f-labaj/Equatorial-Mount-MUM/Rendery/main_assembly_no_tele_CUT.png

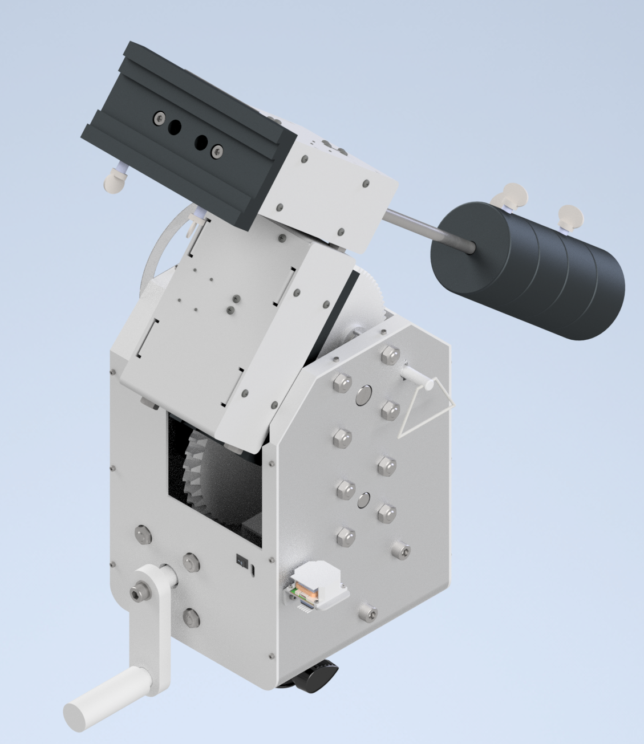
Rendery/main_assembly_no_tele_CUT.png
