f-labaj/Equatorial-Mount-MUM/Rendery/elevation_assembly_blacha_gieta_final.png

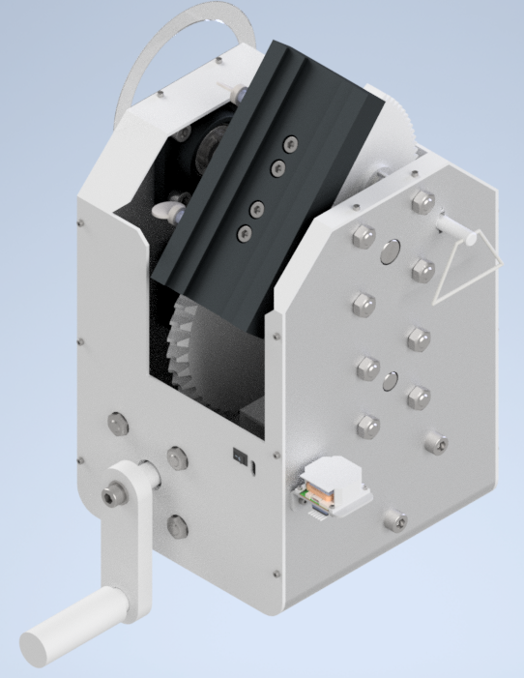
Rendery/elevation_assembly_blacha_gieta_final.png
