f-labaj/Equatorial-Mount-MUM/README.md

# Equatorial-Mount-MUM

Projekt autonomicznego montażu równikowego teleskopu wykonany jako zaliczenie przedmiotu Miniaturyzacja Urządzeń Mechatroniki na Wydziale Mechatroniki Politechniki Warszawskiej.
