f-labaj/Equatorial-Mount-MUM/Mechanika/Mechanizm elewacji i elektronika Filip/Links.txt

http://www.mitcalc.com/doc/gear4/help/en/gear4.htm

http://www.otvinta.com/rack.html

http://www3.telus.net/shebang/worm_gear_calculator.html

https://www.engineersedge.com/gears/worm_gear_formula_table_13534.htm

https://www.engineersedge.com/gears/worm_and_wormgear_design_13813.htm

https://en.wikipedia.org/wiki/Worm_drive - ślimak i zębatka ślimakowa

https://www.youtube.com/watch?v=pTLBtd6kPm8 - projektowanie ślimaka w Inventorze

https://en.wikipedia.org/wiki/Slider-crank_linkage - mechanizm korbowy
