f-labaj/Equatorial-Mount-MUM/Mechanika/Mechanizm elewacji i elektronika Filip/CAD/SKF 16006/Linki.txt

https://www.skf.com/group/products/rolling-bearings/ball-bearings/deep-groove-ball-bearings/productid-16006

https://www.ebmia.pl/lozyska-kulkowe-zwykle/70491-lozysko-kulkowe-zwykle-16006-a-2zfag.html
