f-labaj/Equatorial-Mount-MUM/Dokumentacja/17.05.20.png

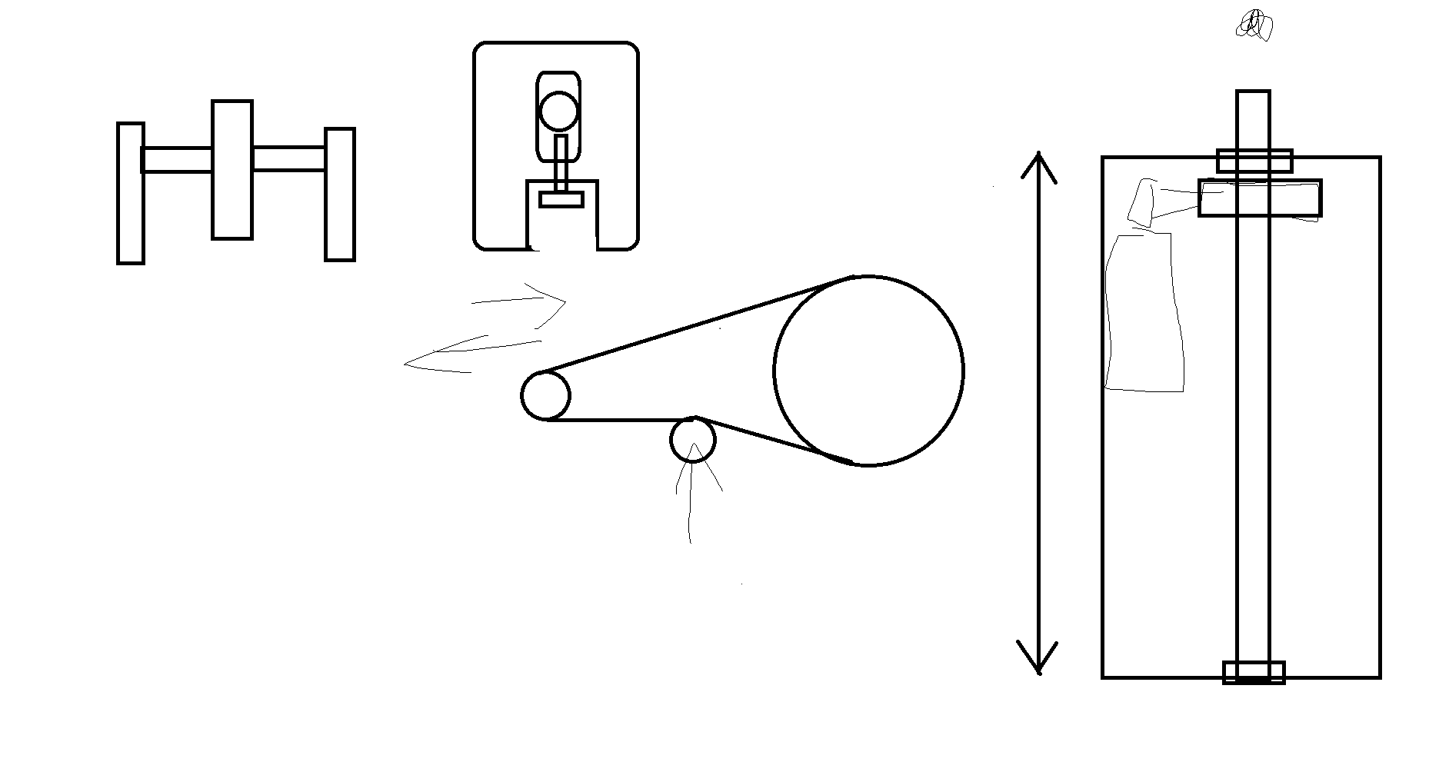
Dokumentacja/17.05.20.png
