f-labaj/Equatorial-Mount-MUM/Dokumentacja/MUM_rysunek_08_05_20.png

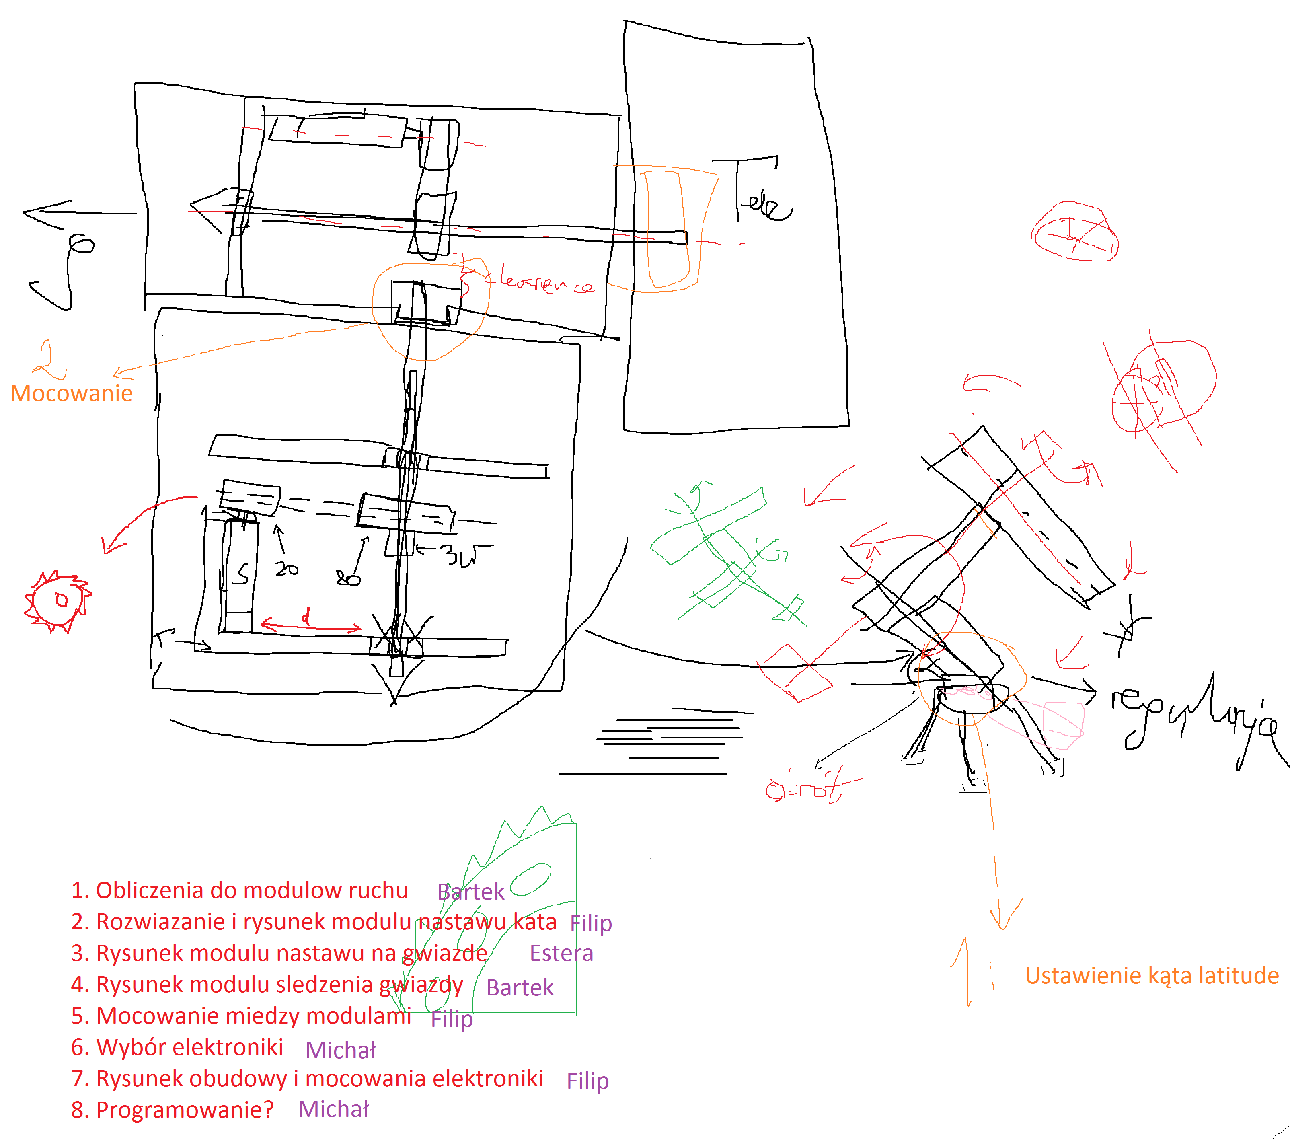
Dokumentacja/MUM_rysunek_08_05_20.png
