f-labaj/Equatorial-Mount-MUM/Mechanika/Mechanizm elewacji i elektronika Filip/CAD/117644510_296772538096710_5714717982539962324_n.png

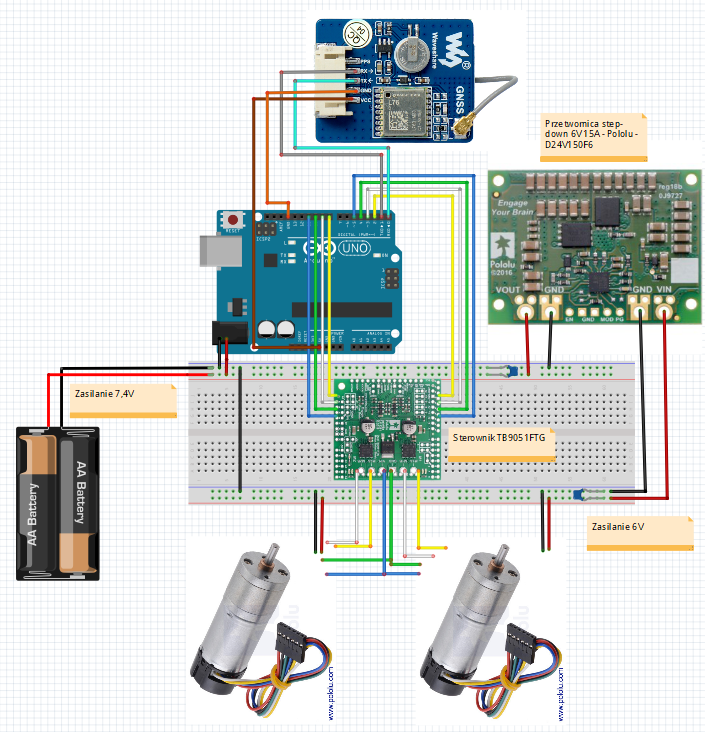
Mechanika/Mechanizm elewacji i elektronika Filip/CAD/117644510_296772538096710_5714717982539962324_n.png
