f-labaj/Equatorial-Mount-MUM/Mechanika/Mechanizm elewacji i elektronika Filip/CAD/CAD/Moduł GPS/L76X-GPS-Module-size.jpg

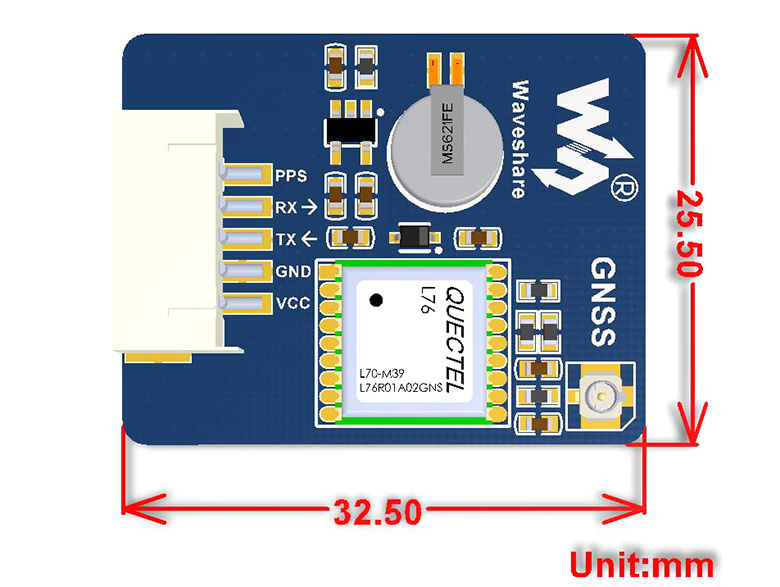
Mechanika/Mechanizm elewacji i elektronika Filip/CAD/CAD/Moduł GPS/L76X-GPS-Module-size.jpg
