f-labaj/Equatorial-Mount-MUM/Mechanika/Mechanizm elewacji i elektronika Filip/CAD/manfrotto-458b-tripod/Renderings/Manfrotto 458B Tripod - 2.jpg

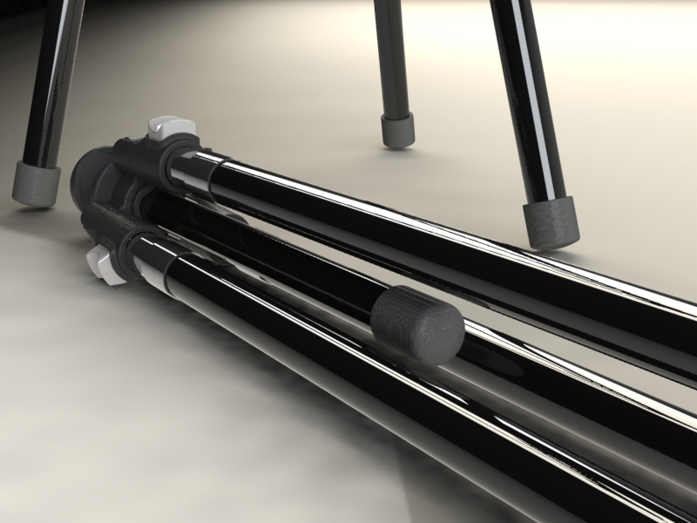
Mechanika/Mechanizm elewacji i elektronika Filip/CAD/manfrotto-458b-tripod/Renderings/Manfrotto 458B Tripod - 2.jpg
