f-labaj/Equatorial-Mount-MUM/Mechanika/Mechanizm elewacji i elektronika Filip/CAD/manfrotto-494rc2-tripod-head.snapshot.1/2012-11-06 Manfrotto Tripod Head.jpg

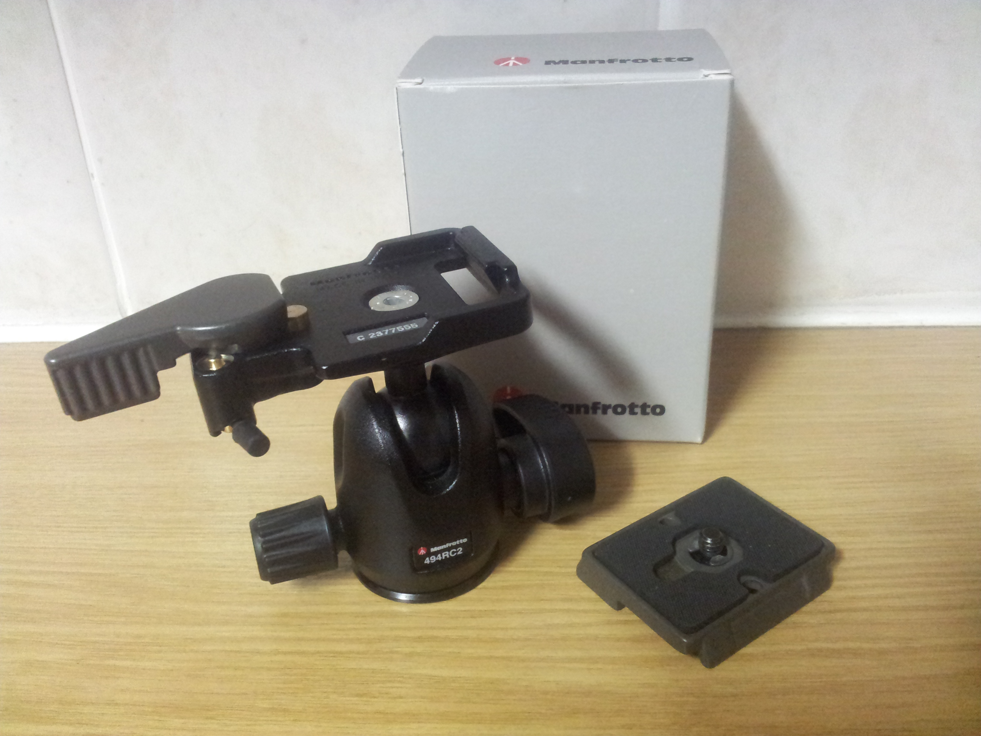
Mechanika/Mechanizm elewacji i elektronika Filip/CAD/manfrotto-494rc2-tripod-head.snapshot.1/2012-11-06 Manfrotto Tripod Head.jpg
