f-labaj/Equatorial-Mount-MUM/Mechanika/Mechanizm elewacji i elektronika Filip/CAD/manfrotto-494rc2-tripod-head.snapshot.1/Manfrotto - 494RC2 Head - Render 01.bmp

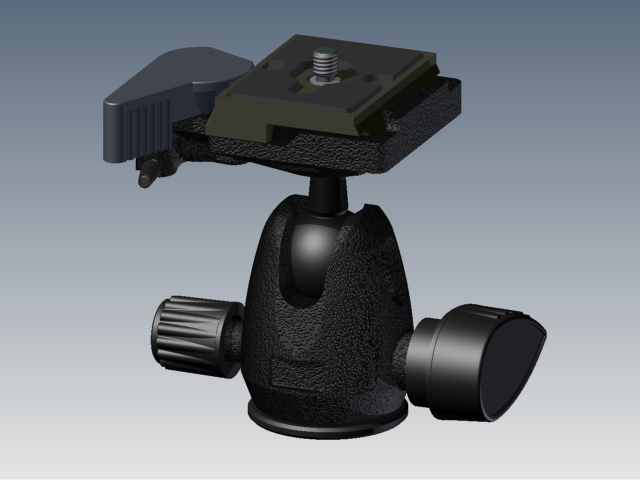
Mechanika/Mechanizm elewacji i elektronika Filip/CAD/manfrotto-494rc2-tripod-head.snapshot.1/Manfrotto - 494RC2 Head - Render 01.bmp
