f-labaj/Equatorial-Mount-MUM/Mechanika/Mechanizm elewacji i elektronika Filip/CAD/manfrotto-quick-release-plate/manfrotto_01.jpg

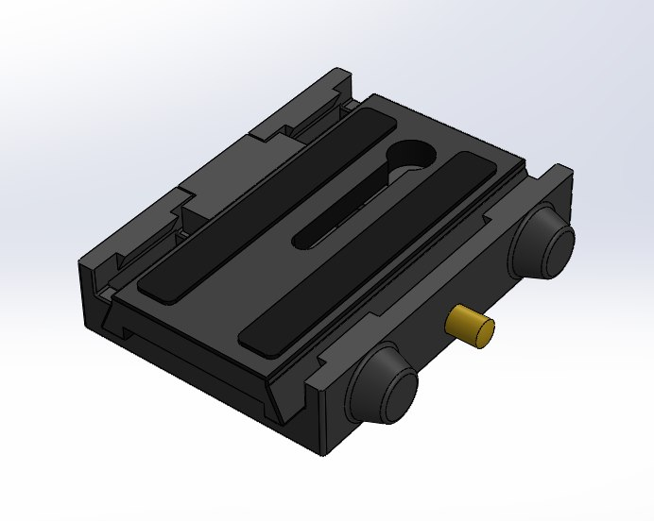
Mechanika/Mechanizm elewacji i elektronika Filip/CAD/manfrotto-quick-release-plate/manfrotto_01.jpg
