f-labaj/Equatorial-Mount-MUM/Mechanika/Mechanizm elewacji i elektronika Filip/CAD/manfrotto-quick-release-plate/manfrotto_03.jpg

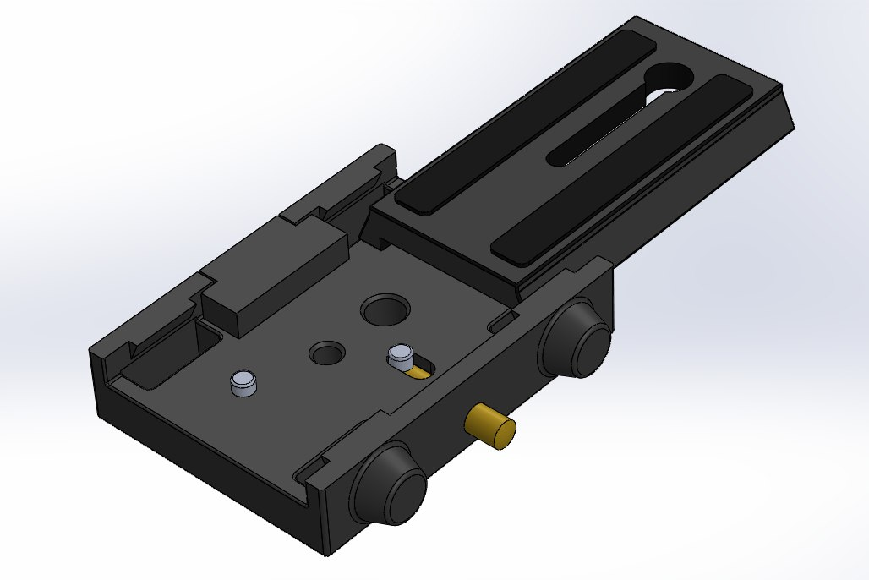
Mechanika/Mechanizm elewacji i elektronika Filip/CAD/manfrotto-quick-release-plate/manfrotto_03.jpg
