f-labaj/Equatorial-Mount-MUM/Mechanika/Mechanizm elewacji i elektronika Filip/CAD/usb_a_mini.jpg

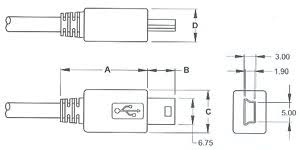
Mechanika/Mechanizm elewacji i elektronika Filip/CAD/usb_a_mini.jpg
