f-labaj/Equatorial-Mount-MUM/Mechanika/Mechanizm elewacji i elektronika Filip/przykład_elewacji_artylerii_z_kompensacją_D30_122mm.png

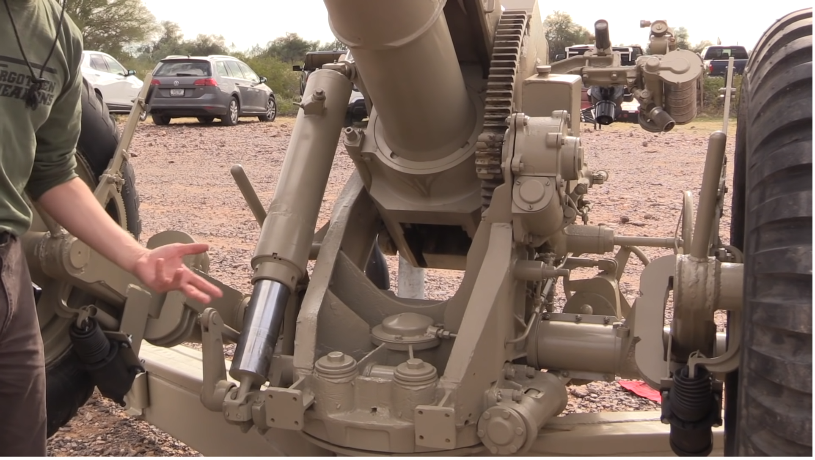
Mechanika/Mechanizm elewacji i elektronika Filip/przykład_elewacji_artylerii_z_kompensacją_D30_122mm.png
