f-labaj/Equatorial-Mount-MUM/Mechanika/Mechanizm elewacji i elektronika Filip/schemat_mechanizmu_elewacji.png

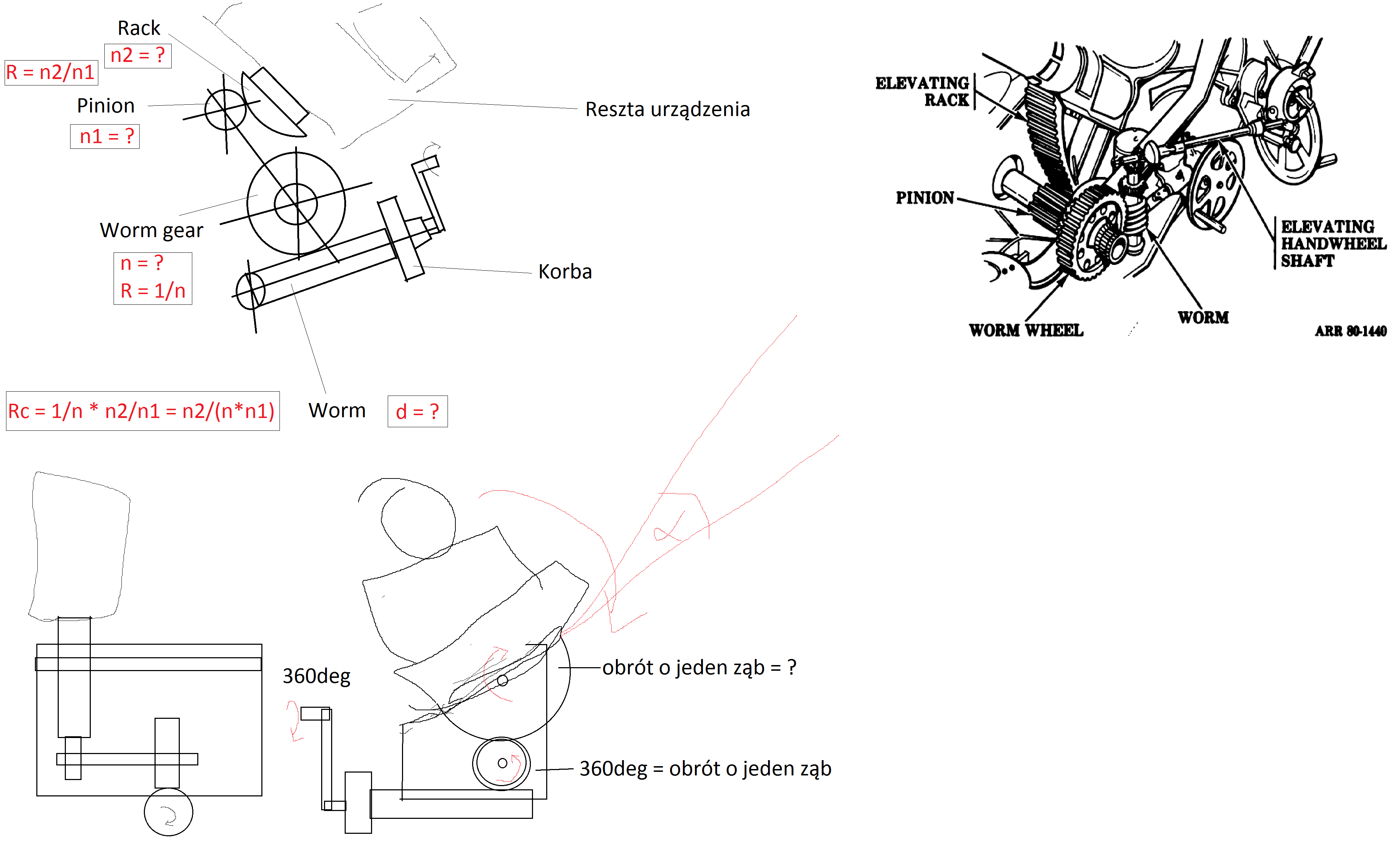
Mechanika/Mechanizm elewacji i elektronika Filip/schemat_mechanizmu_elewacji.png
