f-labaj/Equatorial-Mount-MUM/Mechanika/Moduł obrotu RET Estera/projejt/projejt/kolona50/Renderings/1.JPG

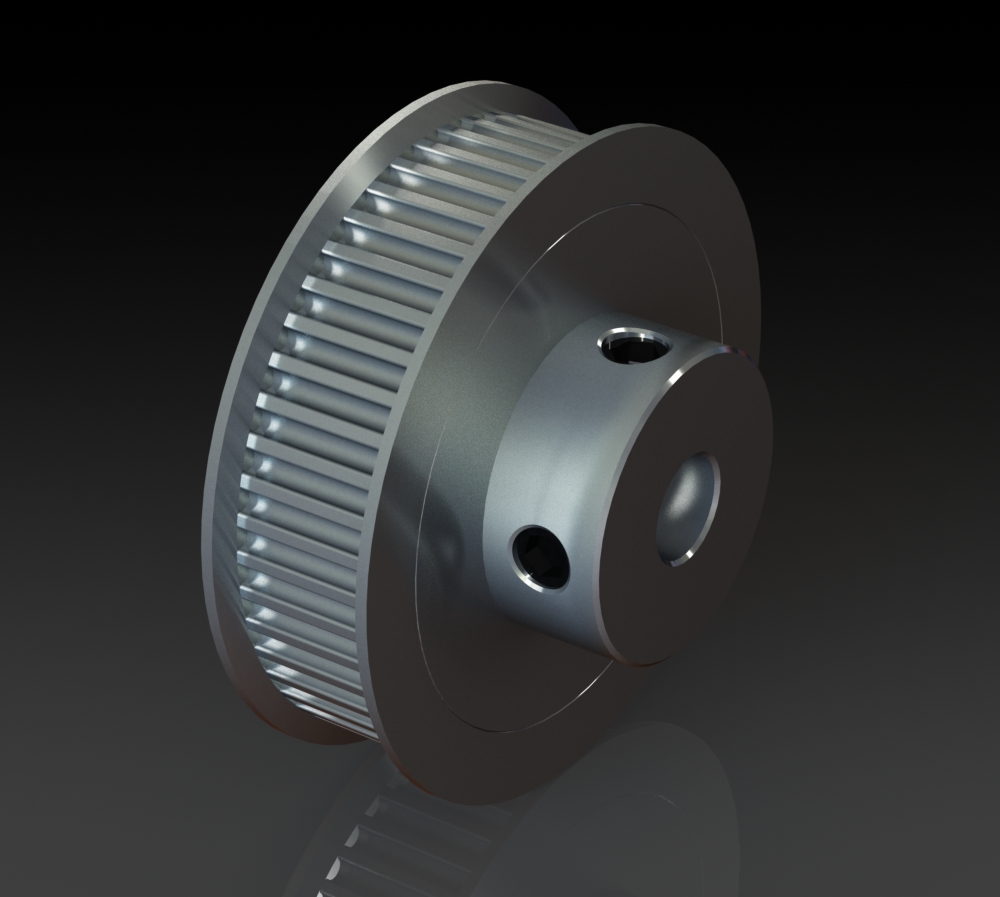
Mechanika/Moduł obrotu RET Estera/projejt/projejt/kolona50/Renderings/1.JPG
