f-labaj/Equatorial-Mount-MUM/Rendery/mechanizm_elewacji.png

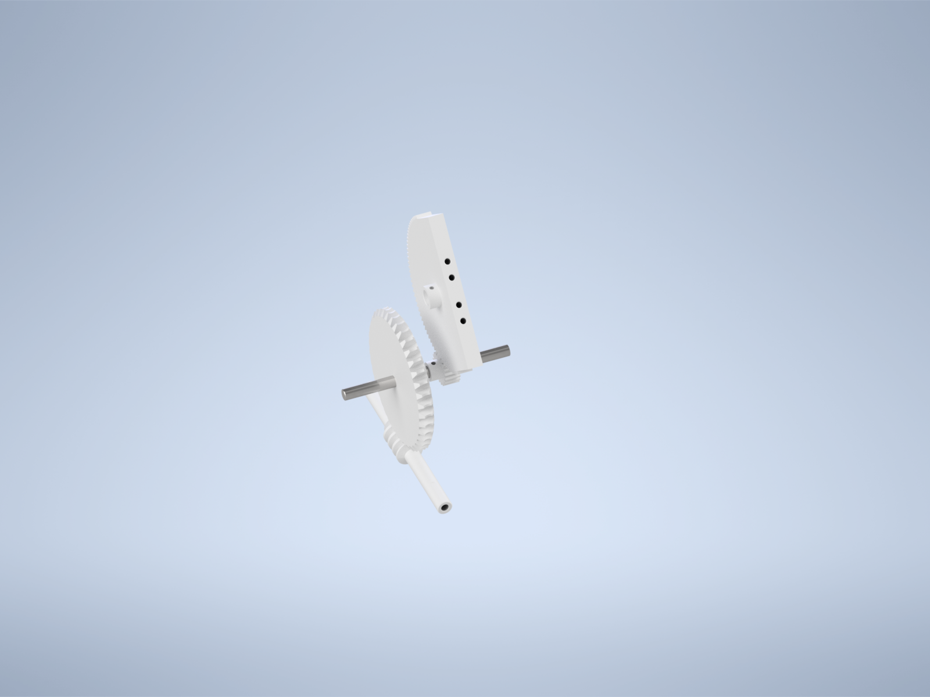
Rendery/mechanizm_elewacji.png
