f-labaj/Equatorial-Mount-MUM/Rendery/sprezyna_1.png

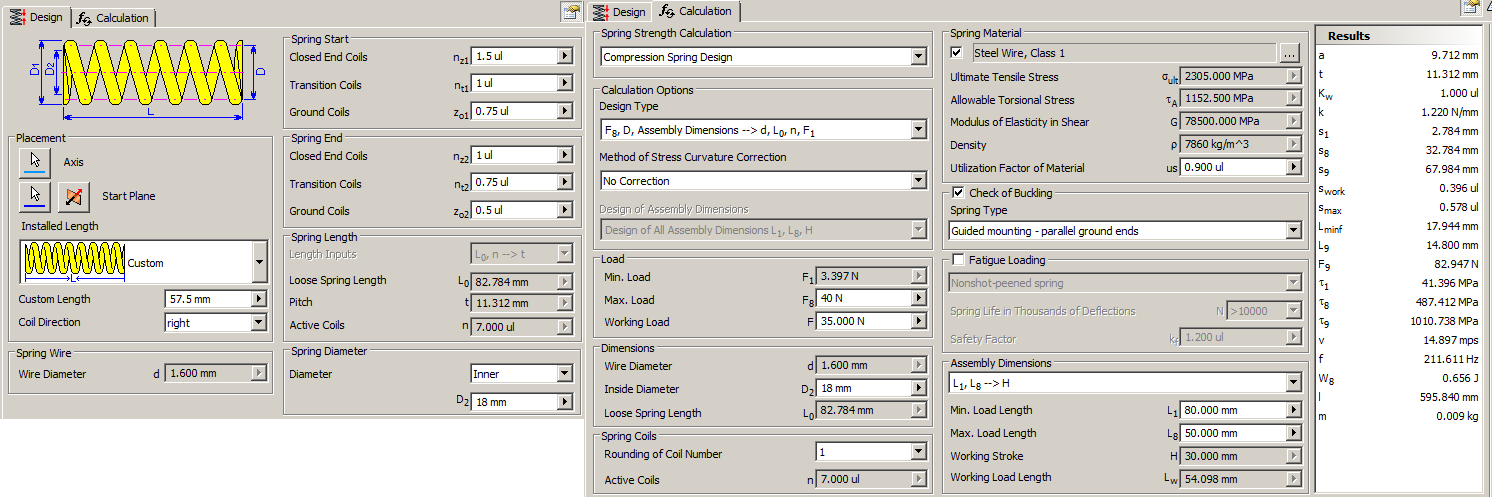
Rendery/sprezyna_1.png
