f-labaj/Equatorial-Mount-MUM/Rendery/sprezyna_2.png

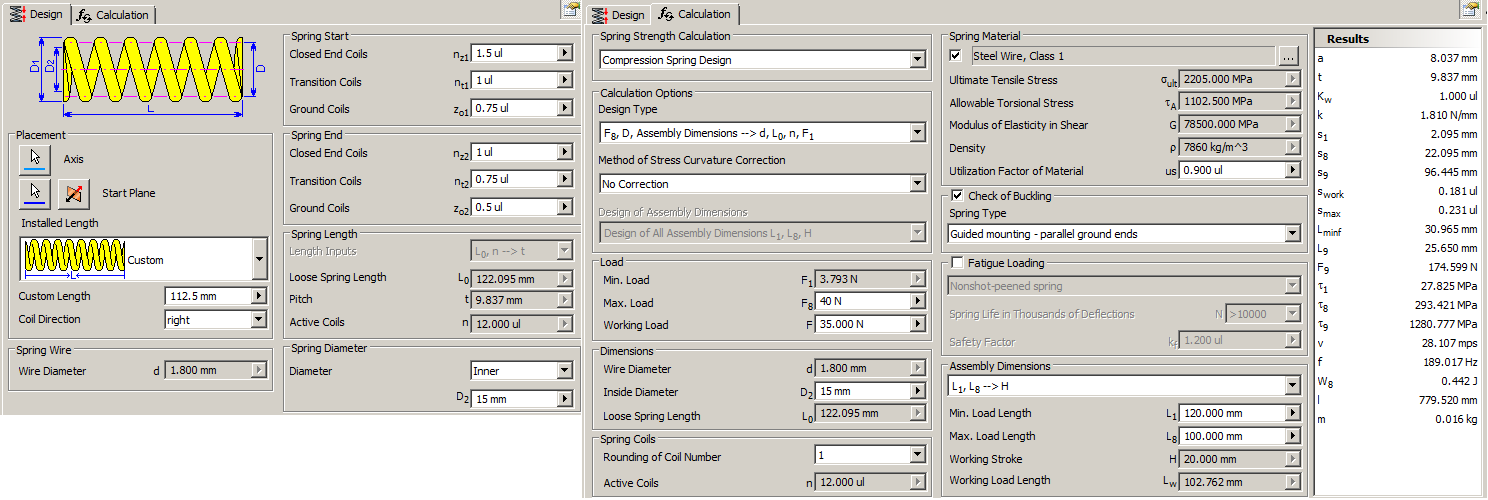
Rendery/sprezyna_2.png
