f-labaj/Equatorial-Mount-MUM/Symulacje/stuff do symulacji/mechanizm_rzut2.png

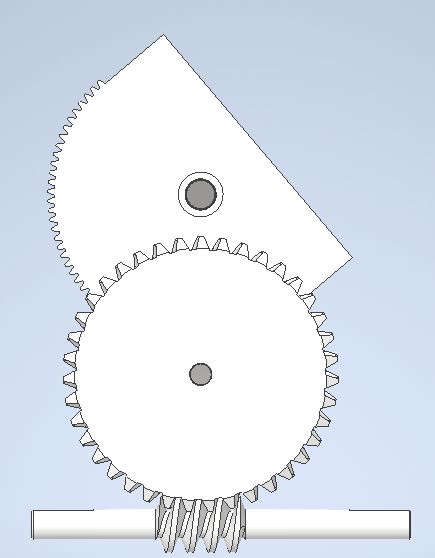
Symulacje/stuff do symulacji/mechanizm_rzut2.png
