f-labaj/Equatorial-Mount-MUM/Symulacje/stuff do symulacji/mechanizm_rzut3.png

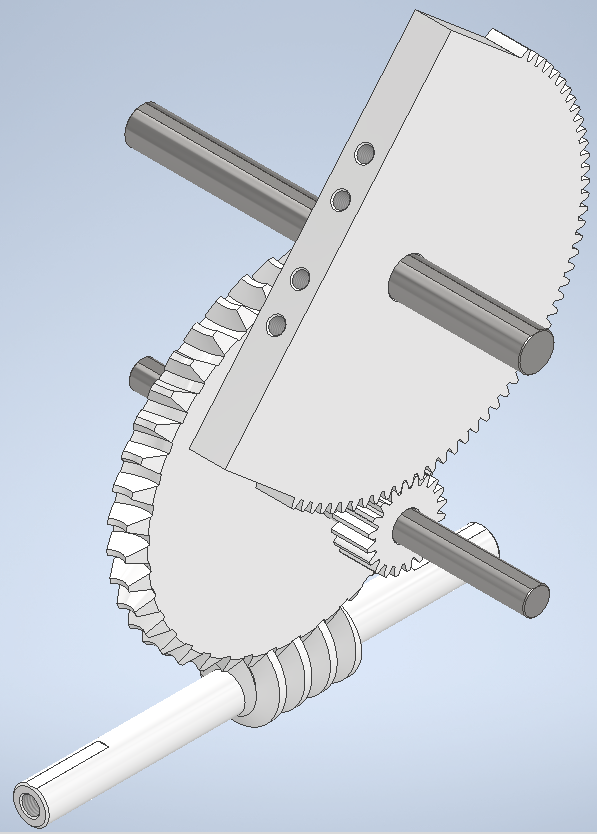
Symulacje/stuff do symulacji/mechanizm_rzut3.png
