f-labaj/Equatorial-Mount-MUM/Symulacje/stuff do symulacji/mechanizm_rzut.png

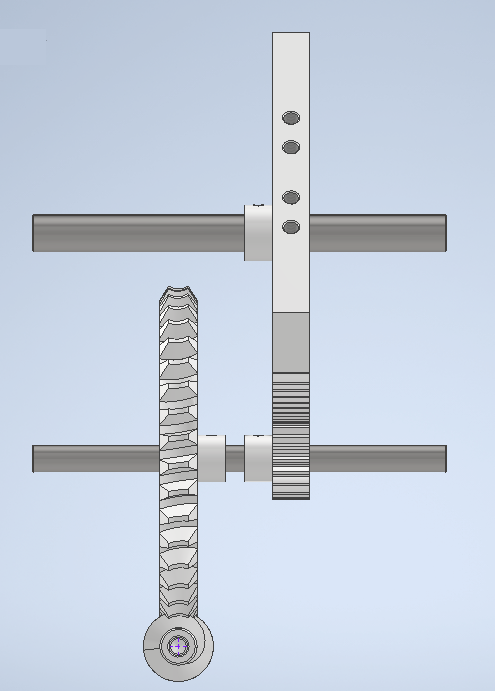
Symulacje/stuff do symulacji/mechanizm_rzut.png
