f-labaj/Equatorial-Mount-MUM/Symulacje/Zrzuty ekranu/jakosc_siatki.png

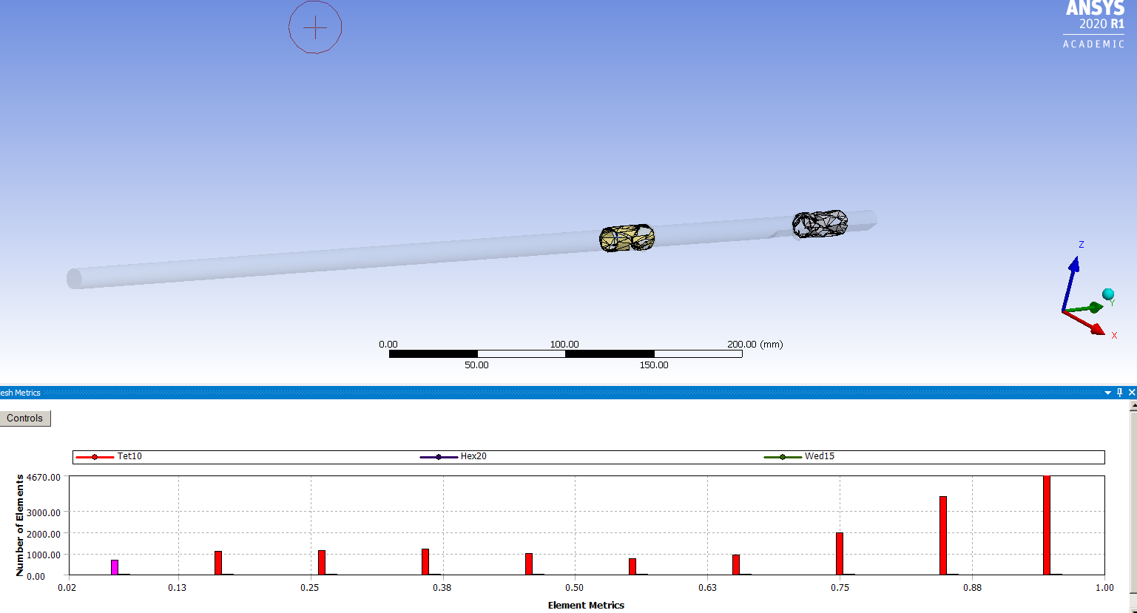
Symulacje/Zrzuty ekranu/jakosc_siatki.png
