f-labaj/Equatorial-Mount-MUM/Symulacje/Zrzuty ekranu/odksztalcenia.png

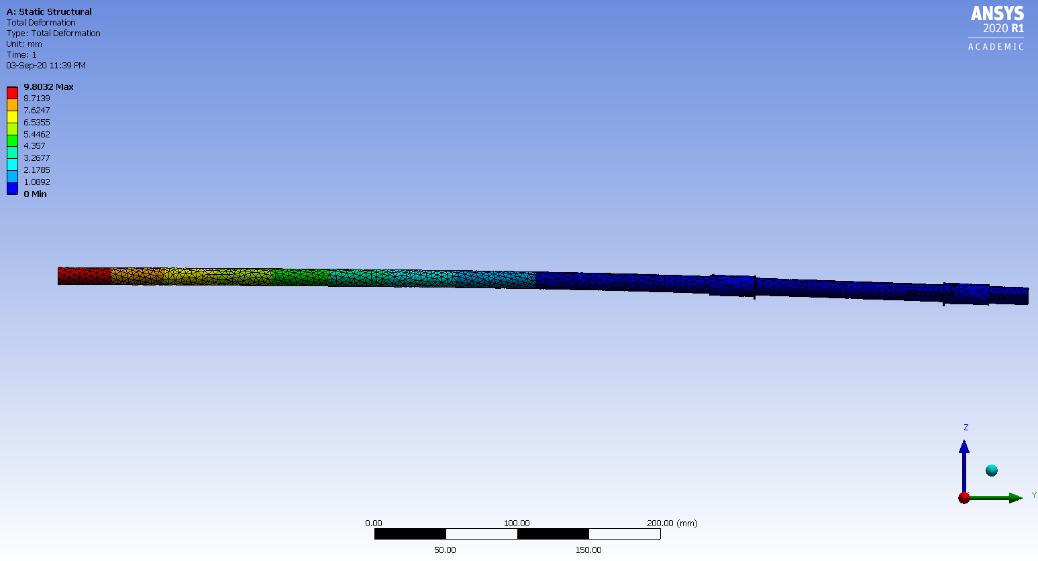
Symulacje/Zrzuty ekranu/odksztalcenia.png
