f-labaj/Equatorial-Mount-MUM/Symulacje/Zrzuty ekranu/statystyka_siatki.png

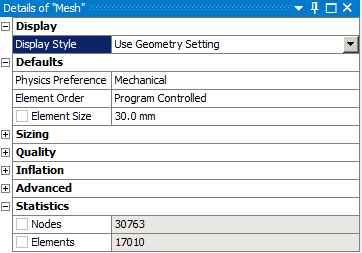
Symulacje/Zrzuty ekranu/statystyka_siatki.png
