f-labaj/Equatorial-Mount-MUM/Mechanika/Mechanizm elewacji i elektronika Filip/CAD/manfrotto-458b-tripod/Manfrotto 458B Tripod Assembly.SLDASM

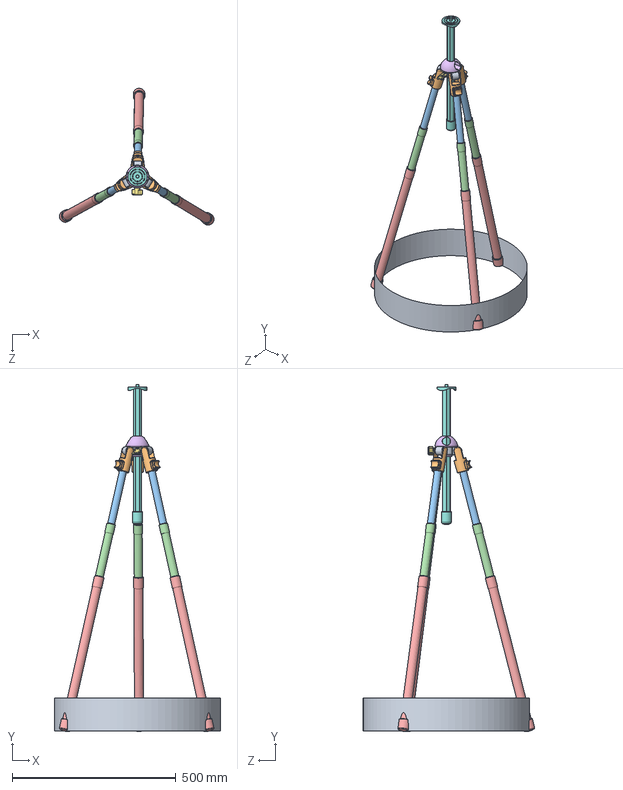
[picture p157: CAD file, 2020-08-21]
Mechanika/Mechanizm elewacji i elektronika Filip/CAD/manfrotto-458b-tripod/Manfrotto 458B Tripod Assembly.SLDASM
507.9 x 1059.5 x 523.8 mm
Manfrotto 458B - Leg Spider
Manfrotto 458B - Leg Knuckle x 3
Manfrotto 458B - Upper Leg x 3
Manfrotto 458B - Middle Leg x 3
Manfrotto 458B - Lower Leg x 3
Manfrotto 458B - Center Post Clamp
x20703-05
Manfrotto 458B - Center Post
