f-labaj/Equatorial-Mount-MUM/Mechanika/Mechanizm elewacji i elektronika Filip/CAD/manfrotto-494rc2-tripod-head.snapshot.1/Manfrotto - 494RC2 Head Assy.stp

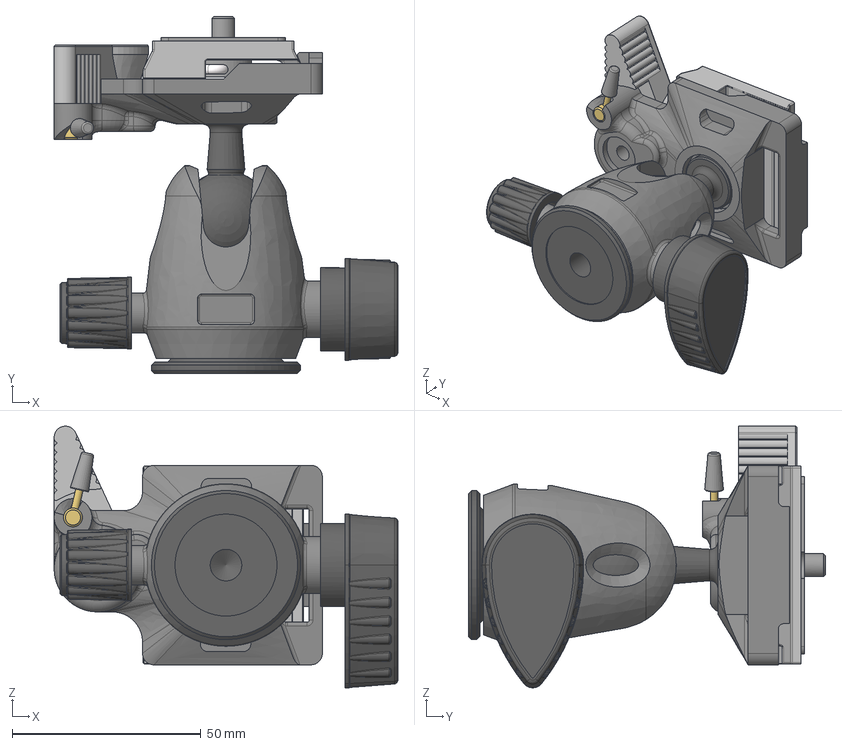
[picture p158: CAD file, 2020-08-21]
Mechanika/Mechanizm elewacji i elektronika Filip/CAD/manfrotto-494rc2-tripod-head.snapshot.1/Manfrotto - 494RC2 Head Assy.stp
91.0 x 94.5 x 69.3 mm
Base Casting
Base Plate
Mount Casting
Ball Joint
ISO 10642 M5 x 16
Quick Release Mounting
Thumb Screw
Thumb Screw Handle
IS 3075-3 3.2
Quick Release Rubber Pad
Quick Release Catch
Friction Knob
Locking Knob
Manfrotto Logo 01 - 1
Manfrotto Logo 01 - 2
Locking Pin
Locking Pin Lever
Locking Pin Lever Rubber
