f-labaj/Equatorial-Mount-MUM/Mechanika/Mechanizm elewacji i elektronika Filip/CAD/manfrotto-quick-release-plate/manfrotto_PL-577_main.SLDPRT

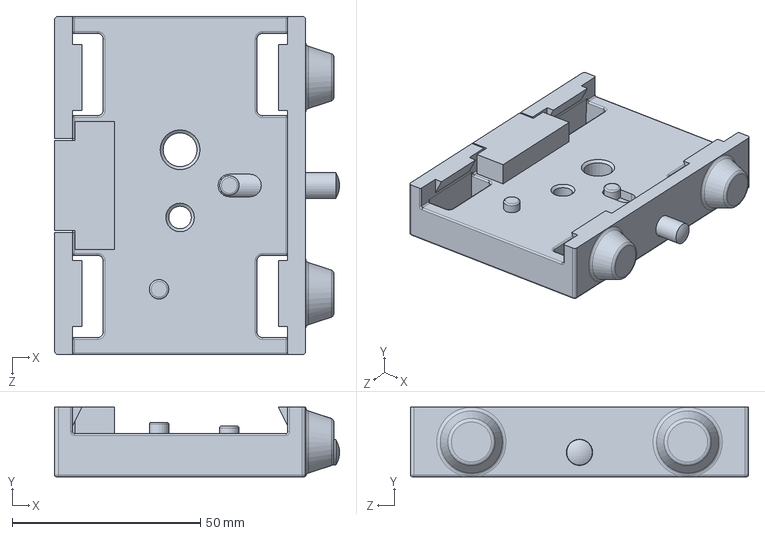
[picture p159: CAD file, 2020-08-21]
Mechanika/Mechanizm elewacji i elektronika Filip/CAD/manfrotto-quick-release-plate/manfrotto_PL-577_main.SLDPRT
75.8 x 18.5 x 90.0 mm
