f-labaj/Equatorial-Mount-MUM/Mechanika/Mechanizm elewacji i elektronika Filip/CAD/manfrotto-458b-tripod/Manfrotto 458B - Leg Assembly.SLDASM

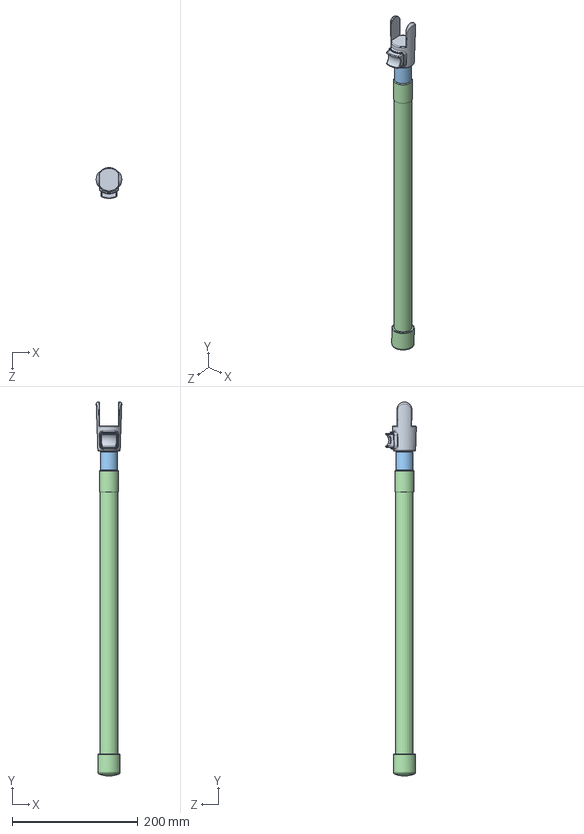
[picture p160: CAD file, 2020-08-21]
Mechanika/Mechanizm elewacji i elektronika Filip/CAD/manfrotto-458b-tripod/Manfrotto 458B - Leg Assembly.SLDASM
40.7 x 595.0 x 49.1 mm
Manfrotto 458B - Leg Knuckle
Manfrotto 458B - Upper Leg
Manfrotto 458B - Middle Leg
Manfrotto 458B - Lower Leg
