f-labaj/Equatorial-Mount-MUM/Mechanika/Mechanizm elewacji i elektronika Filip/CAD/manfrotto-quick-release-plate/Manfrotto_501_PL_assem_01.SLDASM

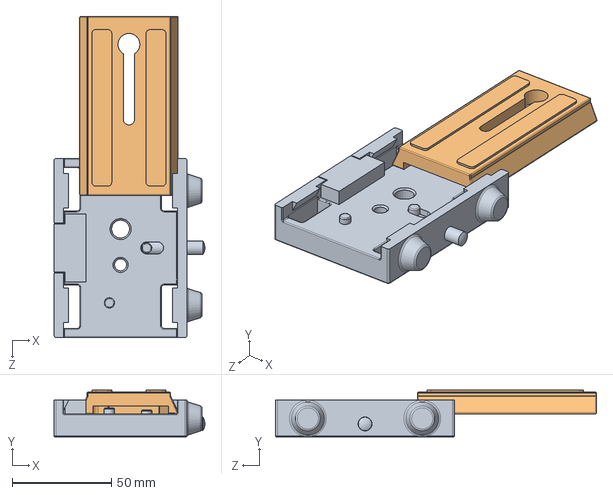
[picture p161: CAD file, 2020-08-21]
Mechanika/Mechanizm elewacji i elektronika Filip/CAD/manfrotto-quick-release-plate/Manfrotto_501_PL_assem_01.SLDASM
75.8 x 23.5 x 161.3 mm
manfrotto_gyorscseretalp_also_577
manfrotto_501_PL
