f-labaj/Equatorial-Mount-MUM/Mechanika/Mechanizm elewacji i elektronika Filip/CAD/CAD/Moduł GPS/EM406 GPS Module.SLDPRT

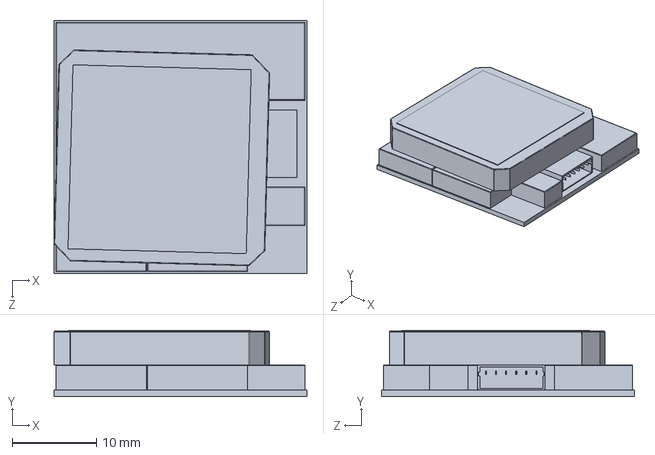
[picture p162: CAD file, 2020-08-17]
Mechanika/Mechanizm elewacji i elektronika Filip/CAD/CAD/Moduł GPS/EM406 GPS Module.SLDPRT
30.1 x 7.90 x 30.1 mm
