f-labaj/Equatorial-Mount-MUM/Mechanika/Mechanizm elewacji i elektronika Filip/CAD/CAD/small-power-switches-rocker-type-10-5x15mm-1.snapshot.4/KCD1-11-3P-Off.step

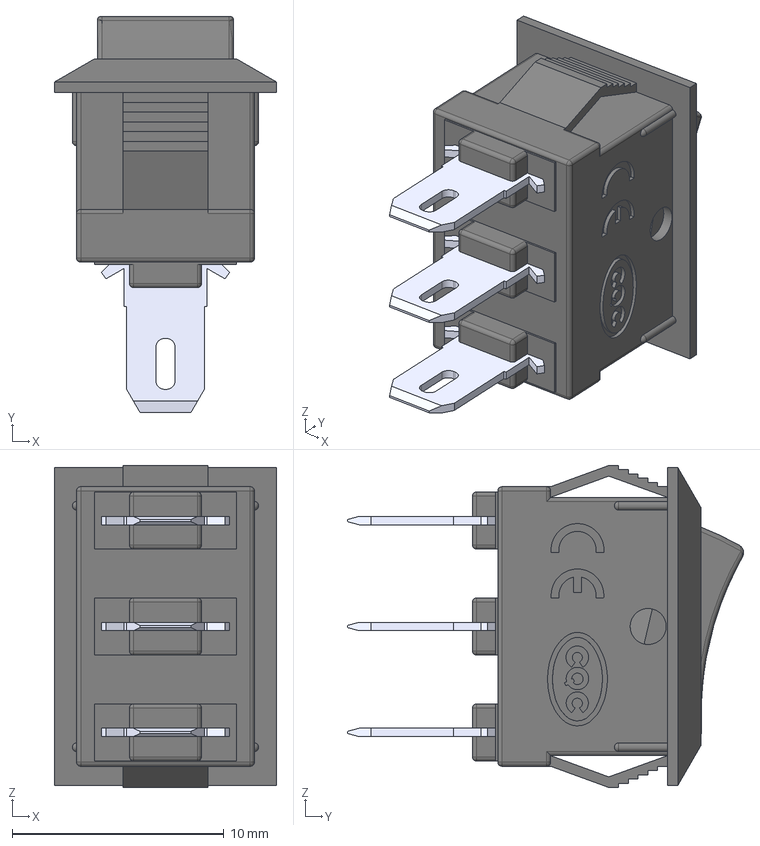
[picture p163: CAD file, 2020-08-29]
Mechanika/Mechanizm elewacji i elektronika Filip/CAD/CAD/small-power-switches-rocker-type-10-5x15mm-1.snapshot.4/KCD1-11-3P-Off.step
10.5 x 18.7 x 15.2 mm
