f-labaj/Equatorial-Mount-MUM/Mechanika/Mechanizm elewacji i elektronika Filip/CAD/CAD/Standoff_M3_14mm.step

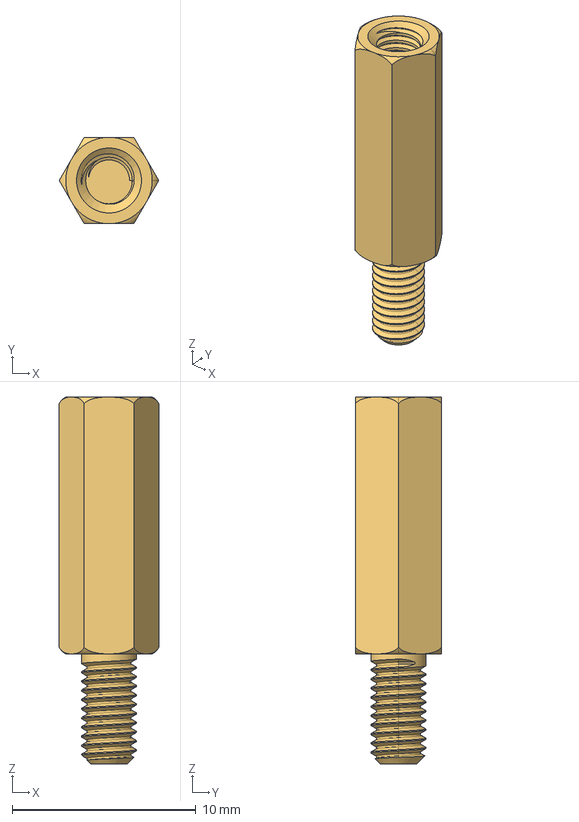
[picture p164: CAD file, 2020-08-29]
Mechanika/Mechanizm elewacji i elektronika Filip/CAD/CAD/Standoff_M3_14mm.step
5.43 x 4.70 x 20.0 mm
