f-labaj/Equatorial-Mount-MUM/Mechanika/Mechanizm elewacji i elektronika Filip/CAD/Protractor Rev 01.SLDPRT

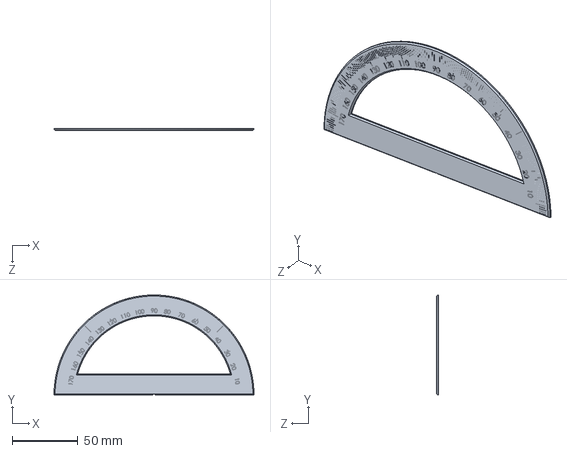
[picture p165: CAD file, 2020-08-30]
Mechanika/Mechanizm elewacji i elektronika Filip/CAD/Protractor Rev 01.SLDPRT
152.4 x 76.2 x 1.71 mm
