f-labaj/Equatorial-Mount-MUM/Mechanika/Moduł obrotu RET Estera/projejt/projejt/kolo2/GT2_20T-sh8.STEP

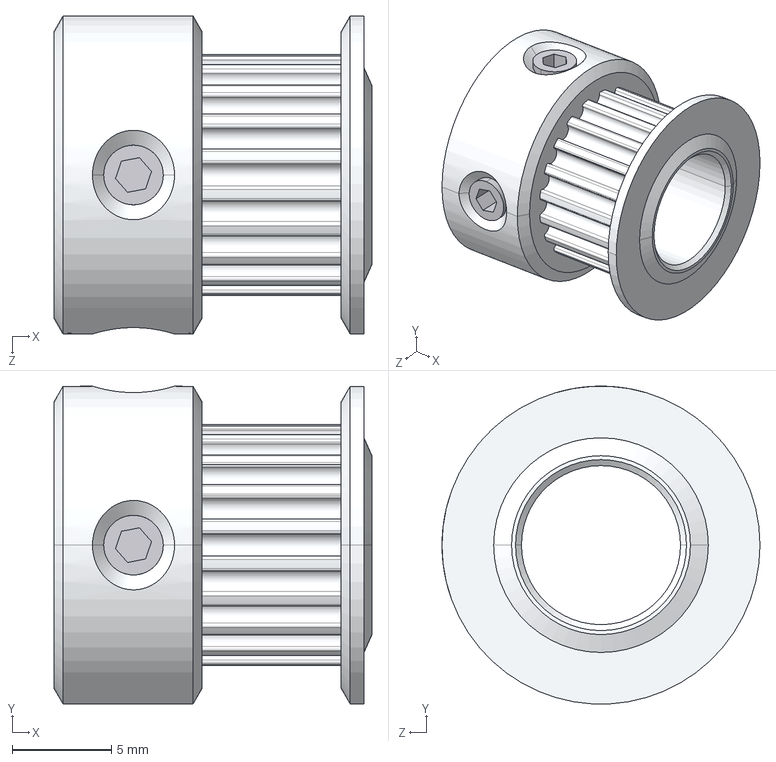
[picture p166: CAD file, 2020-08-21]
Mechanika/Moduł obrotu RET Estera/projejt/projejt/kolo2/GT2_20T-sh8.STEP
16.0 x 16.0 x 16.0 mm
