f-labaj/Equatorial-Mount-MUM/Mechanika/Moduł obrotu RET Estera/projejt/projejt/kololozyskowane/GT2 Timing Idler Pulley, Configurable, 16T W6 B3 With T.STEP

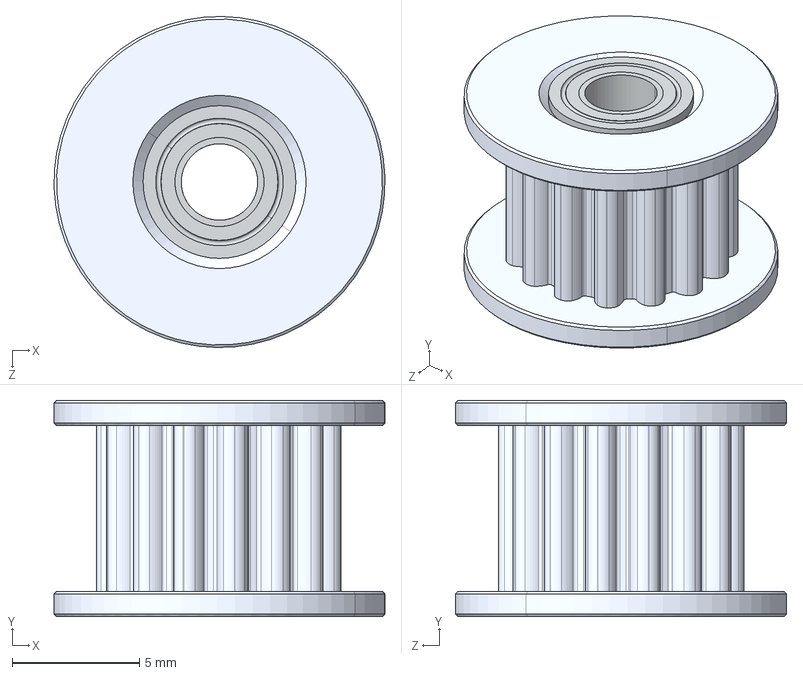
[picture p167: CAD file, 2020-08-21]
Mechanika/Moduł obrotu RET Estera/projejt/projejt/kololozyskowane/GT2 Timing Idler Pulley, Configurable, 16T W6 B3 With T.STEP
13.0 x 8.50 x 13.0 mm
Body, GT2 Timing Idler Pulley, Configurable_16T W6 B3 With T
Bearing Outer Ring, GT2 Timing Idler Pulley, Configurable_3 mm Bore, 6 mm OD x 2
Bearing Inner Ring, GT2 Timing Idler Pulley, Configurable_3 mm Bore, 6 mm OD x 2
Bearing Seal, GT2 Timing Idler Pulley, Configurable_3 mm Bore, 6 mm OD x 4
Bearing Ball, GT2 Timing Idler Pulley, Configurable_1 mm x 16
