f-labaj/Equatorial-Mount-MUM/Mechanika/Moduł obrotu RET Estera/projejt/projejt/kolona50/GT2_50teeth.SLDPRT

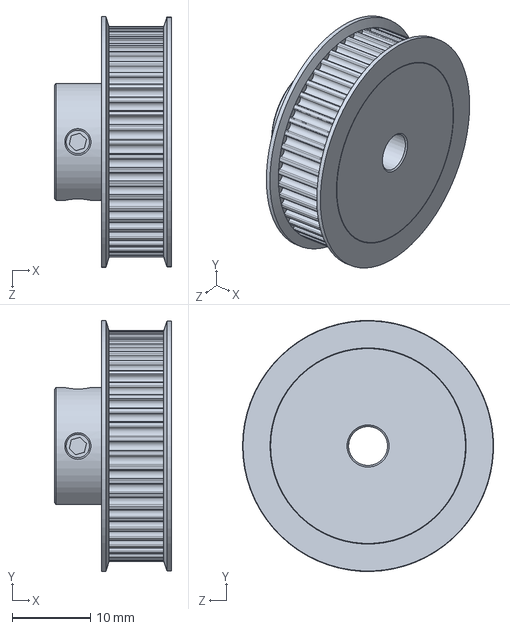
[picture p168: CAD file, 2020-08-21]
Mechanika/Moduł obrotu RET Estera/projejt/projejt/kolona50/GT2_50teeth.SLDPRT
15.0 x 32.2 x 32.1 mm
