f-labaj/Equatorial-Mount-MUM/Mechanika/Moduł obrotu RET Estera/projejt/projejt/Star Knob M6 Male.STEP

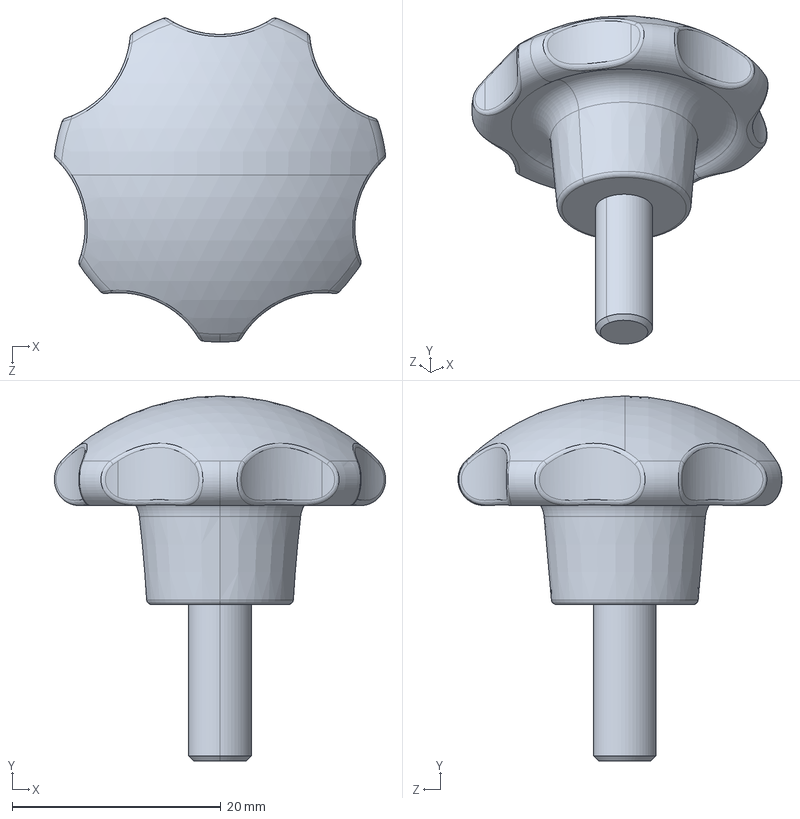
[picture p169: CAD file, 2020-08-26]
Mechanika/Moduł obrotu RET Estera/projejt/projejt/Star Knob M6 Male.STEP
31.8 x 35.0 x 31.1 mm
