f-labaj/Equatorial-Mount-MUM/Mechanika/Teleskop/Teleskop.stp

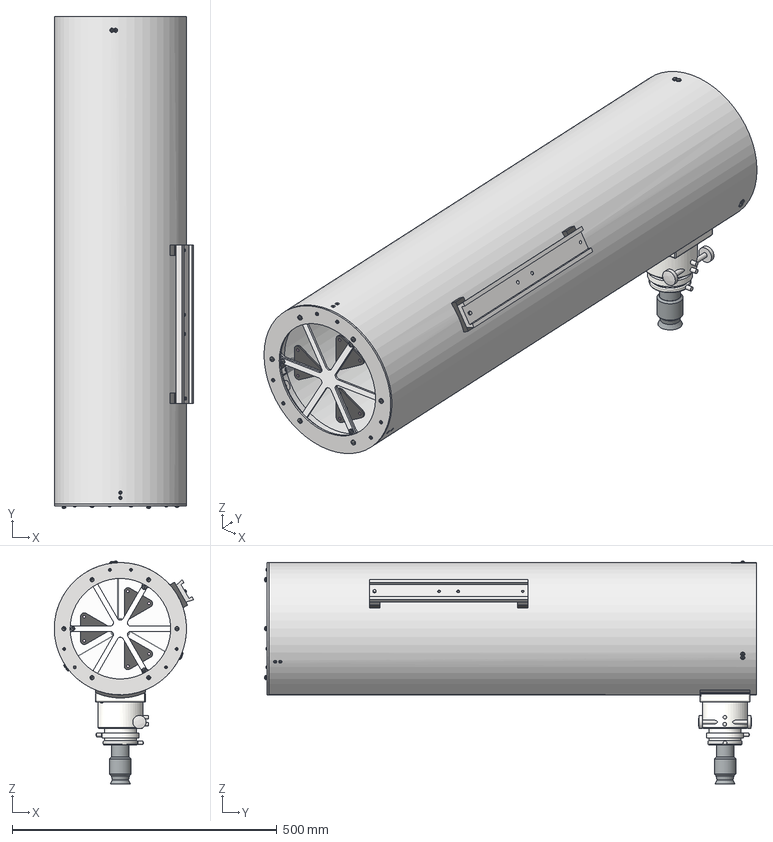
[picture p170: CAD file, 2020-08-17]
Mechanika/Teleskop/Teleskop.stp
263.6 x 930.0 x 421.4 mm
RingPrimaryMirror
NowyKatownik x 3
ISO 7045 - M3 x 5 - 4.8 - H x 12
SpiderPrimaryMirror
ISO 7045 - M4 x 6 - 4.8 - Z x 10
ISO 7045 - M4 x 5 - 4.8 - Z x 6
PrimaryMirror
BearingBall x 3
HandlePrimaryMirror x 3
GumoweTrzymadlo x 9
Mirror
Część4 x 3
S-M3-0 ZI x 6
Trzymacz x 3
ISO 7045 - M2,5 x 5 - 4.8 - Z x 7
ISO 4762 - M3 x 6 x 6
tuba2
Część1
podporka_pajaka
trzymadlo
srodek_pajaka
wkret_z_kulka
ramie_pajaka x 3
ISO 2009 - M3 x 12 x 3
ISO 1207 - M3 x 6 x 3
ISO 4035 - M3 x 6
szyna
podkladka x 2
ANSI B18.6.2 - 1/4-20 UNC - 1
wyciag_1
Screw GB 836 M4 x 12 x 5
Screw GB 840 A M8 x 30 x 2
okular
dopasowywacz
podkladka2 x 2
ISO 4035 - M4 x 4
ISO 2009 - M4 x 35 x 3
