f-labaj/Equatorial-Mount-MUM/Mechanika/Uchwyty, elementy i inne/microswitch-ss-3gl13sl-1.snapshot.2/limit-switch-bottomcase.SLDPRT

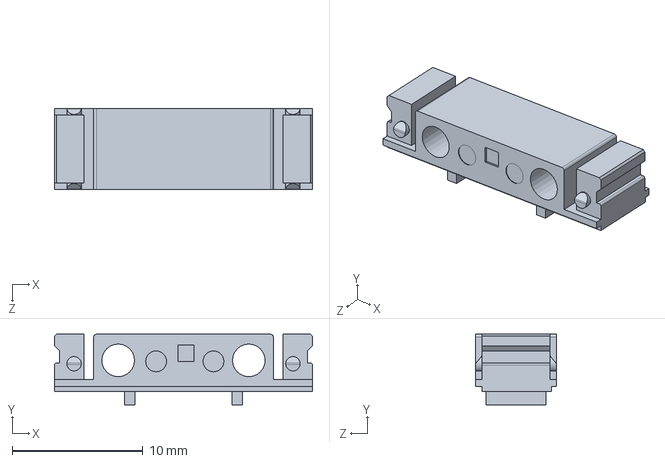
[picture p171: CAD file, 2020-08-29]
Mechanika/Uchwyty, elementy i inne/microswitch-ss-3gl13sl-1.snapshot.2/limit-switch-bottomcase.SLDPRT
19.8 x 5.40 x 6.20 mm
