f-labaj/Equatorial-Mount-MUM/Symulacje/Analiza naprężeń.stp

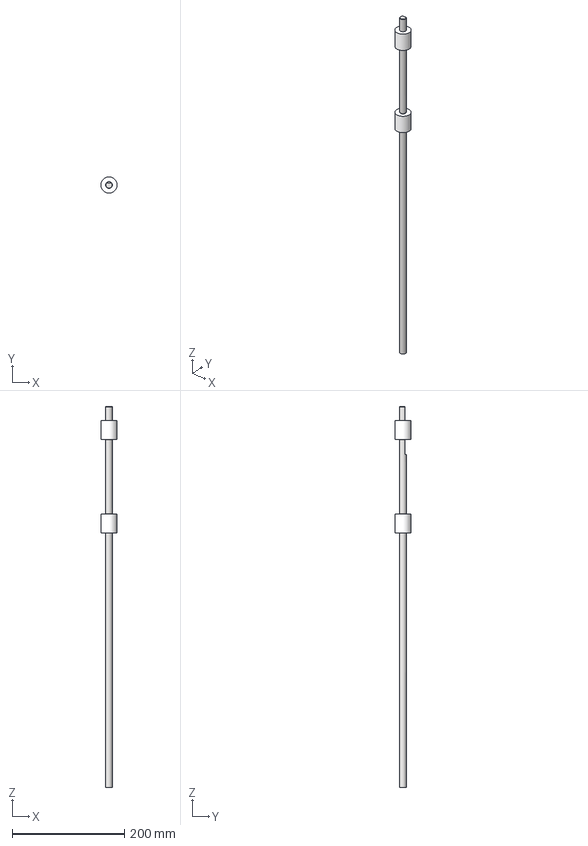
[picture p172: CAD file, 2020-09-01]
Symulacje/Analiza naprężeń.stp
28.9 x 28.9 x 678.0 mm
walek2
Część2 x 2
