f-labaj/Equatorial-Mount-MUM/Symulacje/stuff do symulacji/izolacja_pelny.igs

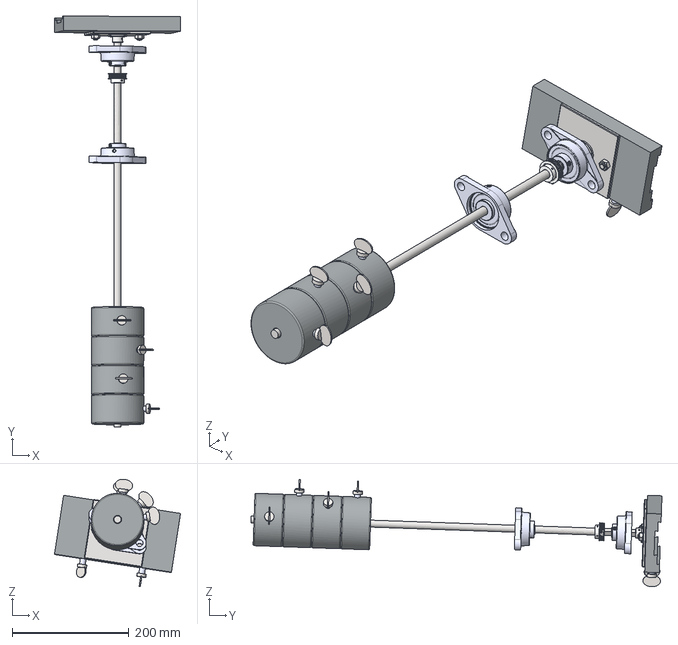
[picture p173: CAD file, 2020-09-04]
Symulacje/stuff do symulacji/izolacja_pelny.igs
216.2 x 705.1 x 184.4 mm
