f-labaj/Equatorial-Mount-MUM/Mechanika/Mechanizm elewacji i elektronika Filip/CAD/Battery 18650.SLDPRT

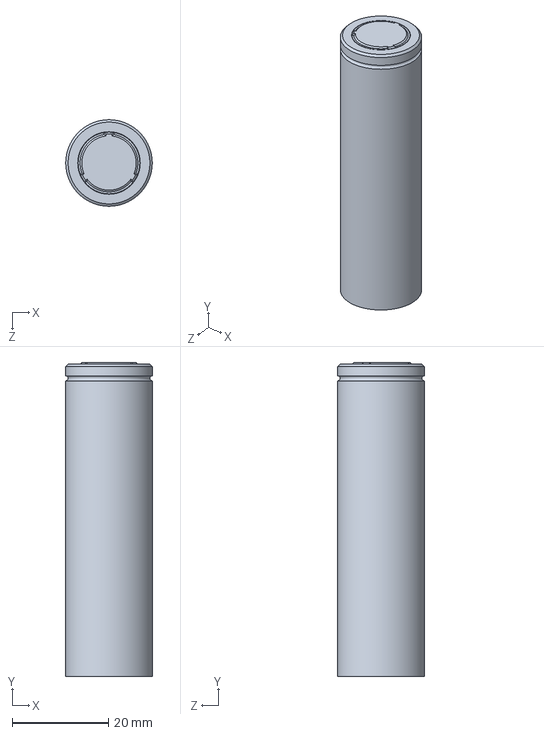
[picture p174: CAD file, 2020-08-29]
Mechanika/Mechanizm elewacji i elektronika Filip/CAD/Battery 18650.SLDPRT
18.0 x 65.3 x 18.0 mm
