f-labaj/Equatorial-Mount-MUM/Mechanika/Mechanizm elewacji i elektronika Filip/CAD/CAD/HC_05 Blue Tooth Module.stp

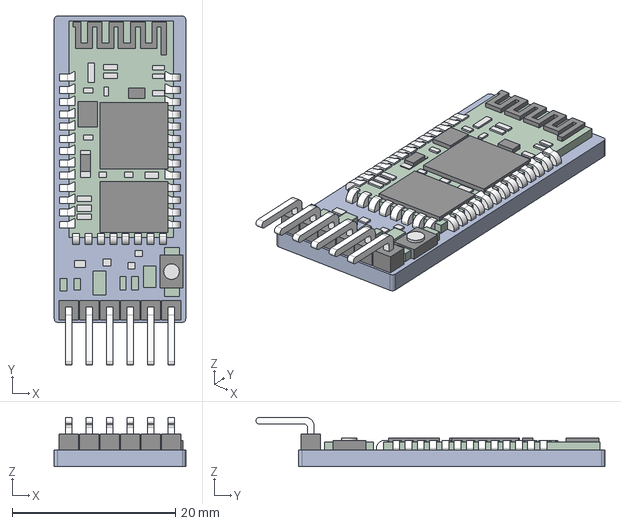
[picture p175: CAD file, 2020-08-29]
Mechanika/Mechanizm elewacji i elektronika Filip/CAD/CAD/HC_05 Blue Tooth Module.stp
16.1 x 42.7 x 6.00 mm
