f-labaj/Equatorial-Mount-MUM/Mechanika/Mechanizm elewacji i elektronika Filip/CAD/manfrotto-458b-tripod/Manfrotto 458B - Center Post Clamp.SLDPRT

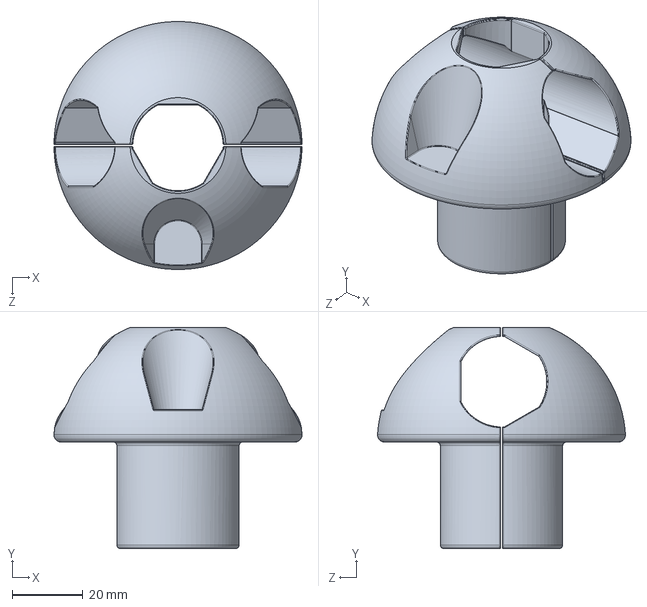
[picture p177: CAD file, 2020-08-21]
Mechanika/Mechanizm elewacji i elektronika Filip/CAD/manfrotto-458b-tripod/Manfrotto 458B - Center Post Clamp.SLDPRT
69.9 x 62.3 x 69.8 mm
