f-labaj/Equatorial-Mount-MUM/Mechanika/Moduł obrotu RET Estera/projejt/projejt/kololozyskowane/Gates_2GT_20T_Toothed.STEP

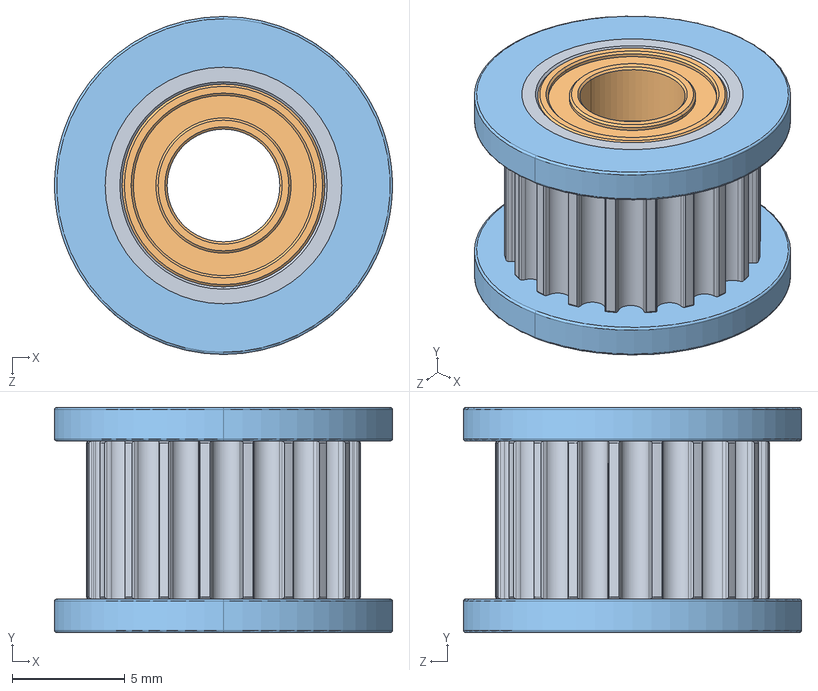
[picture p179: CAD file, 2020-08-21]
Mechanika/Moduł obrotu RET Estera/projejt/projejt/kololozyskowane/Gates_2GT_20T_Toothed.STEP
15.0 x 10.0 x 15.0 mm
Gates_2GT_20T_Toothed_01
MR95ZZ_Predeterminado x 2
Gates_2GT_20T_Toothed_02 x 2
