f-labaj/Equatorial-Mount-MUM/Mechanika/Moduł obrotu RET Estera/projejt/projejt/pololu-25d-mm-metal-gearmotor-bracket.step

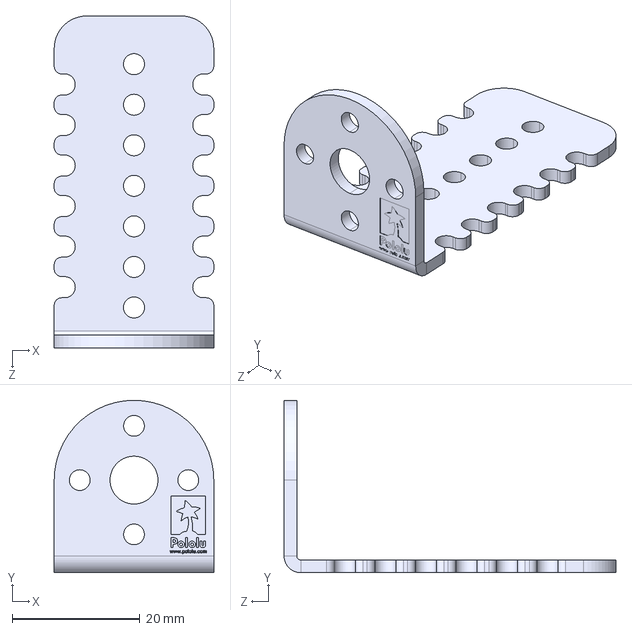
[picture p180: CAD file, 2020-08-21]
Mechanika/Moduł obrotu RET Estera/projejt/projejt/pololu-25d-mm-metal-gearmotor-bracket.step
25.0 x 27.0 x 52.0 mm
