f-labaj/Equatorial-Mount-MUM/Mechanika/Uchwyty, elementy i inne/microswitch-ss-3gl13sl-1.snapshot.2/Microswitch-SS-3GL13SL.STEP

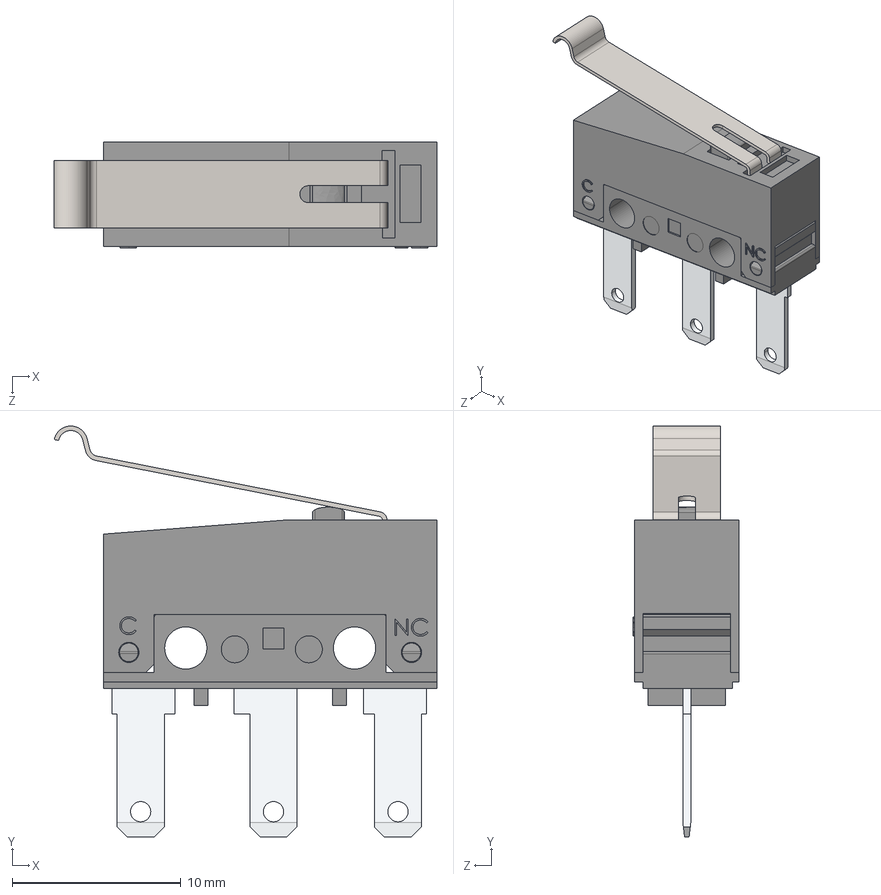
[picture p181: CAD file, 2020-08-29]
Mechanika/Uchwyty, elementy i inne/microswitch-ss-3gl13sl-1.snapshot.2/Microswitch-SS-3GL13SL.STEP
22.7 x 24.4 x 6.30 mm
limit-switch-bottomcase
limit-switch-top-case
pins
switch_lever
