f-labaj/Equatorial-Mount-MUM/Symulacje/stuff do symulacji/izolowany_wal.igs

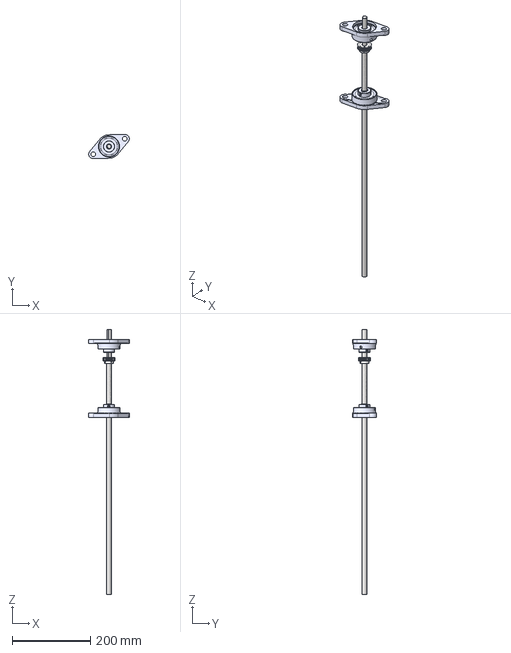
[picture p182: CAD file, 2020-09-04]
Symulacje/stuff do symulacji/izolowany_wal.igs
104.0 x 62.3 x 678.0 mm
