f-labaj/Equatorial-Mount-MUM/Mechanika/Mechanizm elewacji i elektronika Filip/CAD/manfrotto-458b-tripod/Manfrotto 458B - Leg Knuckle.SLDPRT

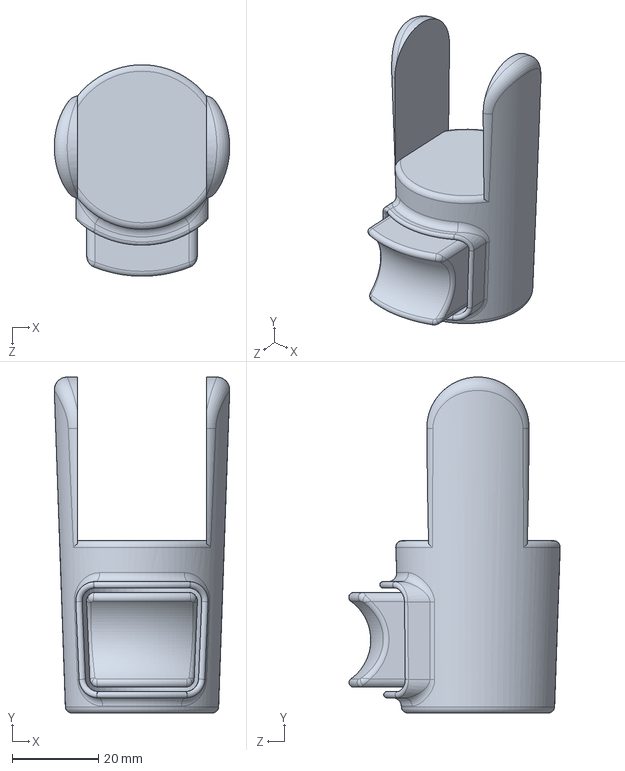
[picture p183: CAD file, 2020-08-21]
Mechanika/Mechanizm elewacji i elektronika Filip/CAD/manfrotto-458b-tripod/Manfrotto 458B - Leg Knuckle.SLDPRT
40.7 x 78.0 x 49.1 mm
