f-labaj/Equatorial-Mount-MUM/Mechanika/Moduł obrotu RET Estera/projejt/projejt/25d-metal-gearmotor-378-499-encoder.step

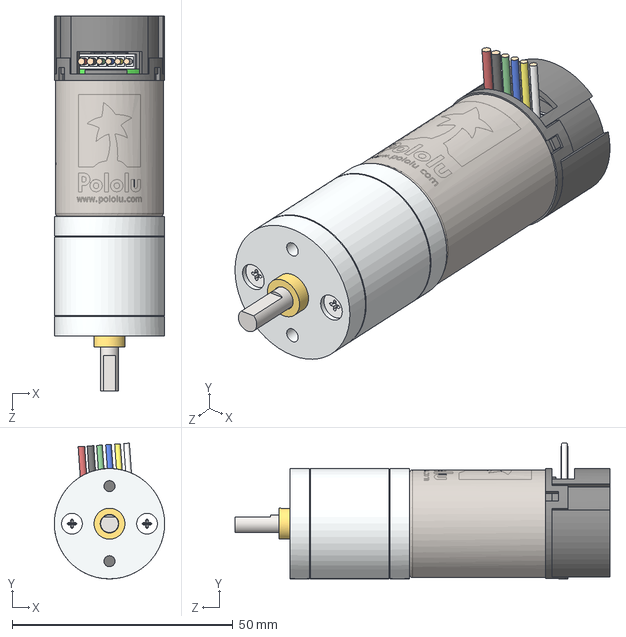
[picture p184: CAD file, 2020-08-21]
Mechanika/Moduł obrotu RET Estera/projejt/projejt/25d-metal-gearmotor-378-499-encoder.step
25.0 x 30.8 x 85.0 mm
