f-labaj/Equatorial-Mount-MUM/Mechanika/Moduł obrotu RET Estera/projejt/projejt/kololozyskowane/GT2 20T Pulley 5mm bore v3.step

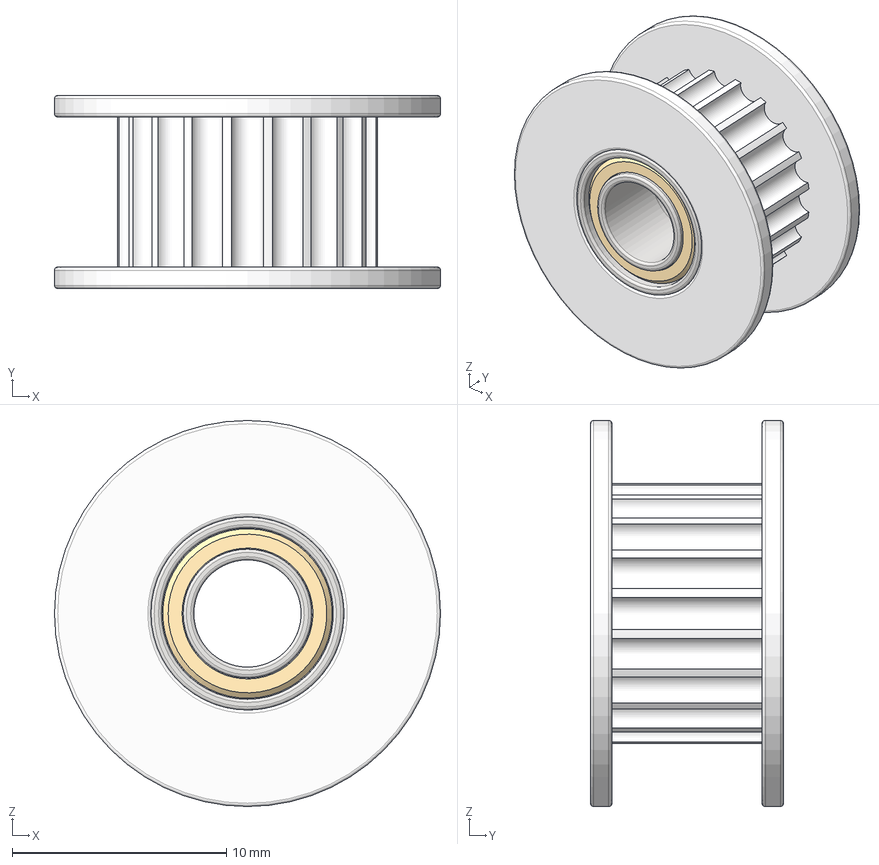
[picture p185: CAD file, 2020-08-21]
Mechanika/Moduł obrotu RET Estera/projejt/projejt/kololozyskowane/GT2 20T Pulley 5mm bore v3.step
18.0 x 9.00 x 18.0 mm
bearing
outer_plate
