f-labaj/Equatorial-Mount-MUM/Mechanika/Uchwyty, elementy i inne/microswitch-ss-3gl13sl-1.snapshot.2/limit-switch-top-case.SLDPRT

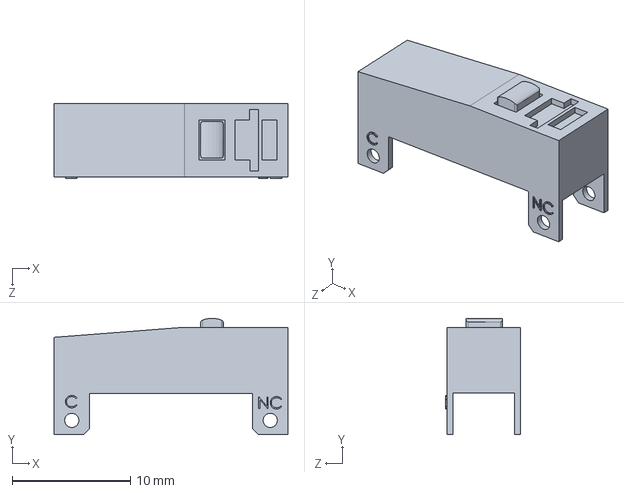
[picture p186: CAD file, 2020-08-29]
Mechanika/Uchwyty, elementy i inne/microswitch-ss-3gl13sl-1.snapshot.2/limit-switch-top-case.SLDPRT
19.8 x 9.81 x 6.30 mm
