f-labaj/Equatorial-Mount-MUM/Mechanika/Uchwyty, elementy i inne/microswitch-ss-3gl13sl-1.snapshot.2/switch_lever.SLDPRT

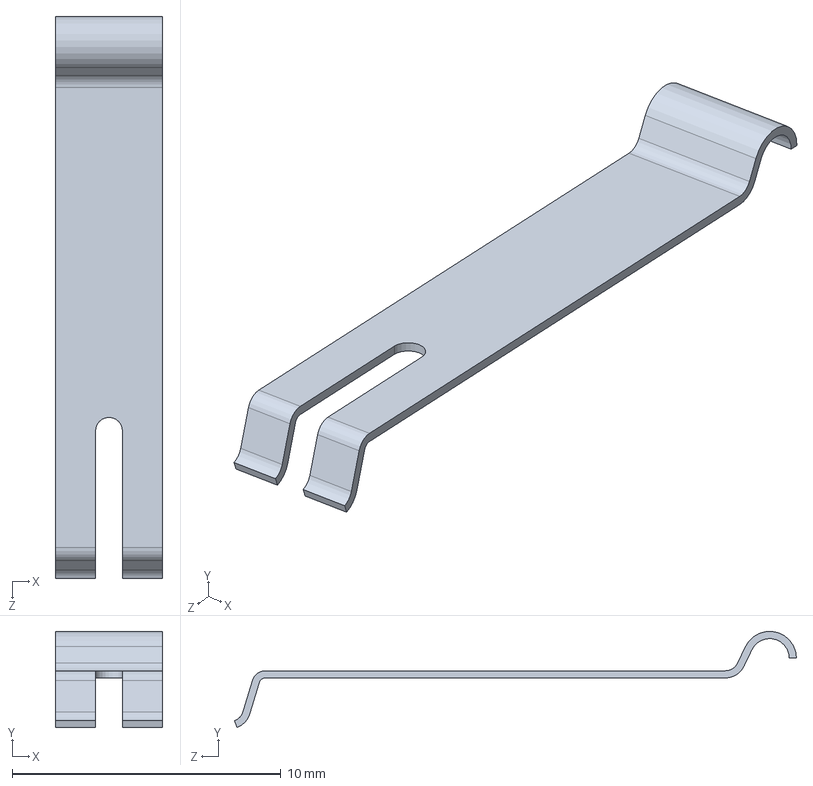
[picture p187: CAD file, 2020-08-29]
Mechanika/Uchwyty, elementy i inne/microswitch-ss-3gl13sl-1.snapshot.2/switch_lever.SLDPRT
4.00 x 3.58 x 20.9 mm
