f-labaj/Equatorial-Mount-MUM/Mechanika/Mechanizm elewacji i elektronika Filip/CAD/manfrotto-458b-tripod/Manfrotto 458B - Leg Spider.SLDPRT

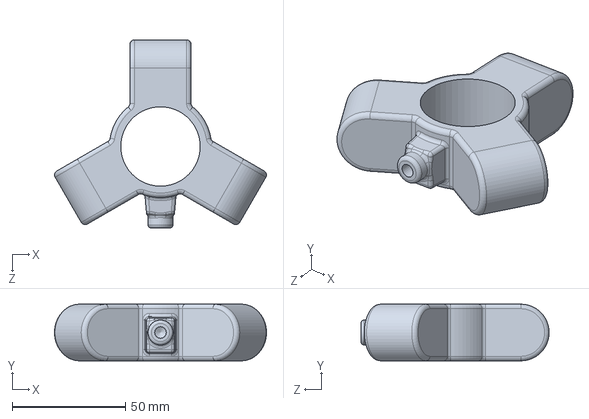
[picture p188: CAD file, 2020-08-21]
Mechanika/Mechanizm elewacji i elektronika Filip/CAD/manfrotto-458b-tripod/Manfrotto 458B - Leg Spider.SLDPRT
93.4 x 25.0 x 83.0 mm
