f-labaj/Equatorial-Mount-MUM/Mechanika/Moduł obrotu RET Estera/projejt/projejt/UCFL-201.STEP

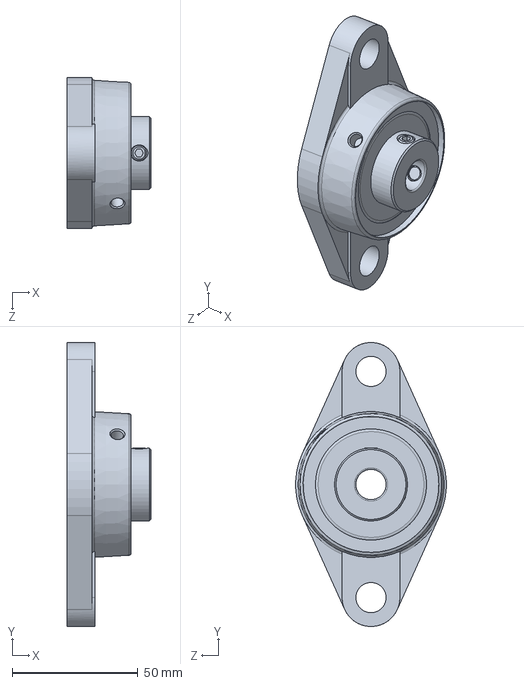
[picture p189: CAD file, 2020-08-21]
Mechanika/Moduł obrotu RET Estera/projejt/projejt/UCFL-201.STEP
33.3 x 113.0 x 59.9 mm
