f-labaj/Equatorial-Mount-MUM/Mechanika/Uchwyty, elementy i inne/microswitch-ss-3gl13sl-1.snapshot.2/pins.SLDPRT

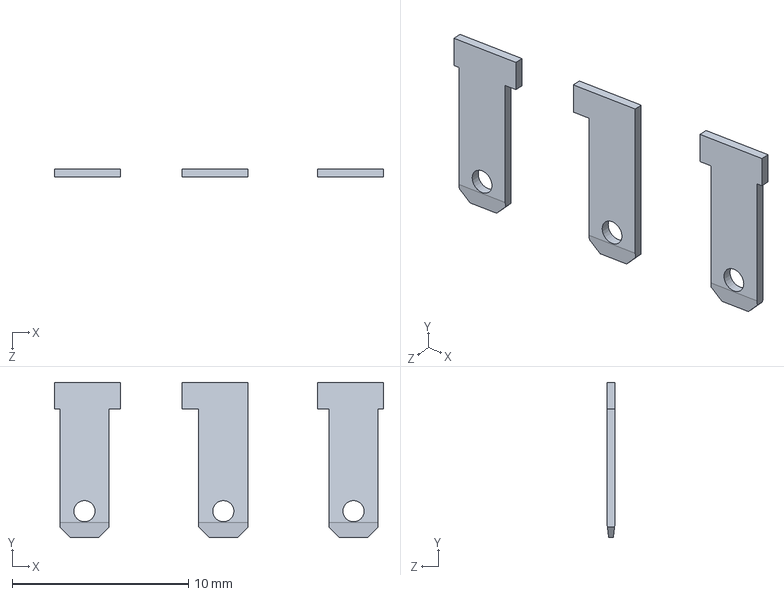
[picture p190: CAD file, 2020-08-29]
Mechanika/Uchwyty, elementy i inne/microswitch-ss-3gl13sl-1.snapshot.2/pins.SLDPRT
18.6 x 8.80 x 0.47 mm
