f-labaj/Equatorial-Mount-MUM/Mechanika/Moduł obrotu RET Estera/projejt/projejt/Gates_2GT_20T_Smooth_Idler.STEP

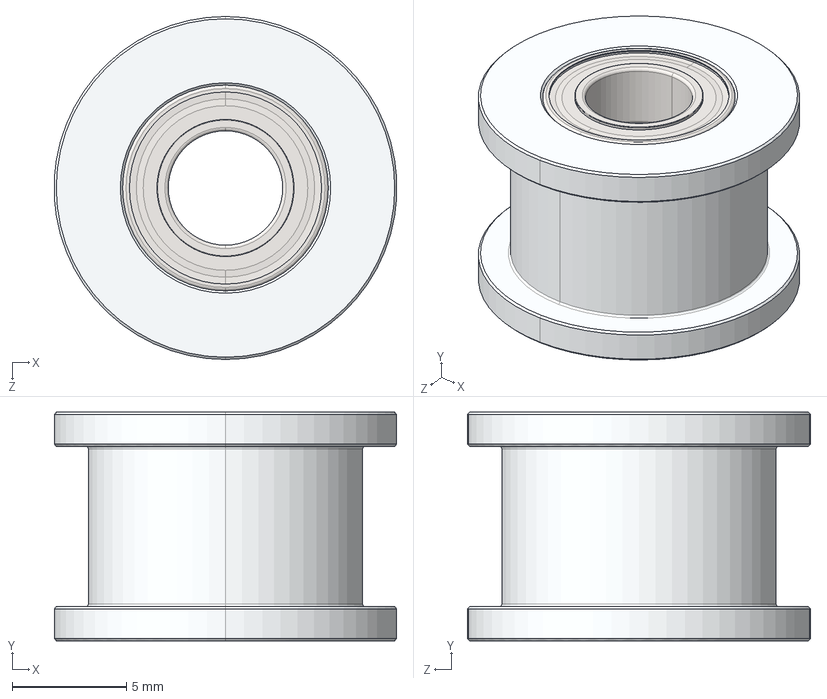
[picture p191: CAD file, 2020-08-21]
Mechanika/Moduł obrotu RET Estera/projejt/projejt/Gates_2GT_20T_Smooth_Idler.STEP
15.0 x 10.0 x 15.0 mm
