f-labaj/Equatorial-Mount-MUM/(list of files, cad)

Other CAD files:
Mechanika/Mechanizm elewacji i elektronika Filip/Rysunki/MPT_main_assembly.dwg
Mechanika/Moduł obrotu RET Estera/prawieKoncowka/Moduł deklinacji.dwg
Mechanika/Moduł obrotu RET Estera/prawieKoncowka/Templates/en-US/English/ANSI (in).dwg
Mechanika/Moduł obrotu RET Estera/prawieKoncowka/Templates/English/ANSI (in).dwg
Stare pliki itd/Zapasowe rysunki/Teleskop.dwg
Symulacje/Templates/Angielskie/am_ansi.dwg
Symulacje/Templates/Metryczne/am_jis.dwg
Symulacje/Templates/pl-PL/Angielskie/ANSI (cal).dwg
Symulacje/Templates/pl-PL/Metryczne/am_din.dwg
Symulacje/Templates/pl-PL/Standard.dwg
Symulacje/Templates/Standard.dwg
Mechanika/Mechanizm elewacji i elektronika Filip/Rysunki/MPT-03-11-01_blaszka_mocujaca.dwg
Mechanika/Moduł obrotu RET Estera/prawieKoncowka/Moduł rektascencji.dwg
Stare pliki itd/Zapasowe rysunki/tuba2.dwg
Symulacje/Templates/Angielskie/ANSI (cal).dwg
Symulacje/Templates/Metryczne/am_gb.dwg
Symulacje/Templates/pl-PL/Angielskie/am_ansi.dwg
Symulacje/Templates/pl-PL/Metryczne/am_iso.dwg
Mechanika/Mechanizm elewacji i elektronika Filip/CAD/CAD/small-power-switches-rocker-type-10-5x15mm-1.snapshot.4/KCD1-11-3P-On.step
Mechanika/Mechanizm elewacji i elektronika Filip/Rysunki/MPT-03-01_obudowa_modulu_elewacji.dwg
Mechanika/Moduł obrotu RET Estera/prawieKoncowka/GlownaObudowa2.dwg
Symulacje/Templates/Metryczne/BSI.dwg
Symulacje/Templates/pl-PL/Metryczne/ISO.dwg
Mechanika/Mechanizm elewacji i elektronika Filip/CAD/CAD/small-power-switches-rocker-type-10-5x15mm-1.snapshot.4/KCD1-11-2P-Off.step
Mechanika/Mechanizm elewacji i elektronika Filip/Rysunki/MPT-03-02_ślimak.dwg
Mechanika/Moduł obrotu RET Estera/prawieKoncowka/uchwytDoNapinacza.dwg
Mechanika/Moduł obrotu RET Estera/projejt/projejt/GT2_20T.STEP
Symulacje/Templates/Metryczne/am_din.dwg
Symulacje/Templates/pl-PL/Metryczne/am_bsi.dwg
Mechanika/Mechanizm elewacji i elektronika Filip/Rysunki/MPT-03-24_pokrywa_przednia.dwg
Mechanika/Moduł obrotu RET Estera/prawieKoncowka/GlownaObudowa.dwg
Symulacje/Templates/Metryczne/DIN.dwg
Symulacje/Templates/pl-PL/Metryczne/am_gb.dwg
Mechanika/Mechanizm elewacji i elektronika Filip/Rysunki/MPT-03-10-01_obudowa_elektroniki.dwg
Mechanika/Moduł obrotu RET Estera/prawieKoncowka/ZaslepkaObudowa.dwg
Symulacje/Templates/Metryczne/am_iso.dwg
Symulacje/Templates/pl-PL/Metryczne/GB.dwg
Mechanika/Mechanizm elewacji i elektronika Filip/Rysunki/MPT-03-14_pokrywa_górna_krótka.dwg
Symulacje/Templates/Metryczne/am_bsi.dwg
Symulacje/Templates/pl-PL/Metryczne/GOST.dwg
Mechanika/Mechanizm elewacji i elektronika Filip/Rysunki/MPT-03-03_ślimacznica.dwg
Symulacje/Templates/Metryczne/JIS.dwg
Symulacje/Templates/pl-PL/Metryczne/DIN.dwg
Mechanika/Mechanizm elewacji i elektronika Filip/Rysunki/MPT-03-08_rączka_korby.dwg
Symulacje/Templates/Metryczne/GOST.dwg
Symulacje/Templates/pl-PL/Metryczne/am_jis.dwg
Mechanika/Mechanizm elewacji i elektronika Filip/Rysunki/MPT-03_moduł_elewacji.dwg
Symulacje/Templates/Metryczne/ISO.dwg
Symulacje/Templates/pl-PL/Metryczne/JIS.dwg
Mechanika/Mechanizm elewacji i elektronika Filip/Rysunki/MPT-03-12_szczęka_hamulca_krótka.dwg
Symulacje/Templates/Metryczne/GB.dwg
Symulacje/Templates/pl-PL/Metryczne/BSI.dwg
Mechanika/Mechanizm elewacji i elektronika Filip/Rysunki/MPT-03-07_wał_półkola.dwg
Symulacje/Templates/Metryczne/ANSI (mm).dwg
Symulacje/Templates/pl-PL/Metryczne/ANSI (mm).dwg
Mechanika/Mechanizm elewacji i elektronika Filip/Rysunki/MPT-03-23_pokrywa_tylna.dwg
Mechanika/Mechanizm elewacji i elektronika Filip/Rysunki/MPT-03-06_koło_zębate.dwg
Mechanika/Mechanizm elewacji i elektronika Filip/Rysunki/MPT-03-15_pokrywa_górna_długa.dwg
Mechanika/Mechanizm elewacji i elektronika Filip/Rysunki/MPT-03-17_pokrywa_elektroniki.dwg
Mechanika/Mechanizm elewacji i elektronika Filip/Rysunki/MPT-03-10_moduł_elektroniki.dwg
Mechanika/Mechanizm elewacji i elektronika Filip/Rysunki/MPT-03-11-02_obudowa_elektroniki_zewnętrznej.dwg
Mechanika/Mechanizm elewacji i elektronika Filip/Rysunki/MPT-03-11_elektronika_zewnetrzna_zlozenie.dwg
Mechanika/Mechanizm elewacji i elektronika Filip/Rysunki/MPT-03-04_walek_posredni.dwg
Mechanika/Mechanizm elewacji i elektronika Filip/Rysunki/MPT-03-19_wał_prowadzący_dlugi_hamulca.dwg
Mechanika/Mechanizm elewacji i elektronika Filip/Rysunki/MPT-03-20_wał_prowadzący_krótki_hamulca.dwg
Mechanika/Mechanizm elewacji i elektronika Filip/Rysunki/MPT-03-09_ramię_korby.dwg
Mechanika/Mechanizm elewacji i elektronika Filip/Rysunki/MPT-03-05_zębnik.dwg
Mechanika/Mechanizm elewacji i elektronika Filip/Rysunki/MPT-03-13_szczęka_hamulca_długa.dwg
Mechanika/Mechanizm elewacji i elektronika Filip/Rysunki/obudowa_elektroniki_zewnętrznej.dwg
Mechanika/Mechanizm elewacji i elektronika Filip/Rysunki/elektronika_zewnetrzna_zlozenie.dwg
Mechanika/Mechanizm elewacji i elektronika Filip/Rysunki/blaszka_mocujaca.dwg
Mechanika/Mechanizm elewacji i elektronika Filip/Rysunki/1.dwg
Mechanika/Mechanizm elewacji i elektronika Filip/Rysunki/pokrywa_przednia.dwg
Mechanika/Mechanizm elewacji i elektronika Filip/Rysunki/2.dwg
Mechanika/Main_Assembly/OldVersions/zlozenieTymRazemOdwrotniezUchwytem.0006.iam
Mechanika/Main_Assembly/main_assembly.iam
Mechanika/Main_Assembly/zlozenieTymRazemOdwrotniezUchwytem.iam
Mechanika/Mechanizm elewacji i elektronika Filip/CAD/Arduino Leonardo.ipt
Mechanika/Mechanizm elewacji i elektronika Filip/CAD/Battery 18650.ipt
Mechanika/Mechanizm elewacji i elektronika Filip/CAD/CAD/Arduino Leonardo.ipt
Mechanika/Mechanizm elewacji i elektronika Filip/CAD/CAD/Battery 18650.ipt
Mechanika/Mechanizm elewacji i elektronika Filip/CAD/CAD/DIN 912 - M3 x 0.5 x 10 x 8.75.ipt
Mechanika/Mechanizm elewacji i elektronika Filip/CAD/CAD/DIN 912 - M3 x 0.5 x 6 x 4.75.ipt
Mechanika/Mechanizm elewacji i elektronika Filip/CAD/CAD/DIN 934 - M3 x 0.5.ipt
Mechanika/Mechanizm elewacji i elektronika Filip/CAD/CAD/HC_05 Blue Tooth Module.ipt
Mechanika/Mechanizm elewacji i elektronika Filip/CAD/CAD/Konwerter step-down - D24V150FX.ipt
Mechanika/Mechanizm elewacji i elektronika Filip/CAD/CAD/Moduł GPS/EM406 GPS Module.IGS
Mechanika/Mechanizm elewacji i elektronika Filip/CAD/CAD/Moduł GPS/EM406 GPS Module.ipt
Mechanika/Mechanizm elewacji i elektronika Filip/CAD/CAD/OldVersions/obudowa.0033.ipt
Mechanika/Mechanizm elewacji i elektronika Filip/CAD/CAD/OldVersions/obudowa_elektroniki.0018.iam
Mechanika/Mechanizm elewacji i elektronika Filip/CAD/CAD/OldVersions/obudowa_elektroniki_proper.0023.iam
Mechanika/Mechanizm elewacji i elektronika Filip/CAD/CAD/Standoff_M3_14mm.ipt
Mechanika/Mechanizm elewacji i elektronika Filip/CAD/CAD/Sterownik silnika - Dual TB9051FTG.ipt
Mechanika/Mechanizm elewacji i elektronika Filip/CAD/CAD/Sterownik silnika/dual-tb9051ftg-motor-driver-shield.ipt
Mechanika/Mechanizm elewacji i elektronika Filip/CAD/CAD/arduino-uno-r3-1.snapshot.3/10 PORT HEADER.ipt
Mechanika/Mechanizm elewacji i elektronika Filip/CAD/CAD/arduino-uno-r3-1.snapshot.3/102 RESISTOR PACK.ipt
Mechanika/Mechanizm elewacji i elektronika Filip/CAD/CAD/arduino-uno-r3-1.snapshot.3/103 RESISTOR PACK.ipt
Mechanika/Mechanizm elewacji i elektronika Filip/CAD/CAD/arduino-uno-r3-1.snapshot.3/16mhz crystal - measured.ipt
Mechanika/Mechanizm elewacji i elektronika Filip/CAD/CAD/arduino-uno-r3-1.snapshot.3/220 RESISTOR PACK.ipt
Mechanika/Mechanizm elewacji i elektronika Filip/CAD/CAD/arduino-uno-r3-1.snapshot.3/2pin_header__02.ipt
Mechanika/Mechanizm elewacji i elektronika Filip/CAD/CAD/arduino-uno-r3-1.snapshot.3/47uf CAP Dcase.ipt
Mechanika/Mechanizm elewacji i elektronika Filip/CAD/CAD/arduino-uno-r3-1.snapshot.3/6 PORT HEADER.ipt
Mechanika/Mechanizm elewacji i elektronika Filip/CAD/CAD/arduino-uno-r3-1.snapshot.3/603 cap on pad.ipt
Mechanika/Mechanizm elewacji i elektronika Filip/CAD/CAD/arduino-uno-r3-1.snapshot.3/603 resistor.ipt
Mechanika/Mechanizm elewacji i elektronika Filip/CAD/CAD/arduino-uno-r3-1.snapshot.3/8 PORT HEADER.ipt
Mechanika/Mechanizm elewacji i elektronika Filip/CAD/CAD/arduino-uno-r3-1.snapshot.3/ATMEL328P.ipt
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
