f-labaj/Equatorial-Mount-MUM/Rendery/main_assembly_1.png

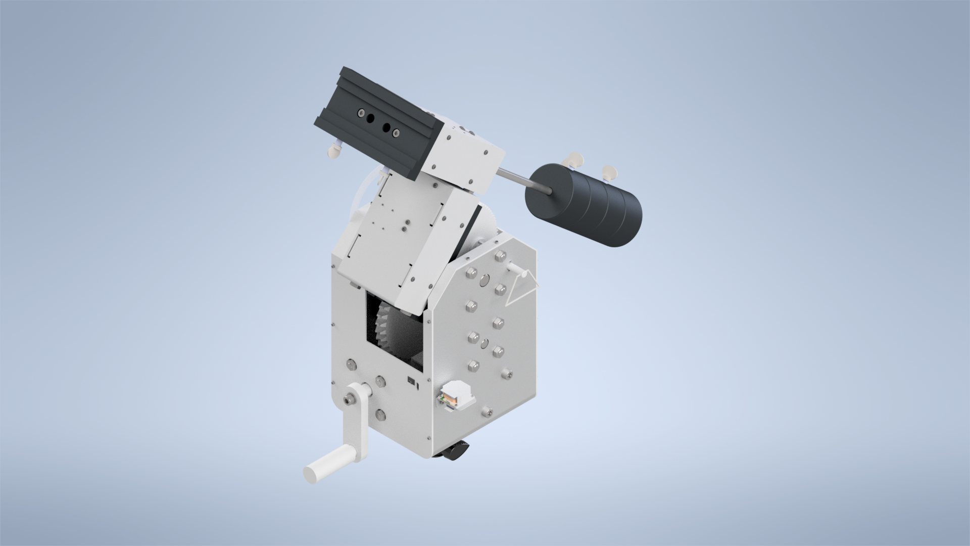
Rendery/main_assembly_1.png
