f-labaj/Equatorial-Mount-MUM/Rendery/main_assembly_2_final.png

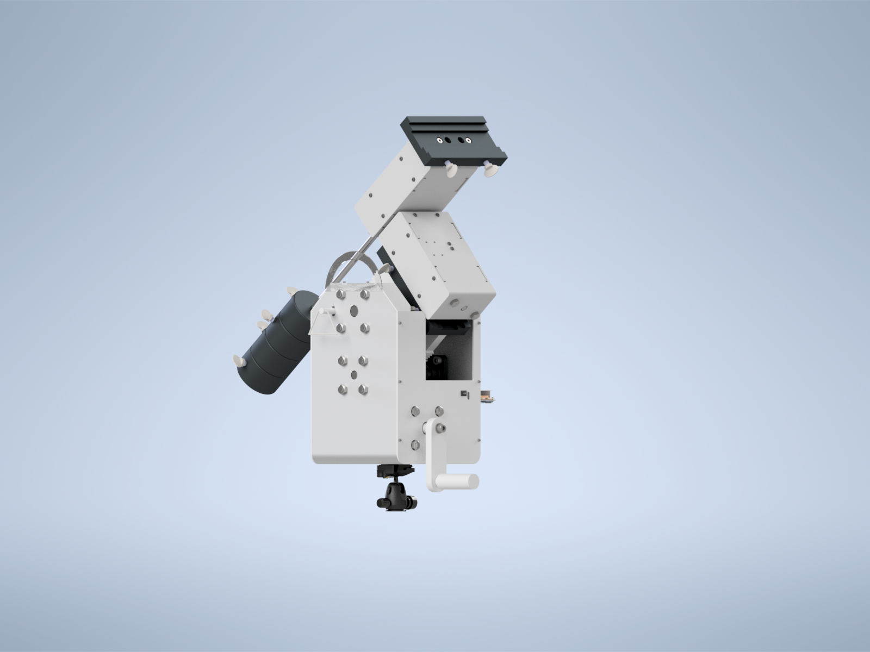
Rendery/main_assembly_2_final.png
