f-labaj/Equatorial-Mount-MUM/Rendery/main_assembly_final_2.png

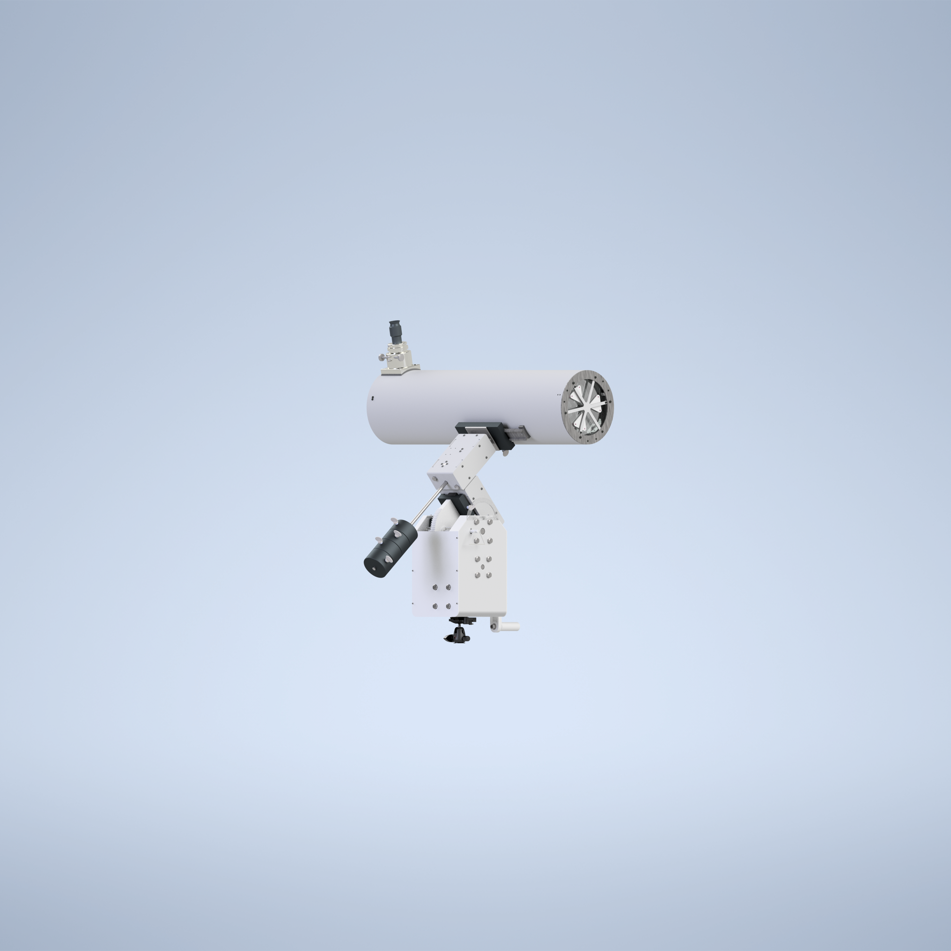
Rendery/main_assembly_final_2.png
