f-labaj/Equatorial-Mount-MUM/Rendery/main_assembly_final_render.png

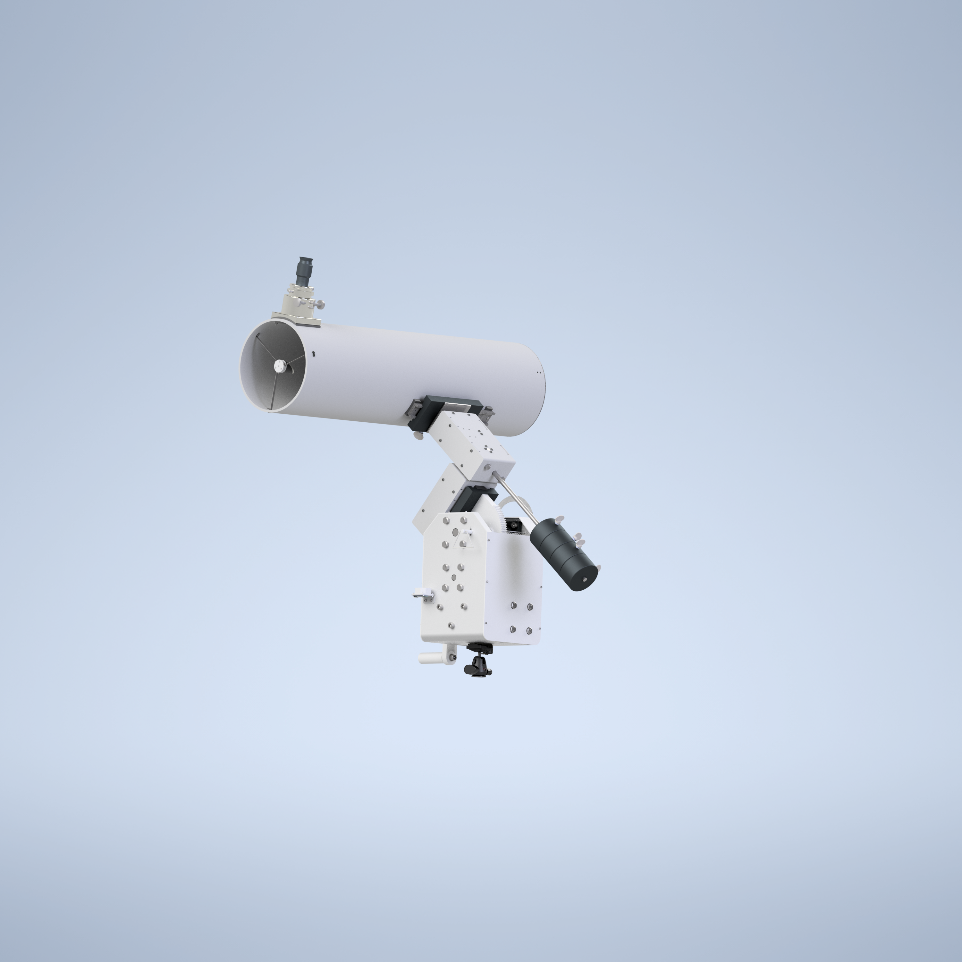
Rendery/main_assembly_final_render.png
