f-labaj/Equatorial-Mount-MUM/Rendery/main_assembly_no_tele.png

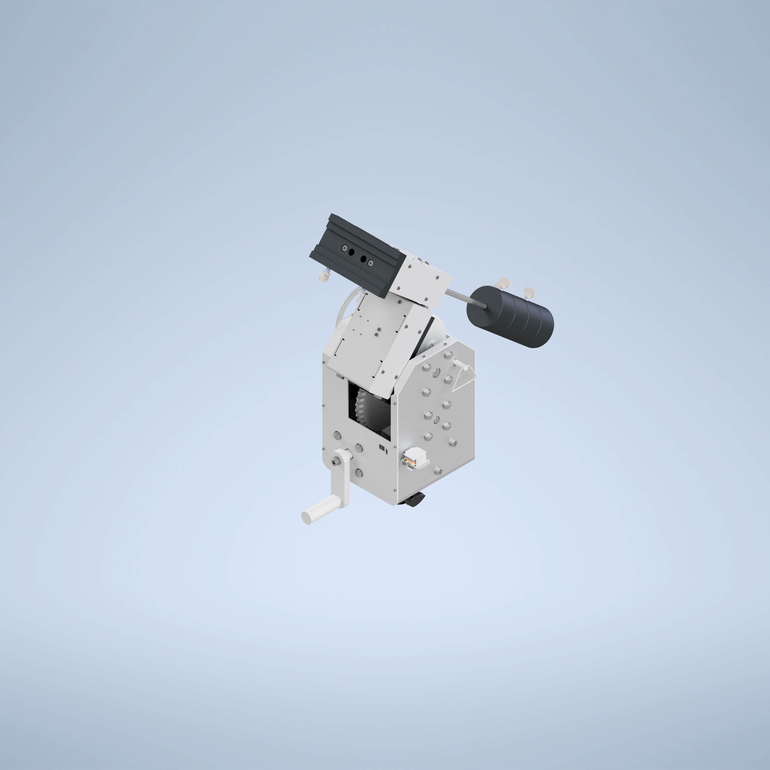
Rendery/main_assembly_no_tele.png
