f-labaj/Equatorial-Mount-MUM/Mechanika/Mechanizm elewacji i elektronika Filip/Rysunki/PDF/MPT-03-01_obudowa_modulu_elewacji.pdf

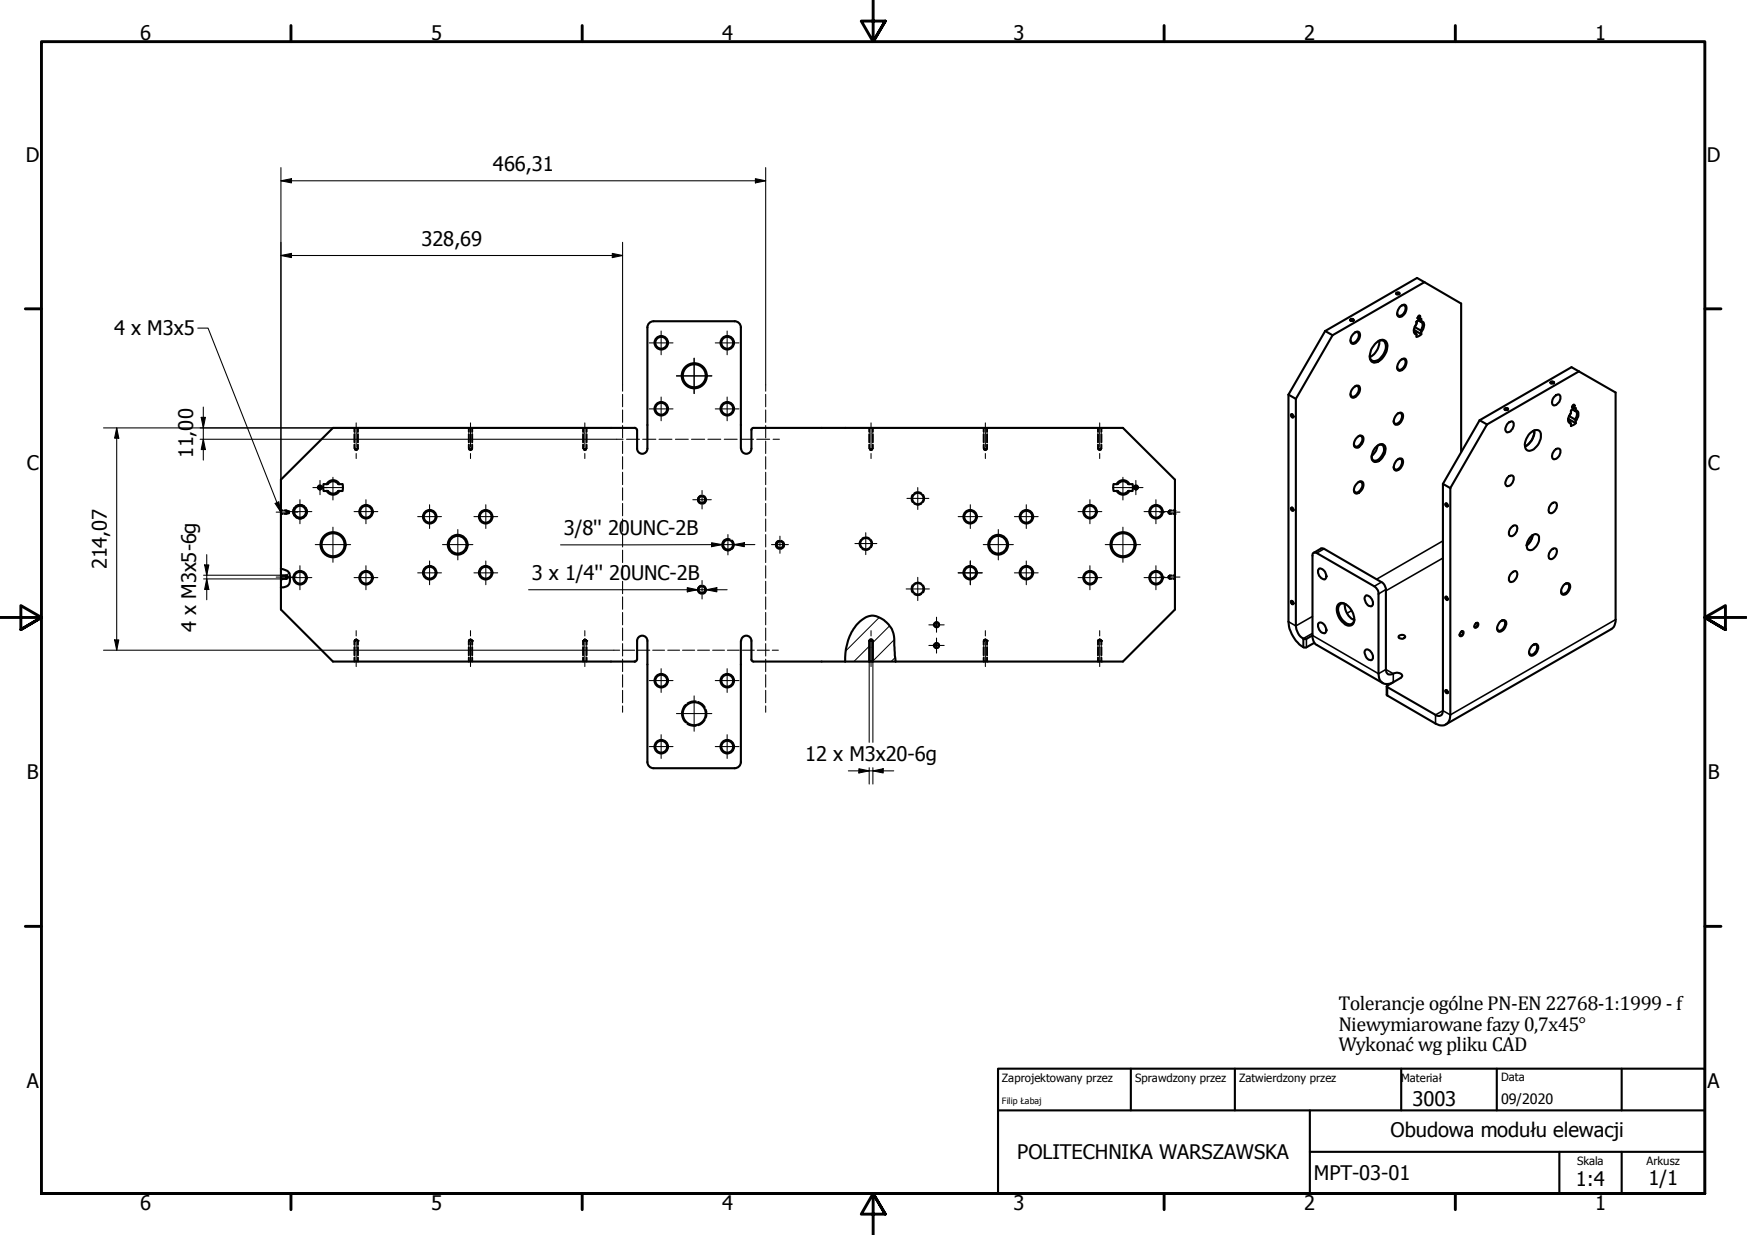
[picture p202: page 1]
3/8'' 20UNC-2B; 3 x 1/4'' 20UNC-2B

Tolerancje og×lne PN-EN 22768-1:1999 - f
Niewymiarowane fazy 0,7x45
Wykona© wg pliku CAD

Zaprojektowany przez Filip àabaj | Sprawdzony przez | Zatwierdzony przez | Materiaá 3003 | Data 09/2020

POLITECHNIKA WARSZAWSKA | Obudowa moduáu elewacji

MPT-03-01 | Skala 1:4 | Arkusz 1/1
