f-labaj/Equatorial-Mount-MUM/Mechanika/Mechanizm elewacji i elektronika Filip/Rysunki/PDF/MPT-03-11-01_blaszka_mocujaca.pdf

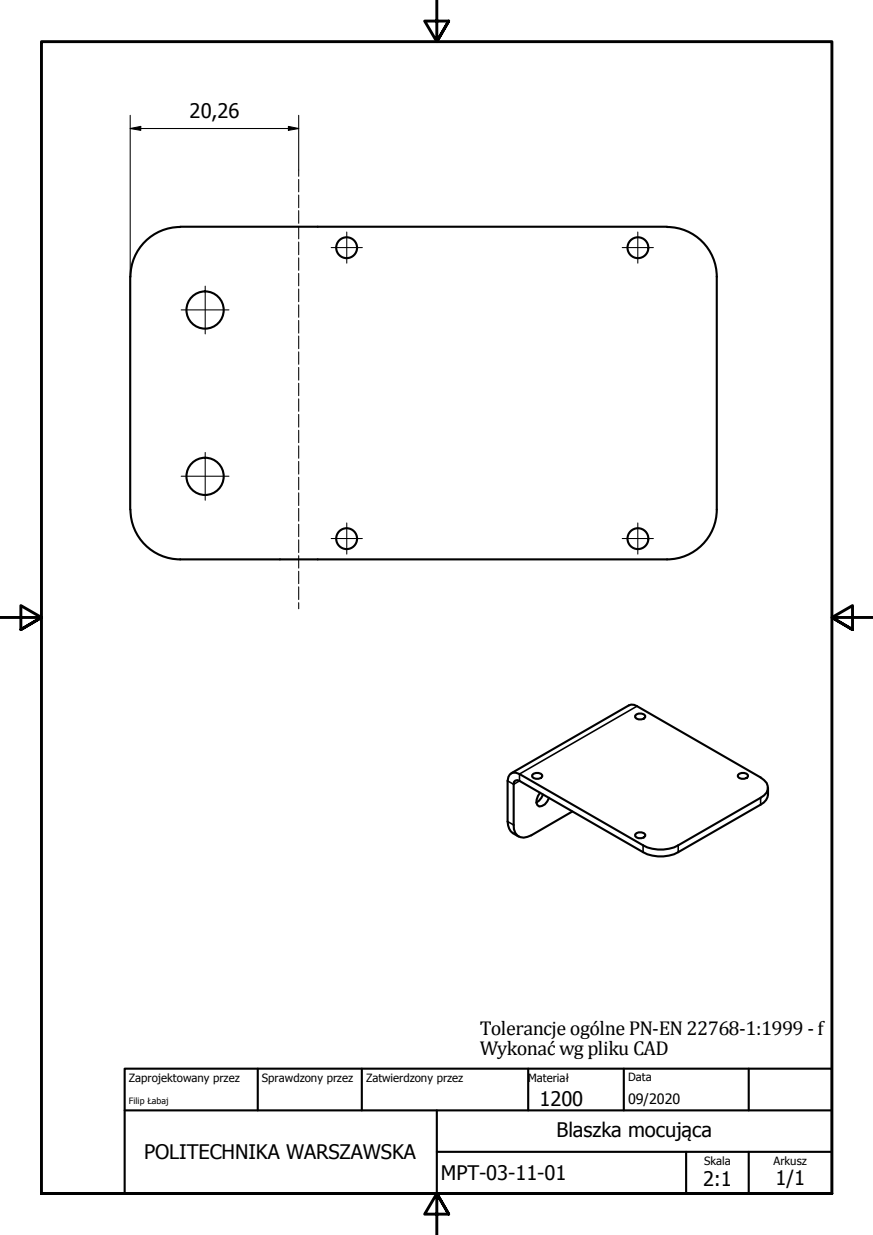
[picture p203: page 1]

Tolerancje og×lne PN-EN 22768-1:1999 - f
Wykona© wg pliku CAD

Zaprojektowany przez Filip àabaj | Sprawdzony przez | Zatwierdzony przez | Materiaá 1200 | Data 09/2020

POLITECHNIKA WARSZAWSKA | Blaszka mocujca

MPT-03-11-01 | Skala 2:1 | Arkusz 1/1
