f-labaj/Equatorial-Mount-MUM/Mechanika/Moduł obrotu RET Estera/prawieKoncowka/Dokumentacja_pdf/MPT-01-01_GlownaObudowa2.pdf

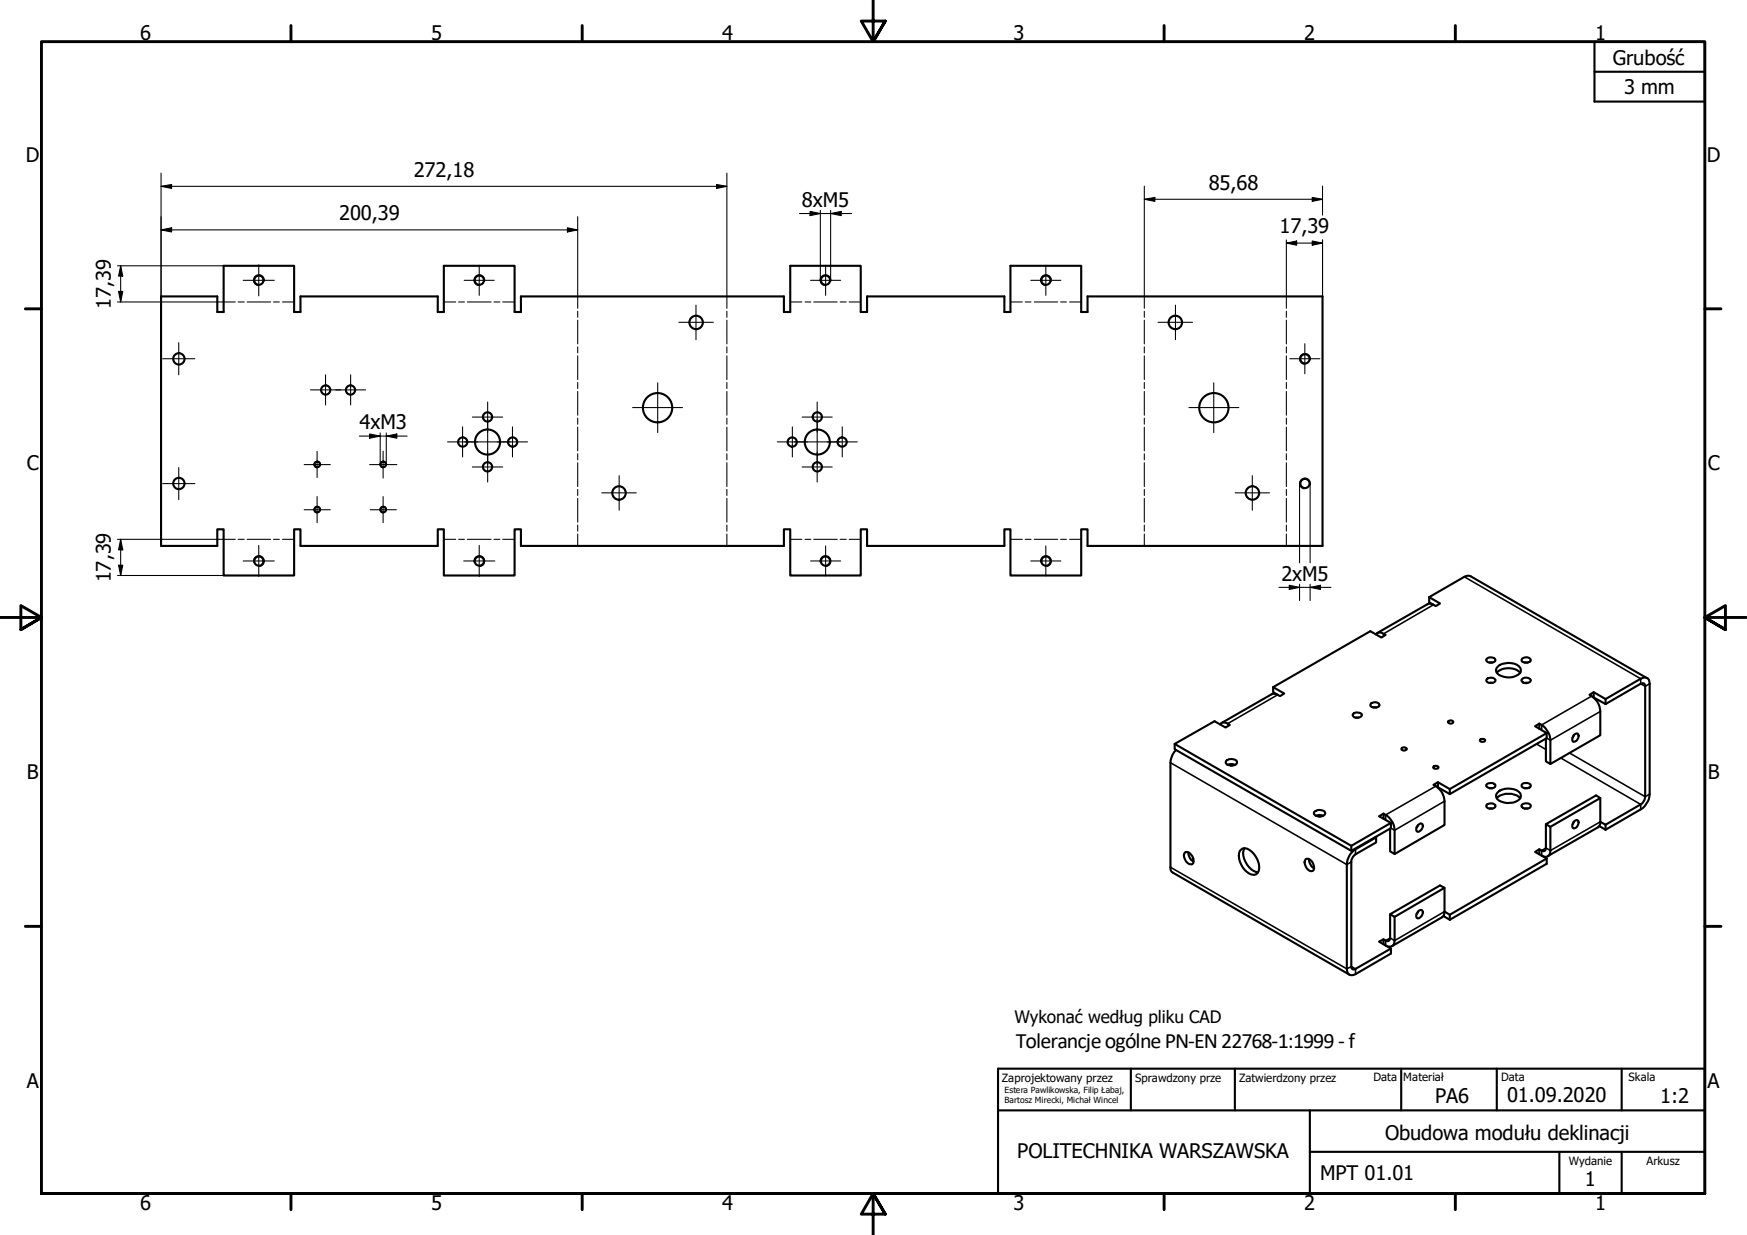
[picture p204: page 1]

Wykonaü wedáug pliku CAD
Tolerancje oglne PN-EN22768-1:1999 - f

Zaprojektowany przez Estera Pawlikowska, Filip àabaj, Bartosz Mirecki, Michaá Wincel | Sprawdzony prze | Zatwierdzony przez Data | Materiaá PA6 | Data 01.09.2020 | Skala 1:2

POLITECHNIKA WARSZAWSKA | Obudowa moduáu deklinacji

MPT 01.01 | Wydanie 1 | Arkusz
