f-labaj/Equatorial-Mount-MUM/Mechanika/Moduł obrotu RET Estera/prawieKoncowka/Dokumentacja_pdf/MPT-01-02_ZaslepkaObudowa.pdf

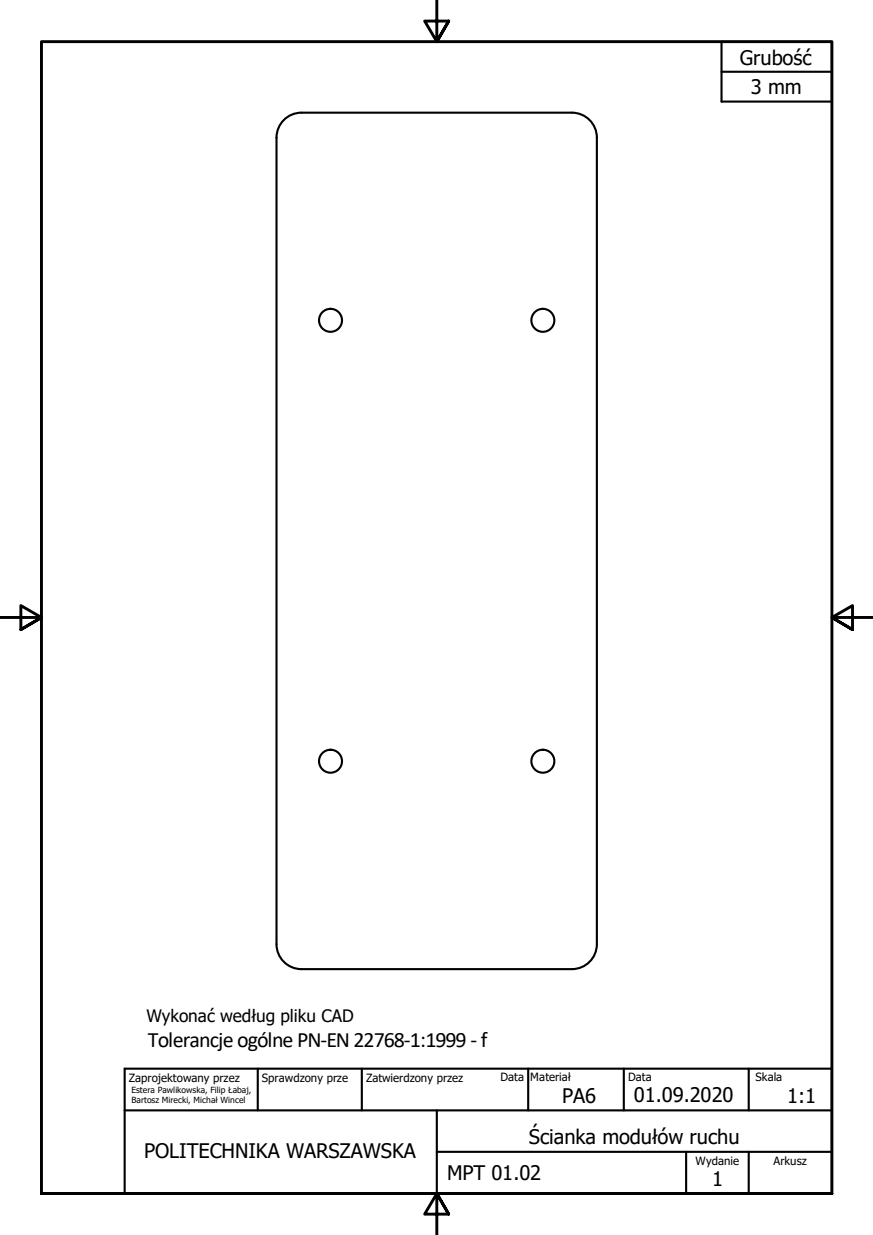
[picture p205: page 1]

Wykonaü wedáug pliku CAD
Tolerancje oglne PN-EN22768-1:1999 - f

Zaprojektowany przez Estera Pawlikowska, Filip àabaj, Bartosz Mirecki, Michaá Wincel | Sprawdzony prze | Zatwierdzony przez Data | Materiaá PA6 | Data 01.09.2020 | Skala 1:1

POLITECHNIKA WARSZAWSKA | cianka moduáyw ruchu

MPT 01.02 | Wydanie 1 | Arkusz
