f-labaj/Equatorial-Mount-MUM/Mechanika/Moduł obrotu RET Estera/prawieKoncowka/Dokumentacja_pdf/MPT-01-04_ModulSilnika.pdf

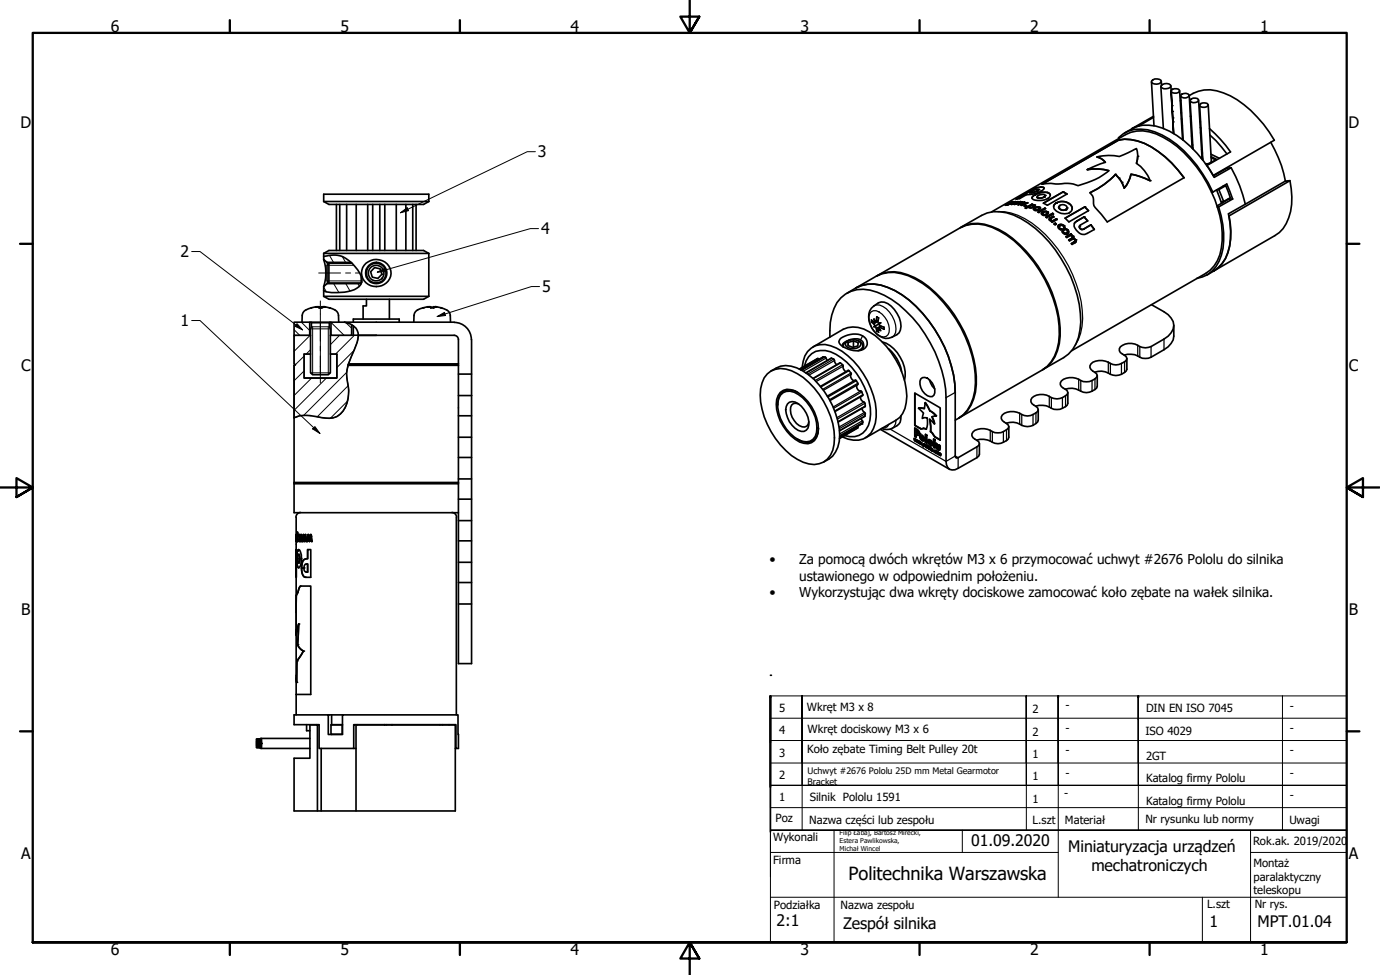
[picture p206: page 1]

• Za pomoc dwych wkrtyw M3 x 6 przymocowaü uchwyt #2676 Pololu do silnika
ustawionego w odpowiednim poáoeniu.
• Wykorzystujc dwa wkrty dociskowe zamocowaü koáo zbate na waáek silnika.

5 | Wkrt M3 x 8 | 2 | - | DIN EN ISO 7045 | -

4 | Wkrt dociskowy M3 x 6 | 2 | - | ISO 4029 | -

3 | Koáo zbate Timing Belt Pulley 20t | 1 | - | 2GT | -

2 | Uchwyt #2676 Pololu 25D mm Metal Gearmotor Bracket | 1 | - | Katalog firmy Pololu | -

1 | Silnik Pololu 1591 | 1 | - | Katalog firmy Pololu | -

Poz | Nazwa czci lub zespoáu | L.szt | Materiaá | Nr rysunku lub normy | Uwagi
Wykonali | Filip àabaj, Bartosz Mirecki, Estera Pawlikowska, Michaá Wincel | 01.09.2020 | Miniaturyzacja urzdze mechatroniczych | Rok.ak. 2019/2020
Firma | Politechnika Warszawska | | | Monta paralaktyczny teleskopu

Podziaáka 2:1 | Nazwa zespoáu Zespyá silnika | L.szt 1 | Nr rys. MPT.01.04
