f-labaj/Equatorial-Mount-MUM/Symulacje/stuff do symulacji/main_assembly.pdf

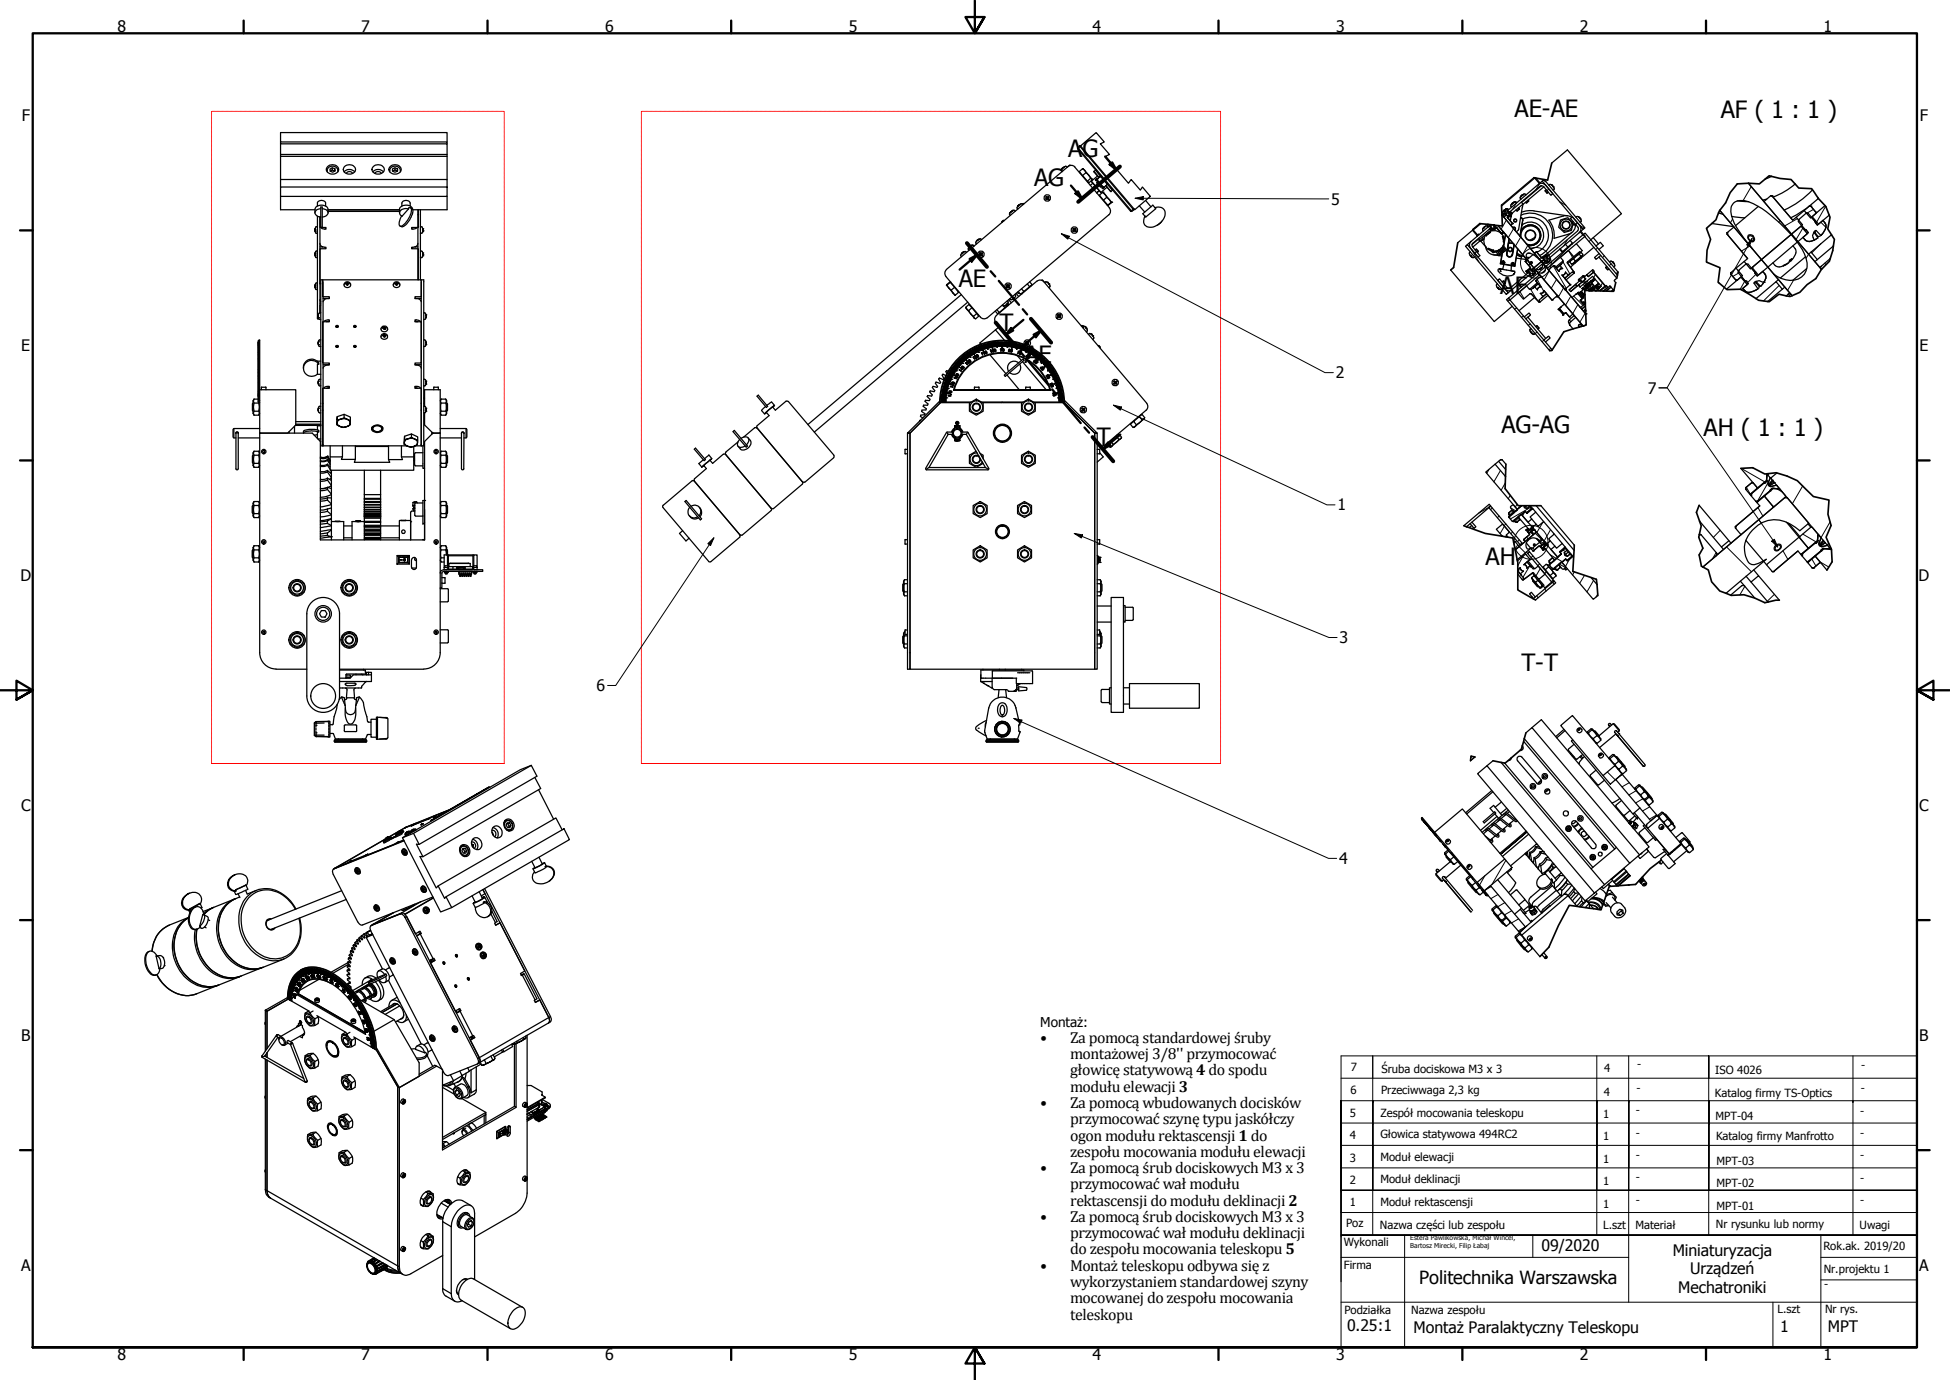
[picture p207: page 1]
Zespyá mocowania teleskopu; Gáowica statywowa 494RC2; Moduá rektascensji; Moduá elewacji; Moduá deklinacji; Rok.ak. 2019/20; Nr.projektu 1; L.szt; Nr rys.; - MPT-01; Katalog firmy TS-Optics 6; Przeciwwaga 2,3 kg; ISO 4026

Monta:
montaowej 3/8'' przymocowa©
gÏowic¸ statywow¦ 4 do spodu
moduÏu elewacji 3
przymocowa© szyn¸ typu jask×Ïczy
ogon moduÏu rektascensji 1 do
zespoÏu mocowania moduÏu elewacji
przymocowa© waÏ moduÏu
rektascensji do moduÏu deklinacji 2
przymocowa© waÏ moduÏu deklinacji
do zespoÏu mocowania teleskopu 5
wykorzystaniem standardowej szyny
mocowanej do zespoÏu mocowania

MPT-04
Katalog firmy Manfrotto

Nazwa czci lub zespoáu

Nr rysunku lub normy
Miniaturyzacja
Urzdze
Mechatroniki

Estera Pawlikowska, Michaá Wincel,
Bartosz Mirecki, Filip àabaj
Politechnika Warszawska

Nazwa zespoáu
Monta Paralaktyczny Teleskopu
