f-labaj/Equatorial-Mount-MUM/Mechanika/Mechanizm elewacji i elektronika Filip/Rysunki/PDF/MPT-03-02_ślimak.pdf

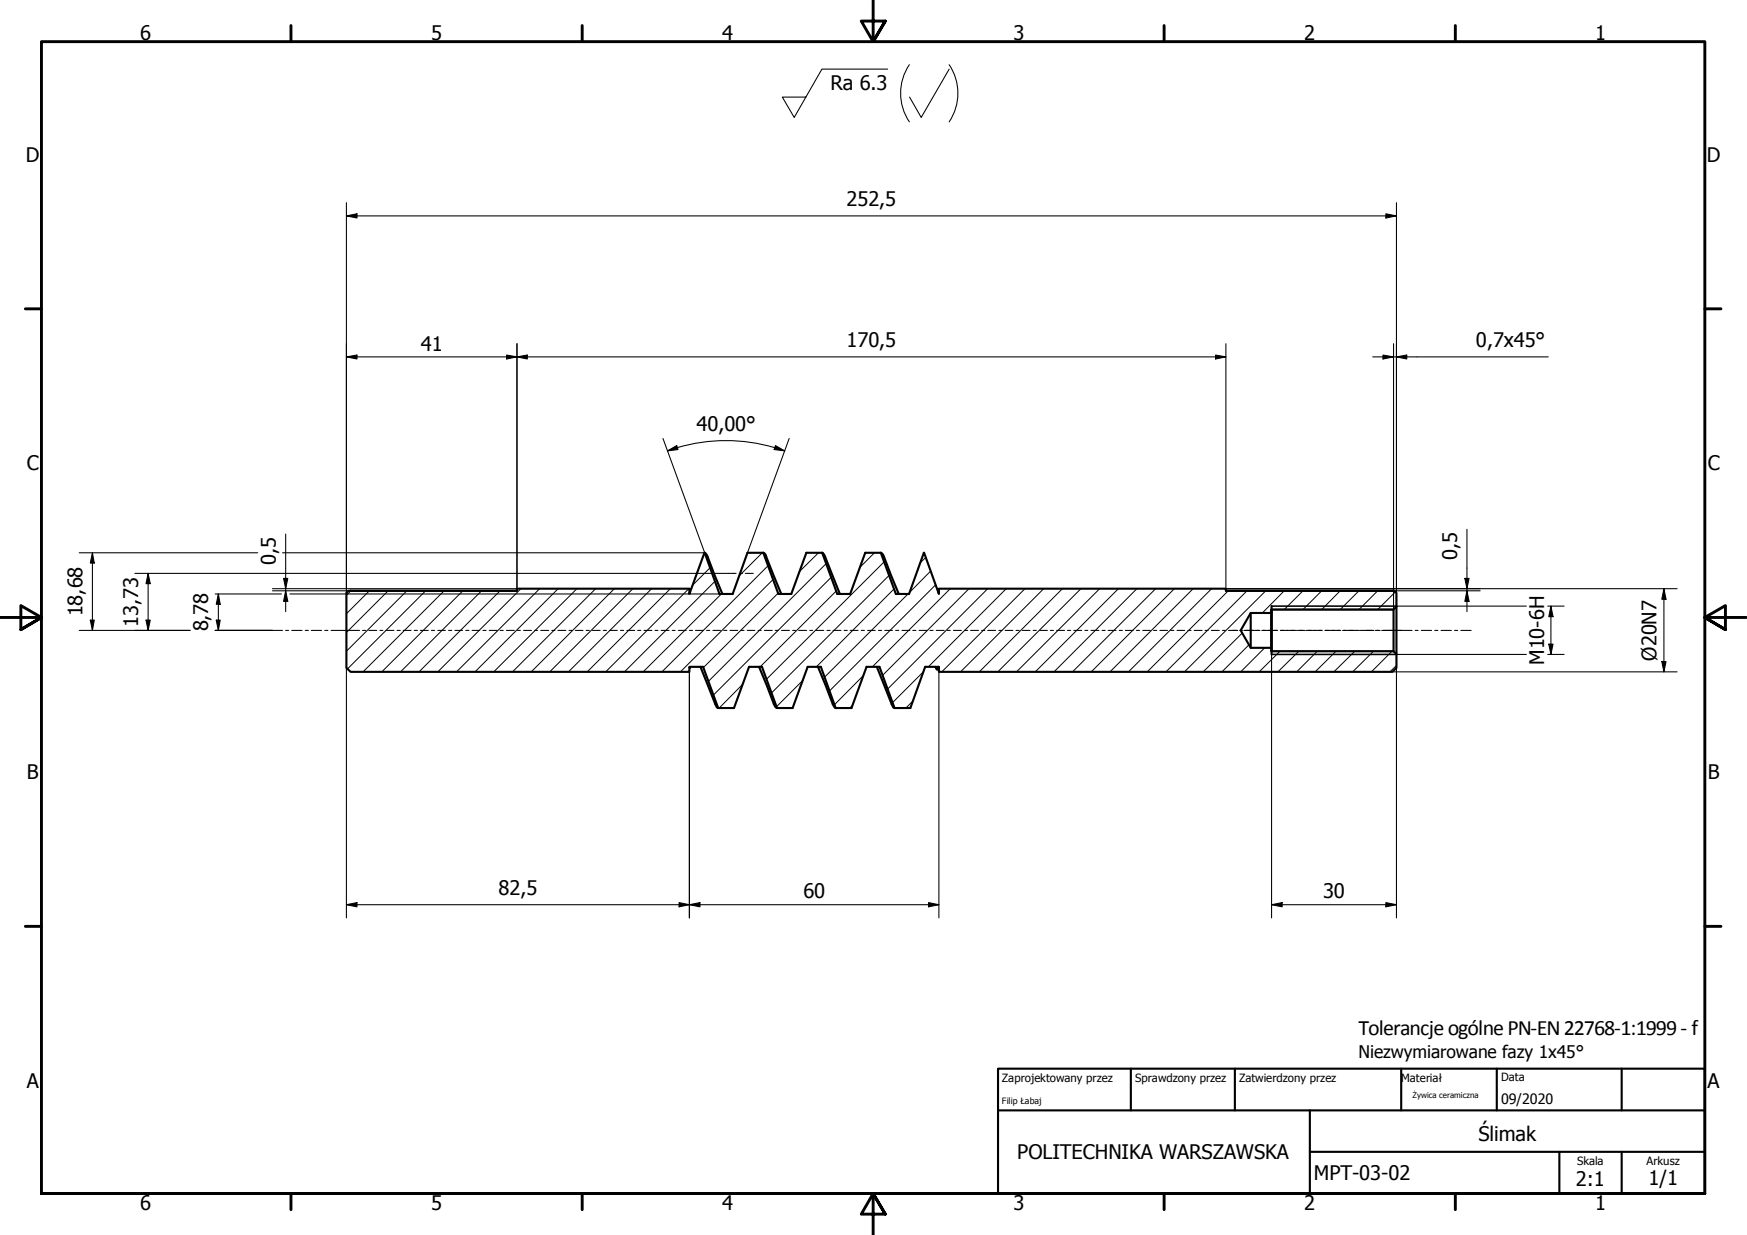
[picture p208: page 1]

Tolerancje oglne PN-EN22768-1:1999 - f
Niezwymiarowane fazy 1x45°

Zaprojektowany przez Filip àabaj | Sprawdzony przez | Zatwierdzony przez | Materiaá ywica ceramiczna | Data 09/2020

POLITECHNIKA WARSZAWSKA | limak

MPT-03-02 | Skala 2:1 | Arkusz 1/1
