f-labaj/Equatorial-Mount-MUM/Mechanika/Mechanizm elewacji i elektronika Filip/Rysunki/PDF/MPT-03-03_ślimacznica.pdf

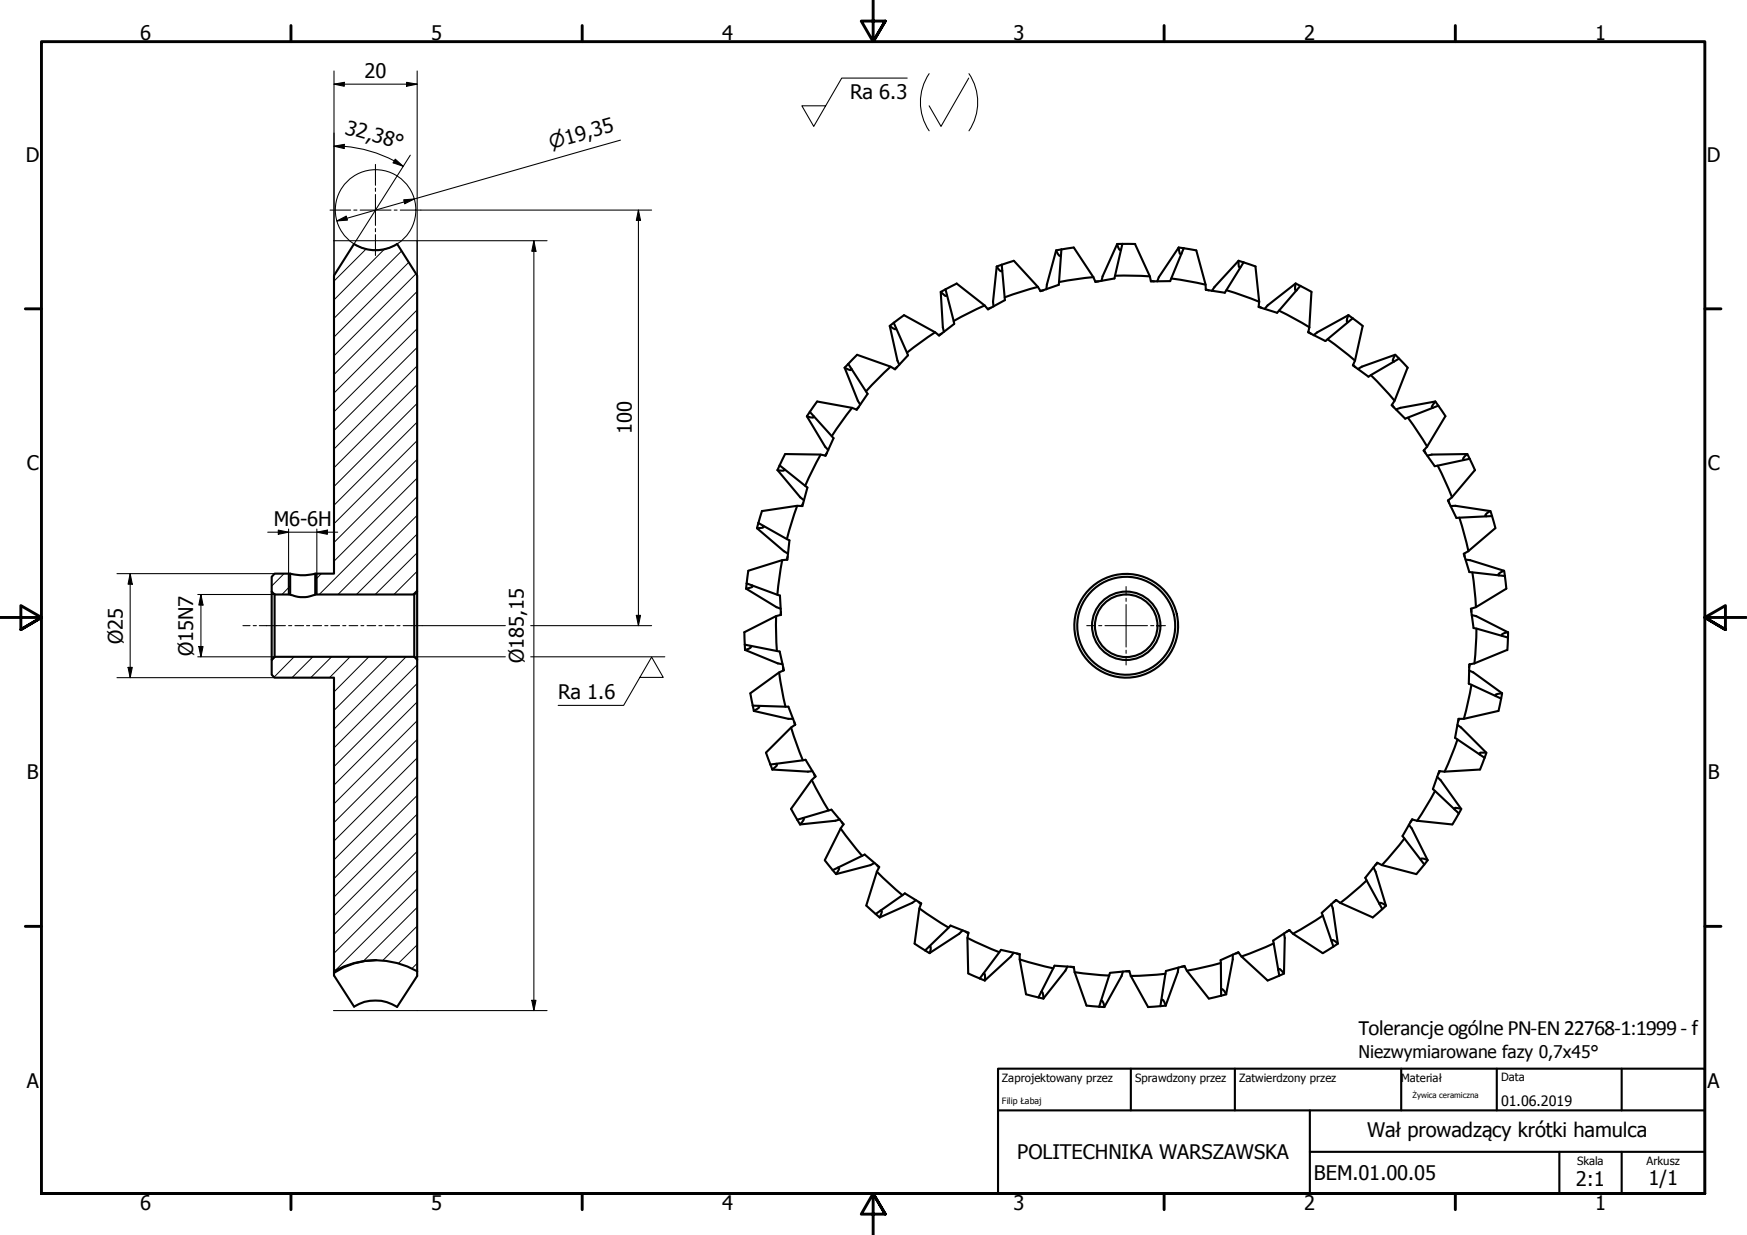
[picture p209: page 1]

Tolerancje oglne PN-EN22768-1:1999 - f
Niezwymiarowane fazy 0,7x45°

Zaprojektowany przez Filip àabaj | Sprawdzony przez | Zatwierdzony przez | Materiaá ywica ceramiczna | Data 01.06.2019

POLITECHNIKA WARSZAWSKA | Waá prowadzcy krytki hamulca

BEM.01.00.05 | Skala 2:1 | Arkusz 1/1
