f-labaj/Equatorial-Mount-MUM/Mechanika/Mechanizm elewacji i elektronika Filip/Rysunki/PDF/MPT-03-04_walek_posredni.pdf

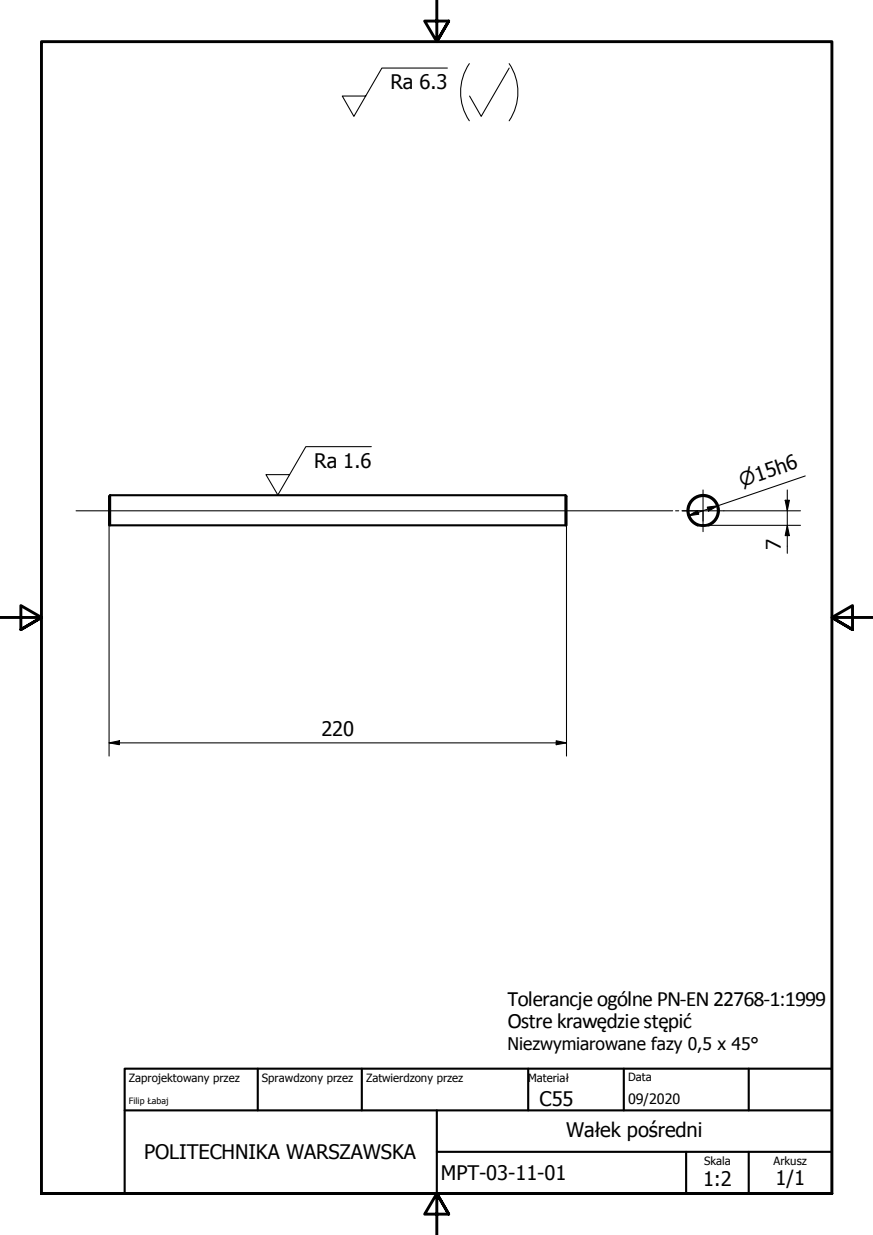
[picture p210: page 1]

Tolerancje oglne PN-EN22768-1:1999
Ostre krawdzie stpi
Niezwymiarowane fazy 0,5 x 45°

Zaprojektowany przez Filip àabaj | Sprawdzony przez | Zatwierdzony przez | Materiaá C55 | Data 09/2020

POLITECHNIKA WARSZAWSKA | Waáek poredni

MPT-03-11-01 | Skala 1:2 | Arkusz 1/1
