f-labaj/Equatorial-Mount-MUM/Mechanika/Mechanizm elewacji i elektronika Filip/Rysunki/PDF/MPT-03-05_zębnik.pdf

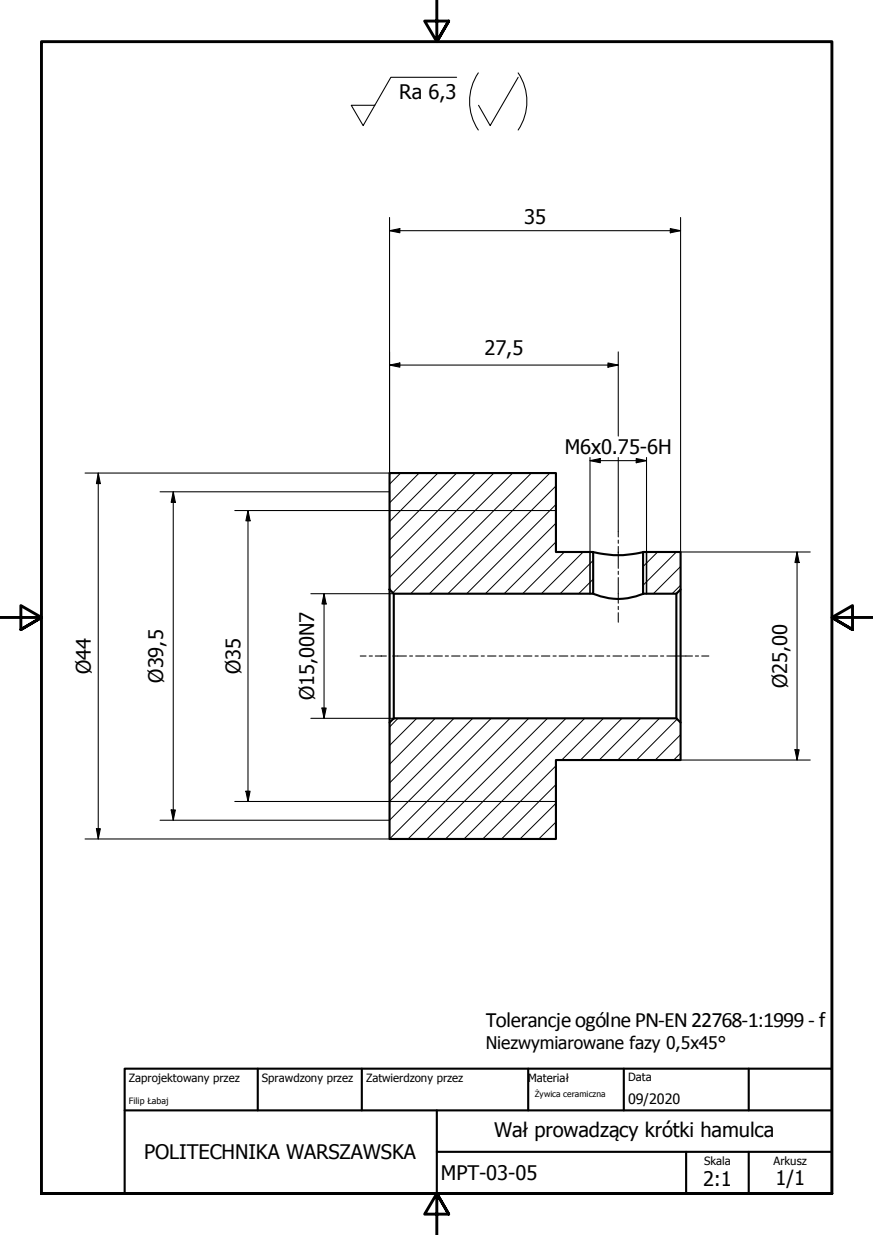
[picture p211: page 1]

Tolerancje oglne PN-EN22768-1:1999 - f
Niezwymiarowane fazy 0,5x45°

Zaprojektowany przez Filip àabaj | Sprawdzony przez | Zatwierdzony przez | Materiaá ywica ceramiczna | Data 09/2020

POLITECHNIKA WARSZAWSKA | Waá prowadzcy krytki hamulca

MPT-03-05 | Skala 2:1 | Arkusz 1/1
