f-labaj/Equatorial-Mount-MUM/Mechanika/Mechanizm elewacji i elektronika Filip/Rysunki/PDF/MPT-03-06_koło_zębate.pdf

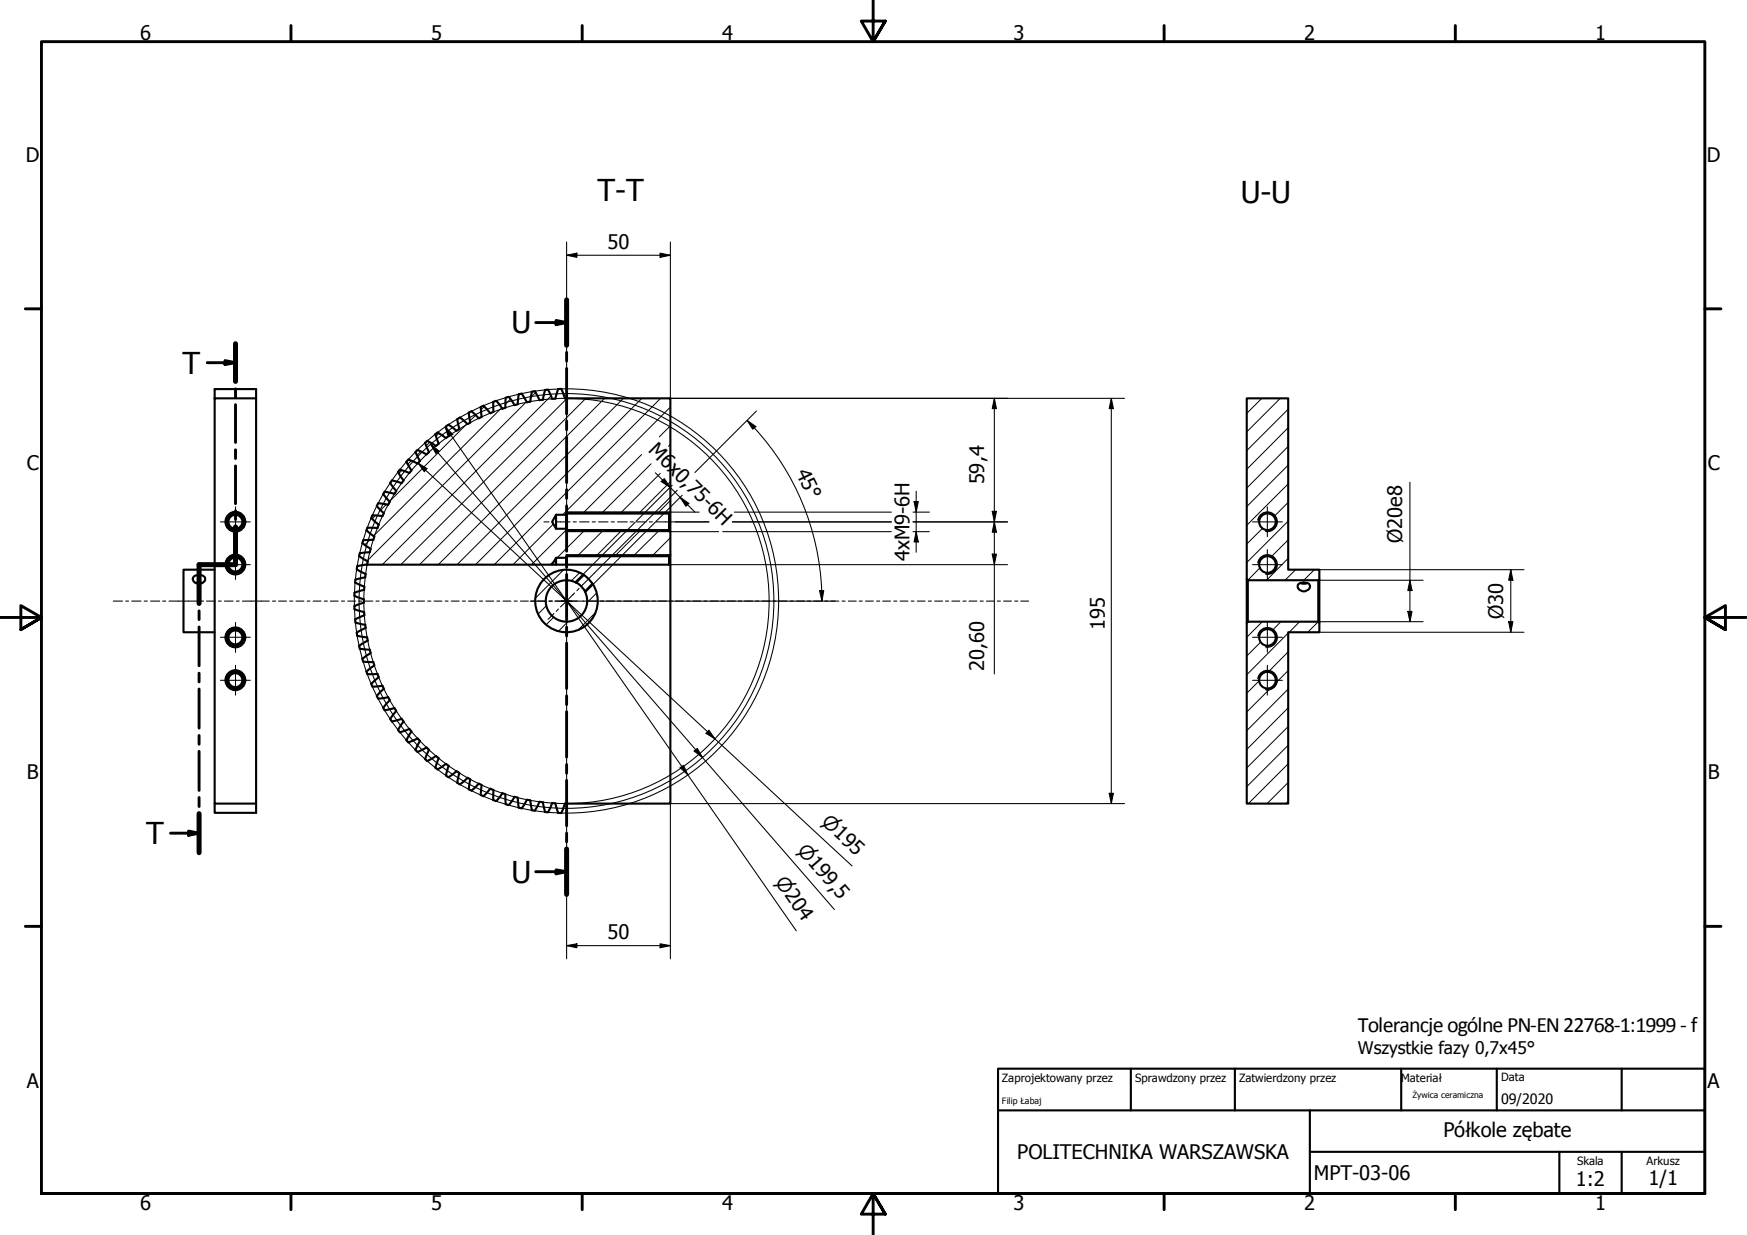
[picture p212: page 1]

Tolerancje oglne PN-EN22768-1:1999 - f
Wszystkie fazy 0,7x45°

Zaprojektowany przez Filip àabaj | Sprawdzony przez | Zatwierdzony przez | Materiaá ywica ceramiczna | Data 09/2020

POLITECHNIKA WARSZAWSKA | Pyákole zbate

MPT-03-06 | Skala 1:2 | Arkusz 1/1
