f-labaj/Equatorial-Mount-MUM/Mechanika/Mechanizm elewacji i elektronika Filip/Rysunki/PDF/MPT-03-08_rączka_korby.pdf

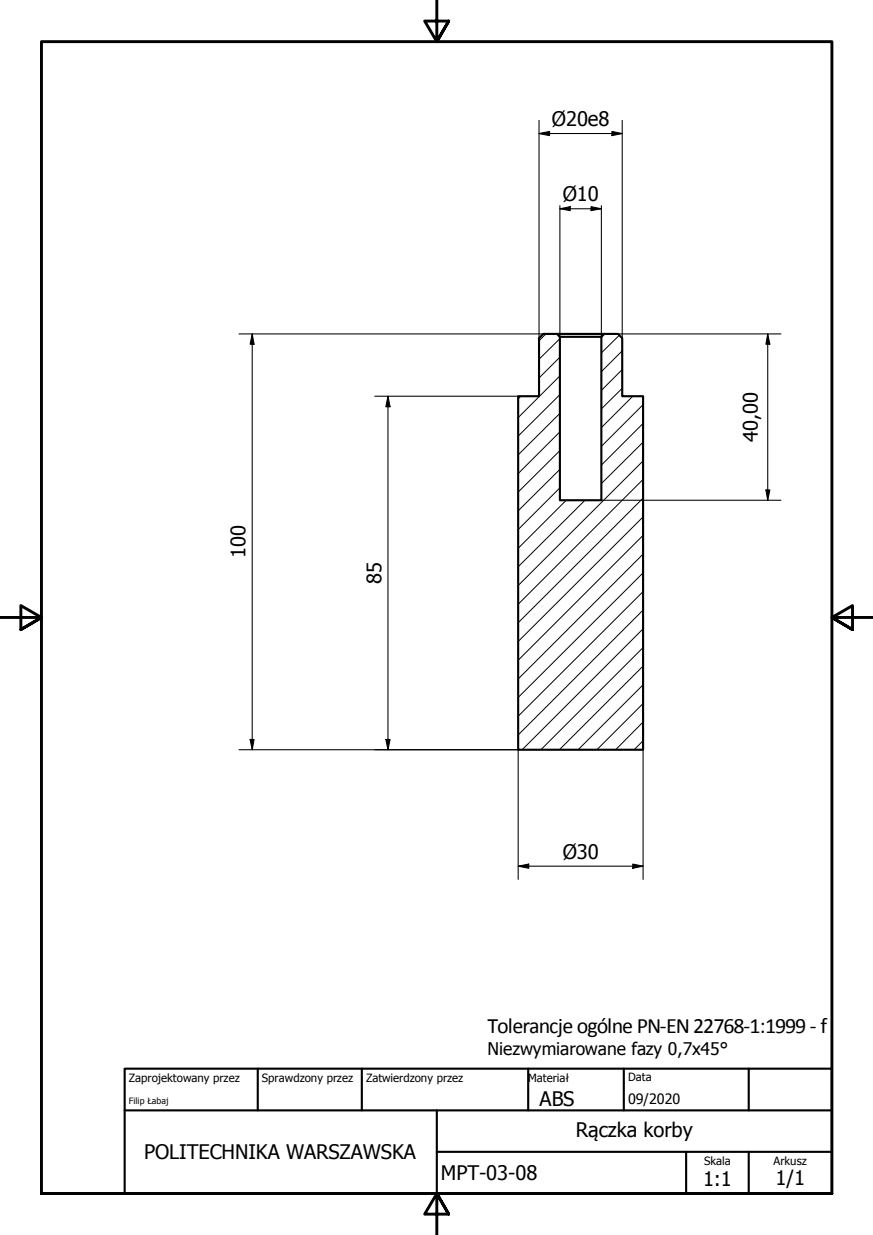
[picture p213: page 1]

Tolerancje oglne PN-EN22768-1:1999 - f
Niezwymiarowane fazy 0,7x45°

Zaprojektowany przez Filip àabaj | Sprawdzony przez | Zatwierdzony przez | Materiaá ABS | Data 09/2020

POLITECHNIKA WARSZAWSKA | Rczka korby

MPT-03-08 | Skala 1:1 | Arkusz 1/1
