f-labaj/Equatorial-Mount-MUM/Mechanika/Mechanizm elewacji i elektronika Filip/Rysunki/PDF/MPT-03-09_ramię_korby.pdf

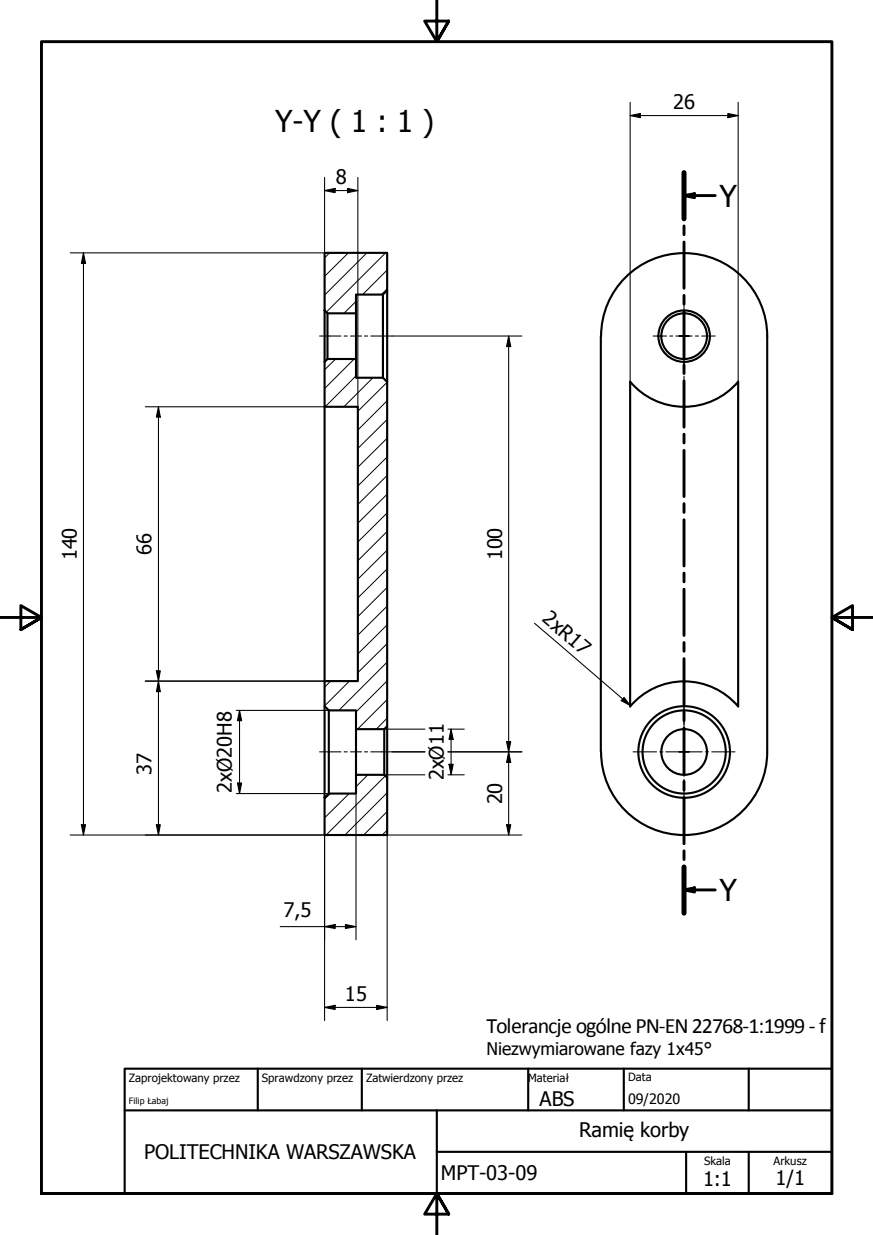
[picture p214: page 1]

Tolerancje oglne PN-EN22768-1:1999 - f
Niezwymiarowane fazy 1x45°

Zaprojektowany przez Filip àabaj | Sprawdzony przez | Zatwierdzony przez | Materiaá ABS | Data 09/2020

POLITECHNIKA WARSZAWSKA | Rami korby

MPT-03-09 | Skala 1:1 | Arkusz 1/1
