f-labaj/Equatorial-Mount-MUM/Mechanika/Mechanizm elewacji i elektronika Filip/Rysunki/PDF/MPT-03-10-01_obudowa_elektroniki.pdf

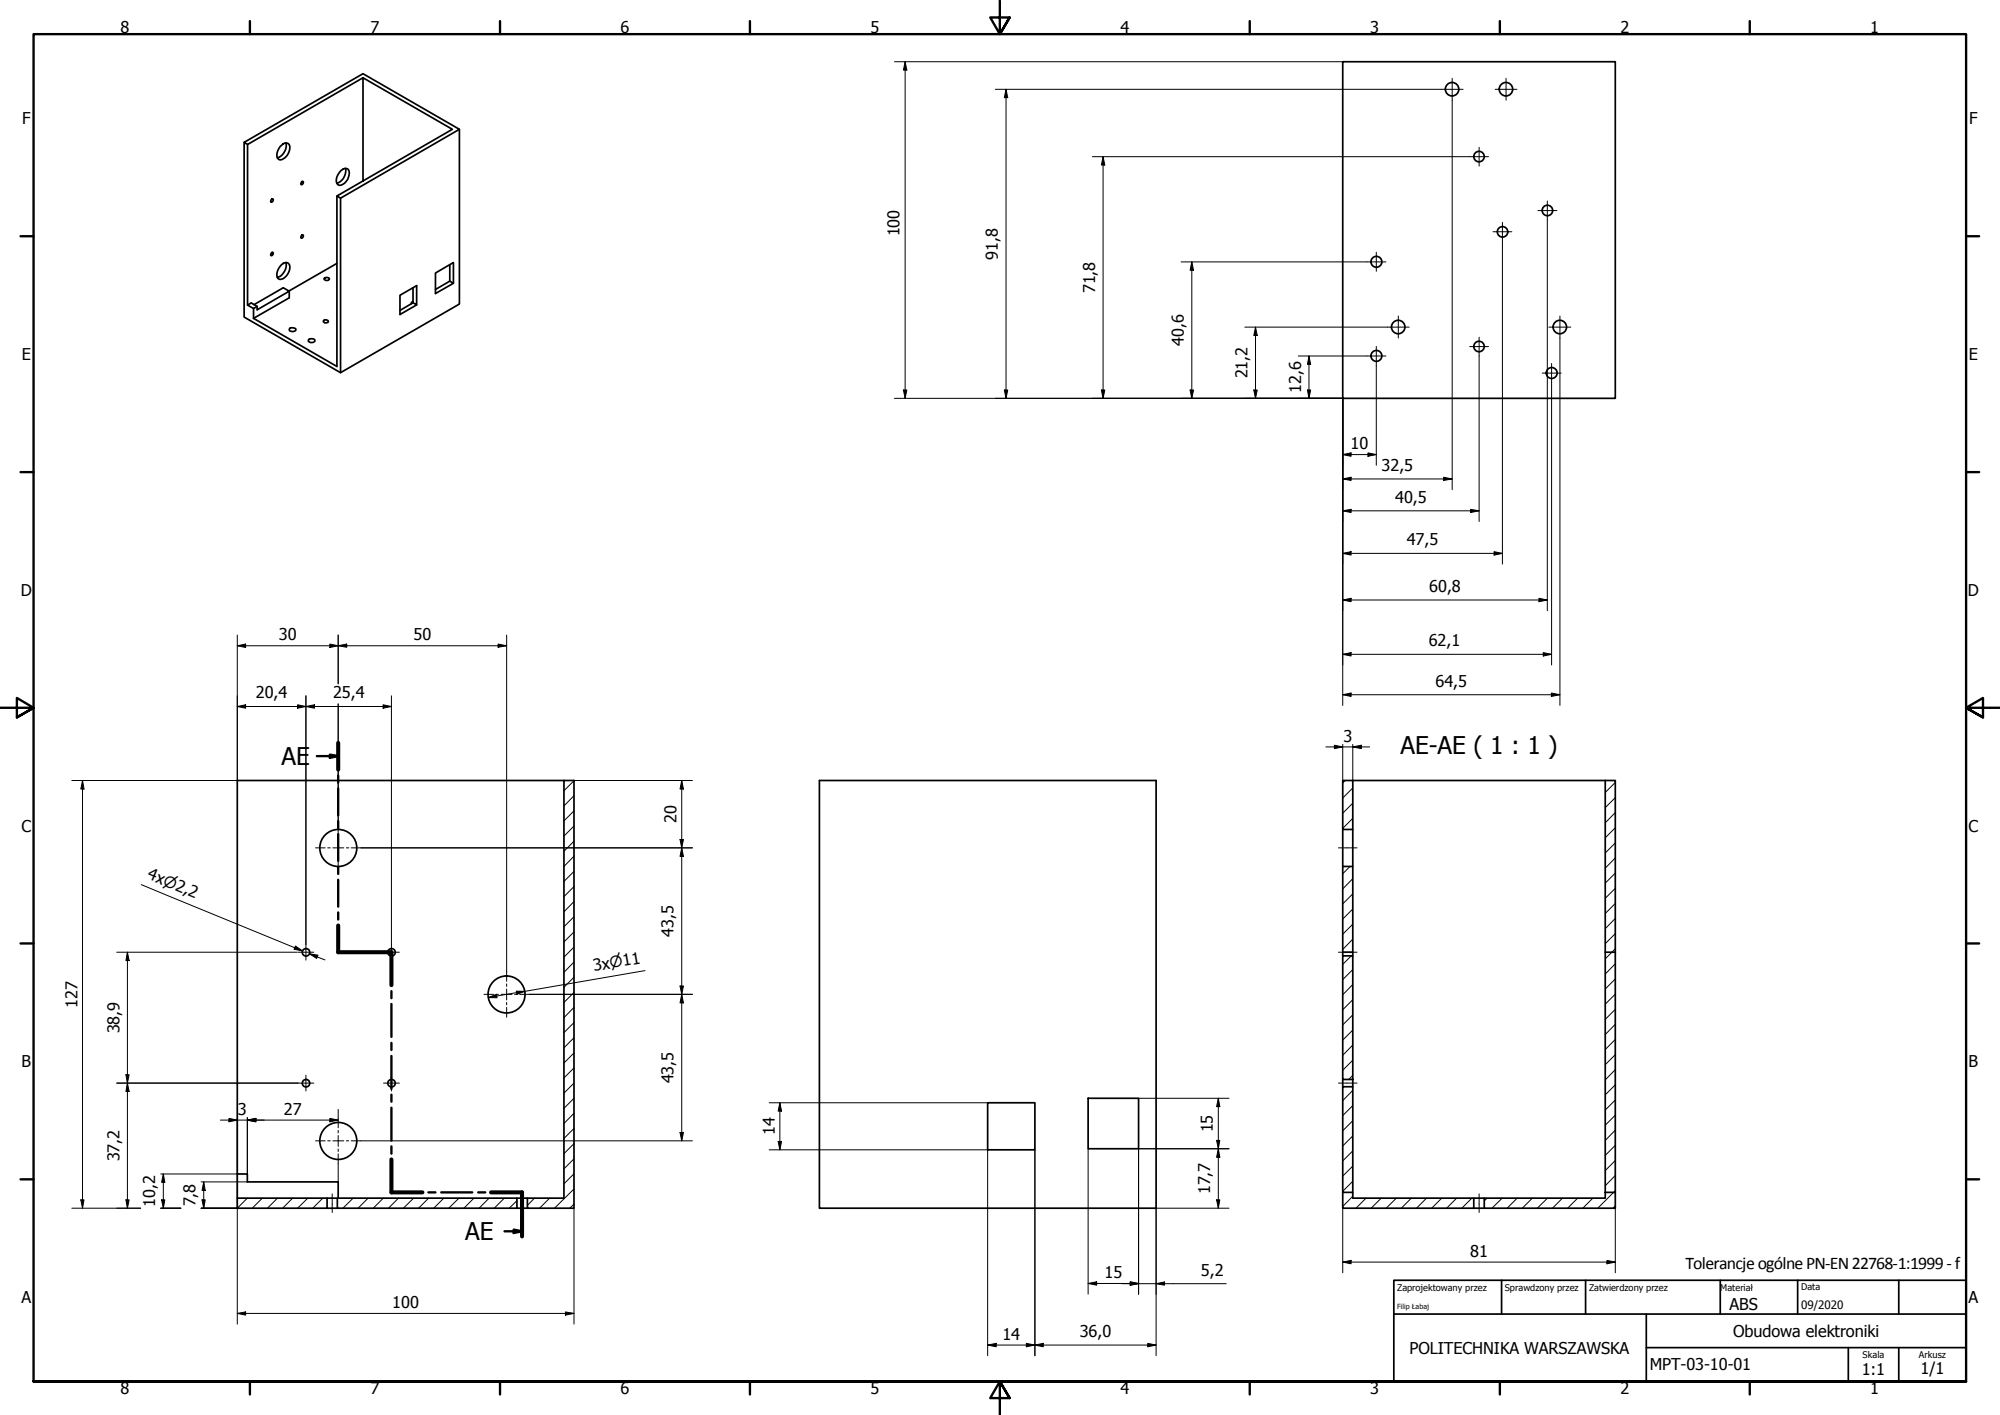
[picture p215: page 1]

Tolerancje oglne PN-EN22768-1:1999 - f

Zaprojektowany przez Filip àabaj | Sprawdzony przez | Zatwierdzony przez | Materiaá ABS | Data 09/2020

POLITECHNIKA WARSZAWSKA | Obudowa elektroniki

MPT-03-10-01 | Skala 1:1 | Arkusz 1/1
