f-labaj/Equatorial-Mount-MUM/Mechanika/Mechanizm elewacji i elektronika Filip/Rysunki/PDF/MPT-03-10_moduł_elektroniki.pdf

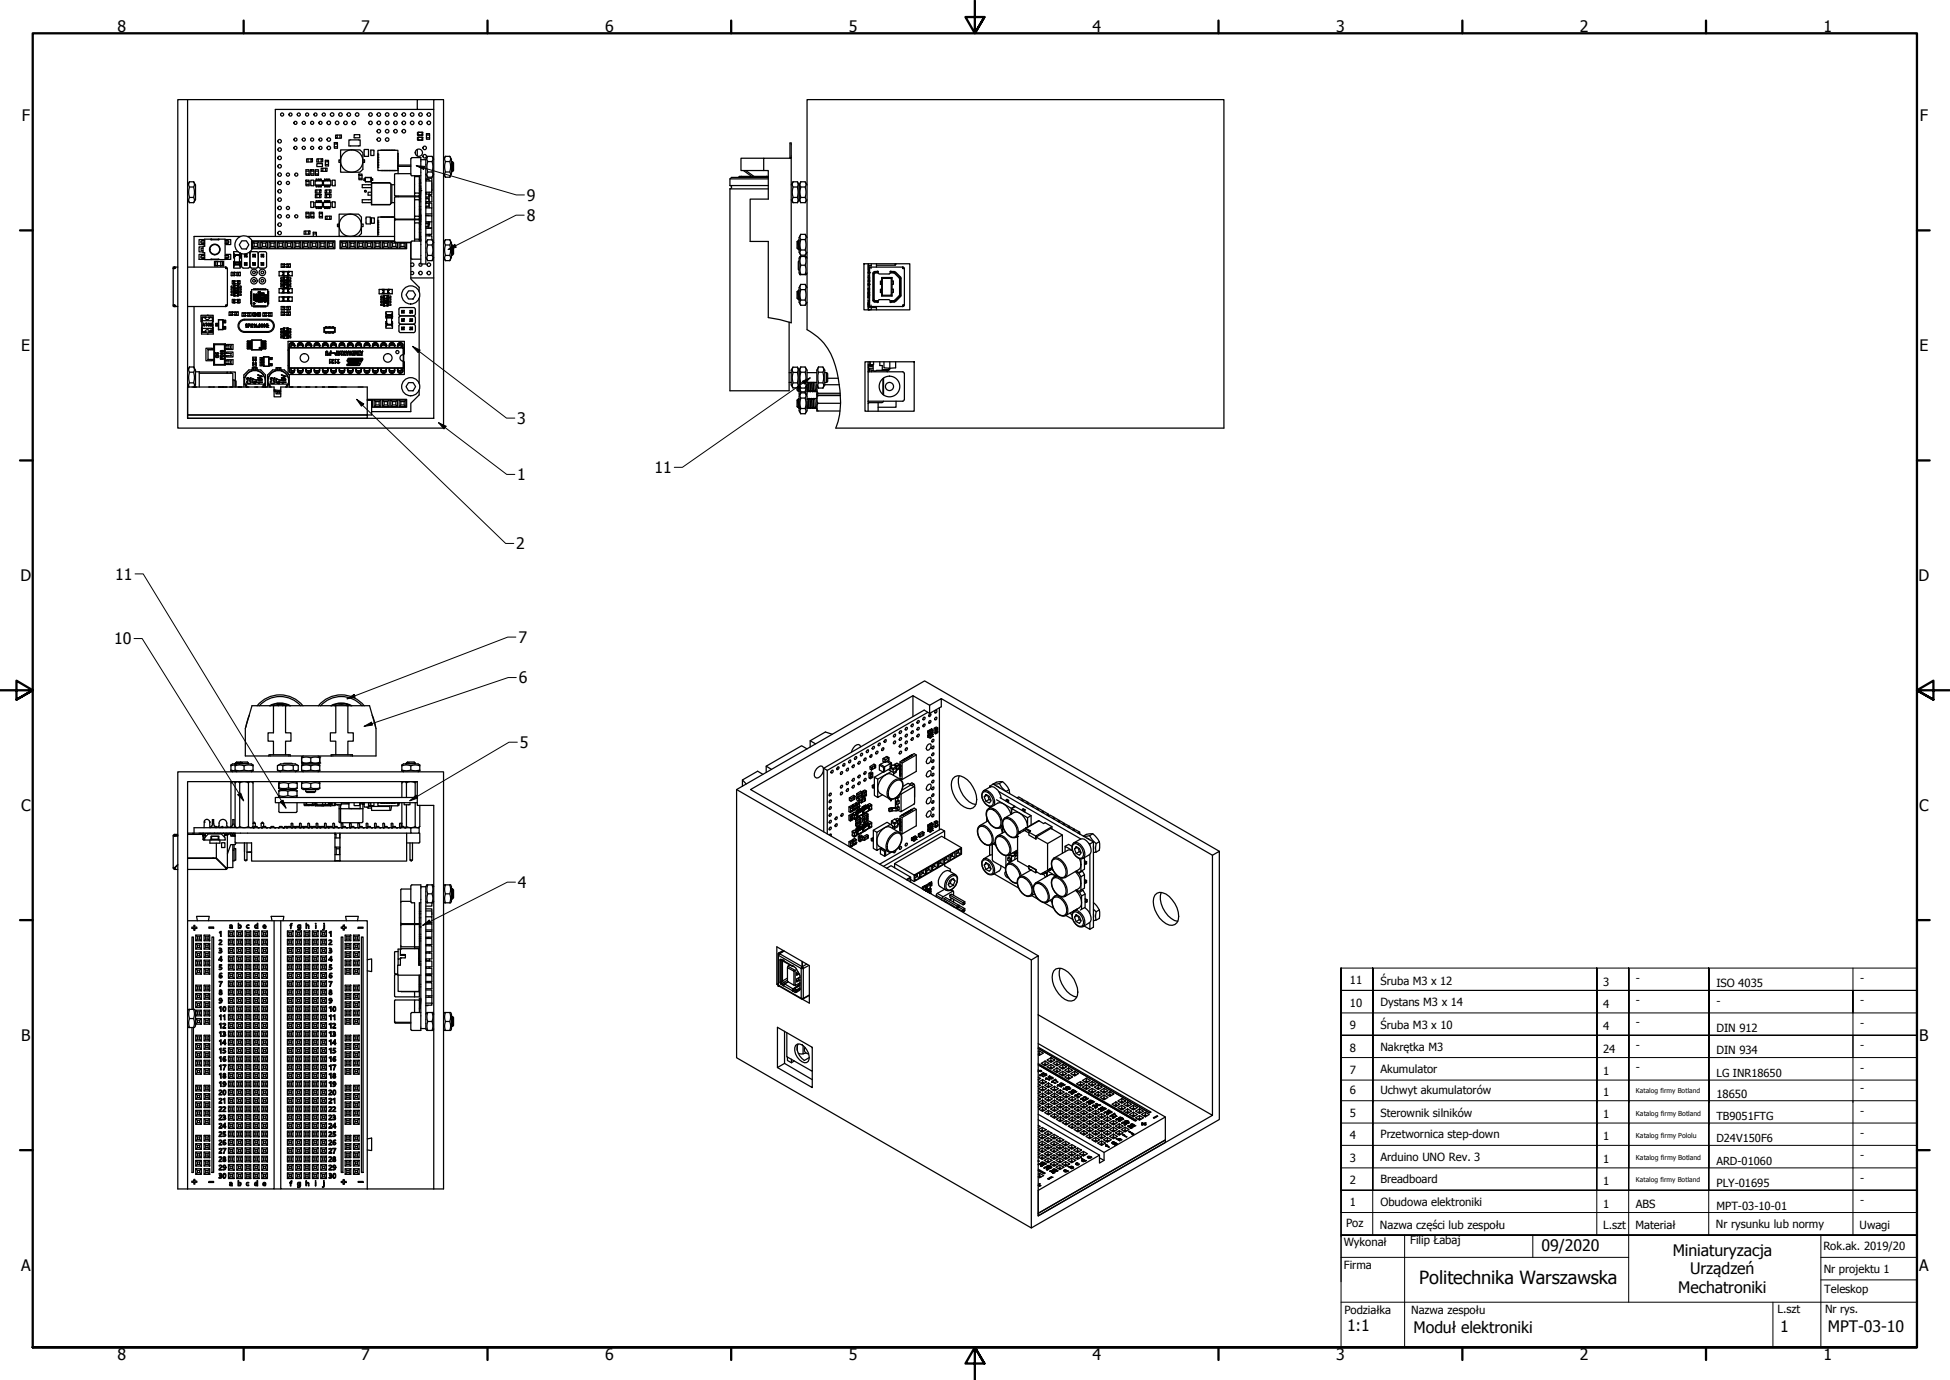
[picture p216: page 1]
Dystans M3 x 14; Uchwyt akumulatoryw; Moduá elektroniki; Politechnika Warszawska; Sterownik silnikyw; Przetwornica step-down; Obudowa elektroniki; Nazwa zespoáu; ISO 4035; DIN 912; DIN 934; LG INR18650; Rok.ak. 2019/20; Nr projektu 1; L.szt; Nr rys.; - MPT-03-10-01

Katalog firmy Botland

Katalog firmy Pololu

Arduino UNO Rev. 3

Nazwa czci lub zespoáu
Filip àabaj

Nr rysunku lub normy
