f-labaj/Equatorial-Mount-MUM/Mechanika/Mechanizm elewacji i elektronika Filip/Rysunki/PDF/MPT-03-11-02_obudowa_elektroniki_zewnętrznej.pdf

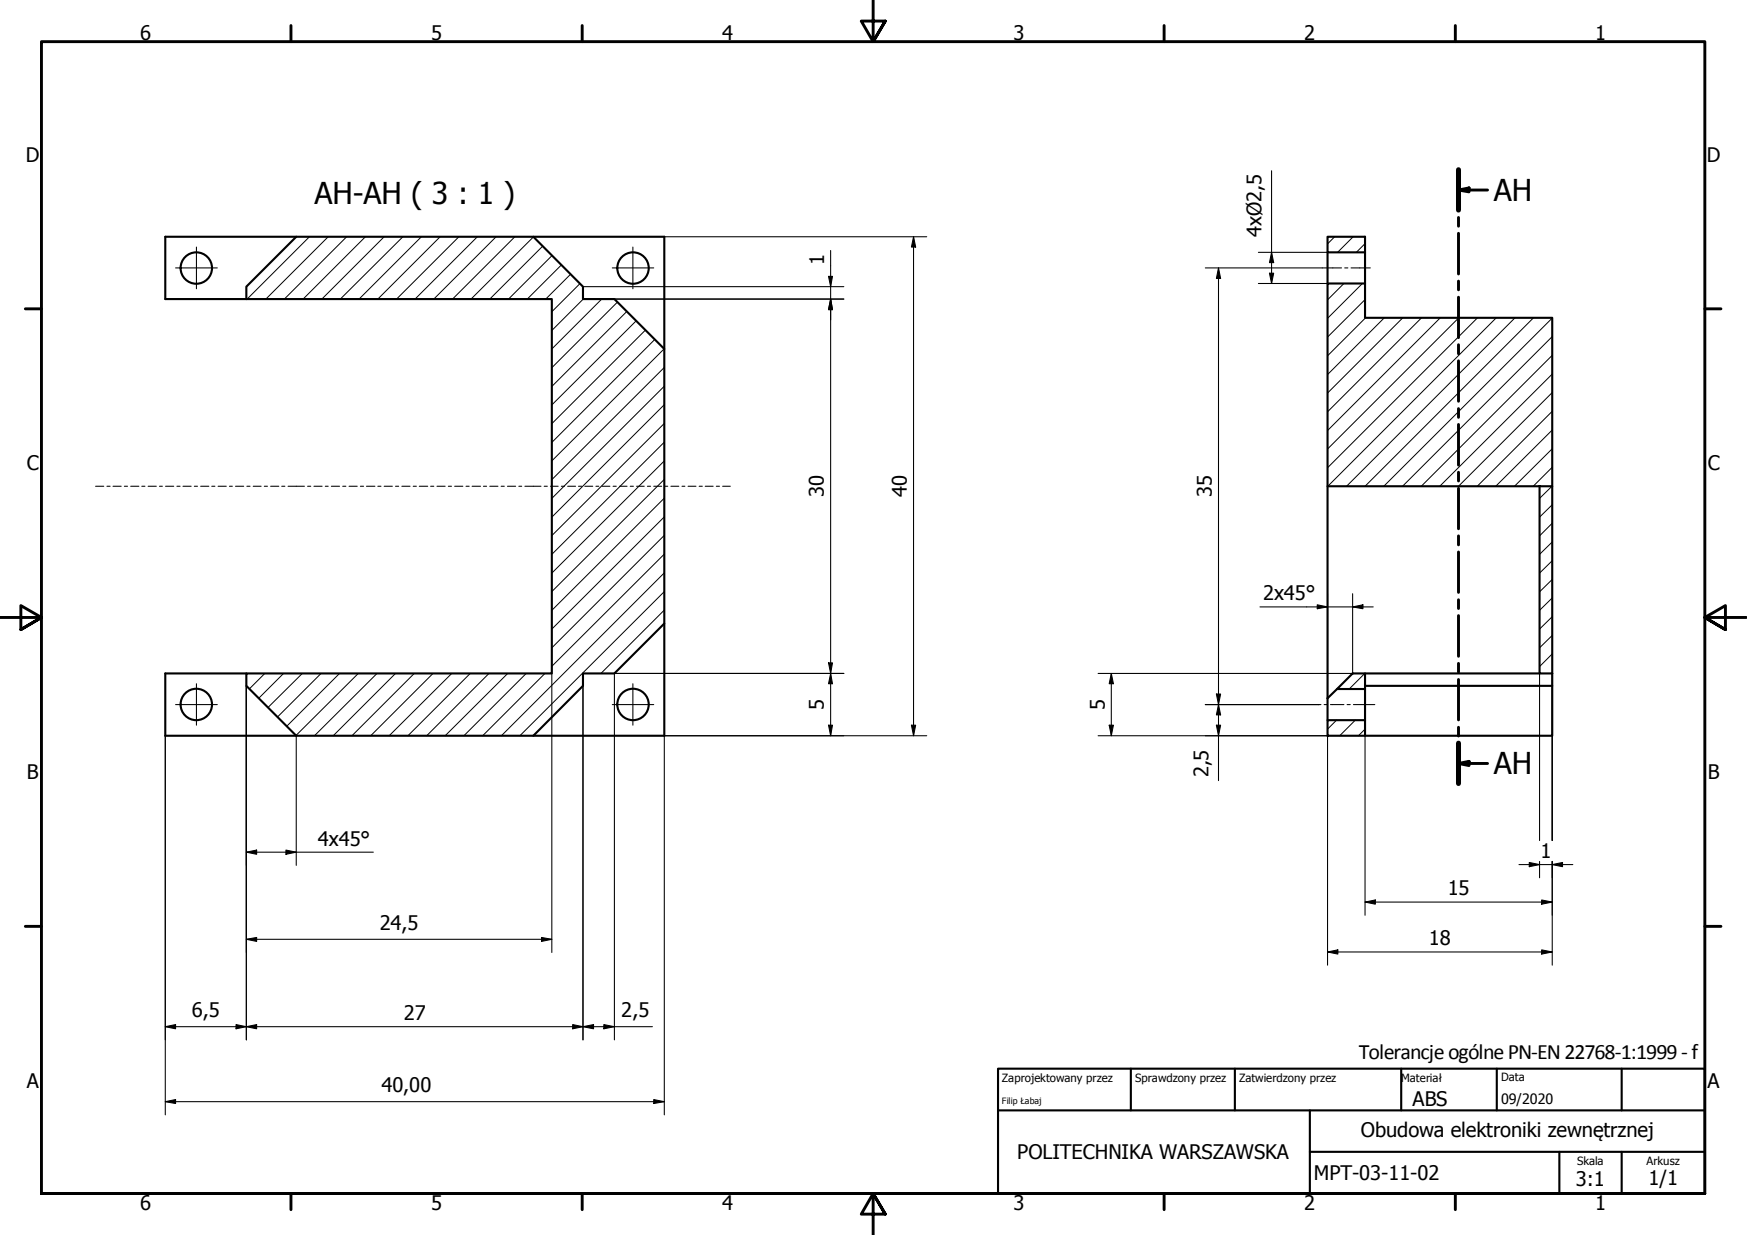
[picture p217: page 1]

Tolerancje oglne PN-EN22768-1:1999 - f

Zaprojektowany przez Filip àabaj | Sprawdzony przez | Zatwierdzony przez | Materiaá ABS | Data 09/2020

POLITECHNIKA WARSZAWSKA | Obudowa elektroniki zewntrznej

MPT-03-11-02 | Skala 3:1 | Arkusz 1/1
