f-labaj/Equatorial-Mount-MUM/Mechanika/Mechanizm elewacji i elektronika Filip/Rysunki/PDF/MPT-03-11_elektronika_zewnetrzna_zlozenie.pdf

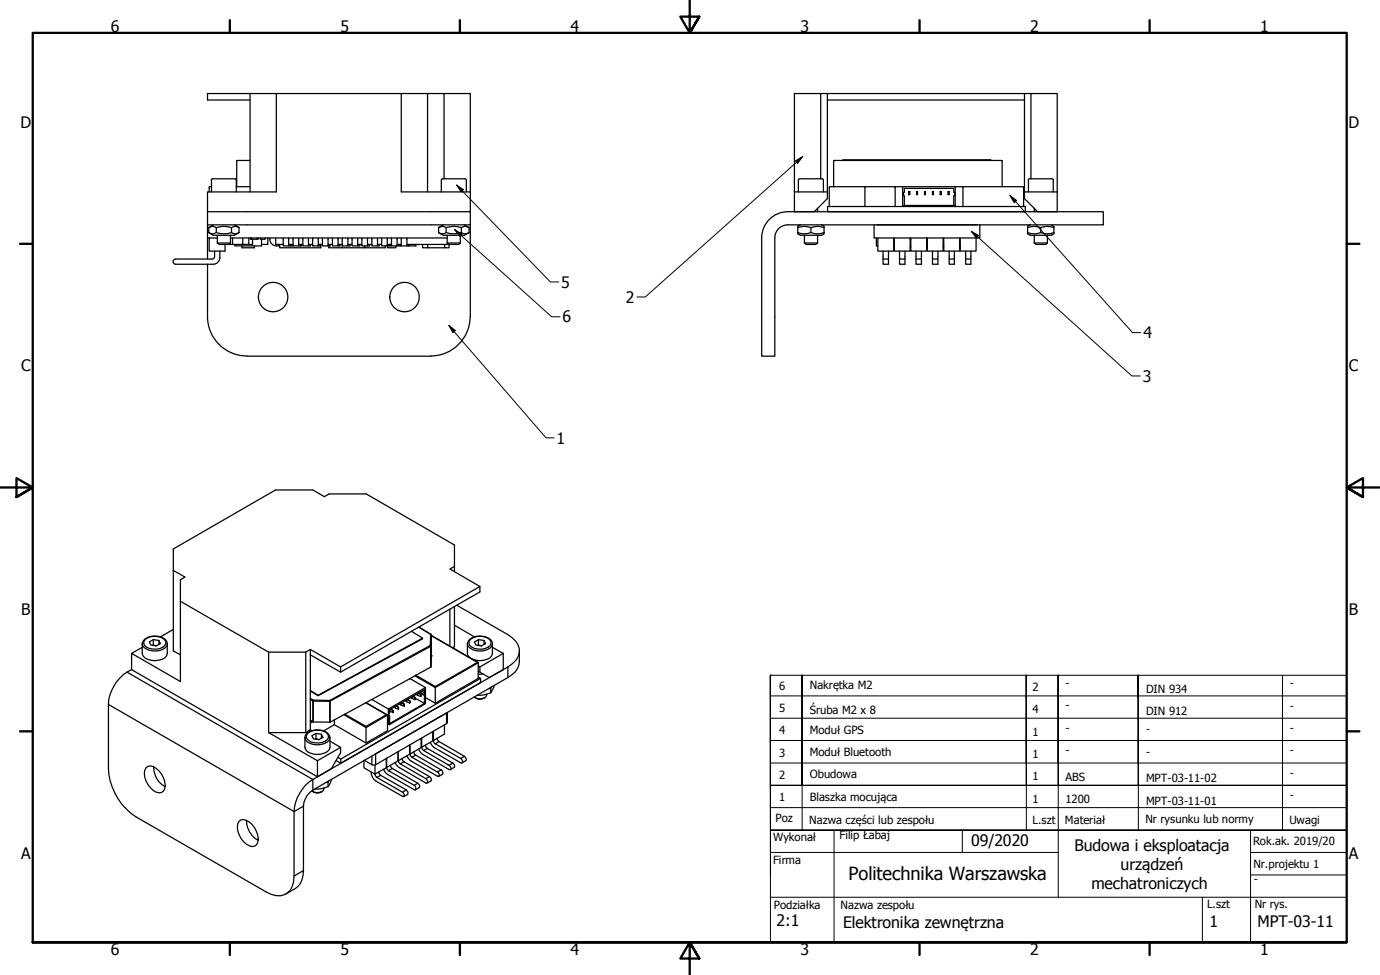
[picture p218: page 1]
L.szt; Nr rys.

6 | Nakrtka M2 | 2 | - | | - DIN 934

5 | ruba M2 x 8 | 4 | - | DIN 912 | -

4 | Moduá GPS | 1 | - | - | -

3 | Moduá Bluetooth | 1 | - | - | -

2 | Obudowa | 1 | ABS | MPT-03-11-02 | -

1 | Blaszka mocujca | 1 | 1200 | | - MPT-03-11-01

Poz | Nazwa czci lub zespoáu | L.szt | Materiaá | Nr rysunku lub normy | Uwagi
Wykonaá | Filip àabaj | 09/2020 | Budowa i eksploatacja urzdze mechatroniczych | Rok.ak. 2019/20
Firma | Politechnika Warszawska | | | Nr.projektu 1

Nazwa zespoáu
Elektronika zewntrzna
