f-labaj/Equatorial-Mount-MUM/Mechanika/Mechanizm elewacji i elektronika Filip/Rysunki/PDF/MPT-03-12_szczęka_hamulca_krótka.pdf

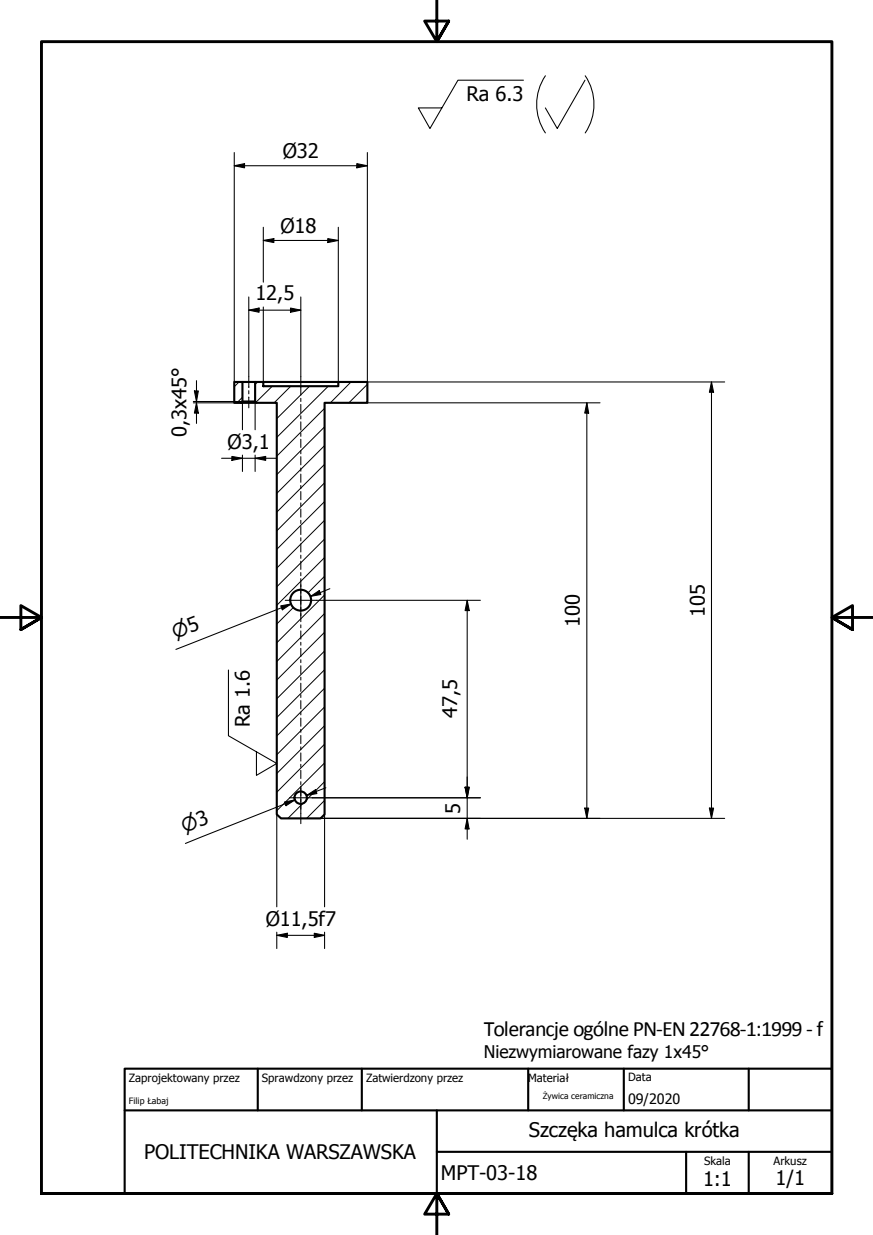
[picture p219: page 1]

Tolerancje oglne PN-EN22768-1:1999 - f
Niezwymiarowane fazy 1x45°

Zaprojektowany przez Filip àabaj | Sprawdzony przez | Zatwierdzony przez | Materiaá ywica ceramiczna | Data 09/2020

POLITECHNIKA WARSZAWSKA | Szczka hamulca krytka

MPT-03-18 | Skala 1:1 | Arkusz 1/1
