f-labaj/Equatorial-Mount-MUM/Mechanika/Mechanizm elewacji i elektronika Filip/Rysunki/PDF/MPT-03-13_szczęka_hamulca_długa.pdf

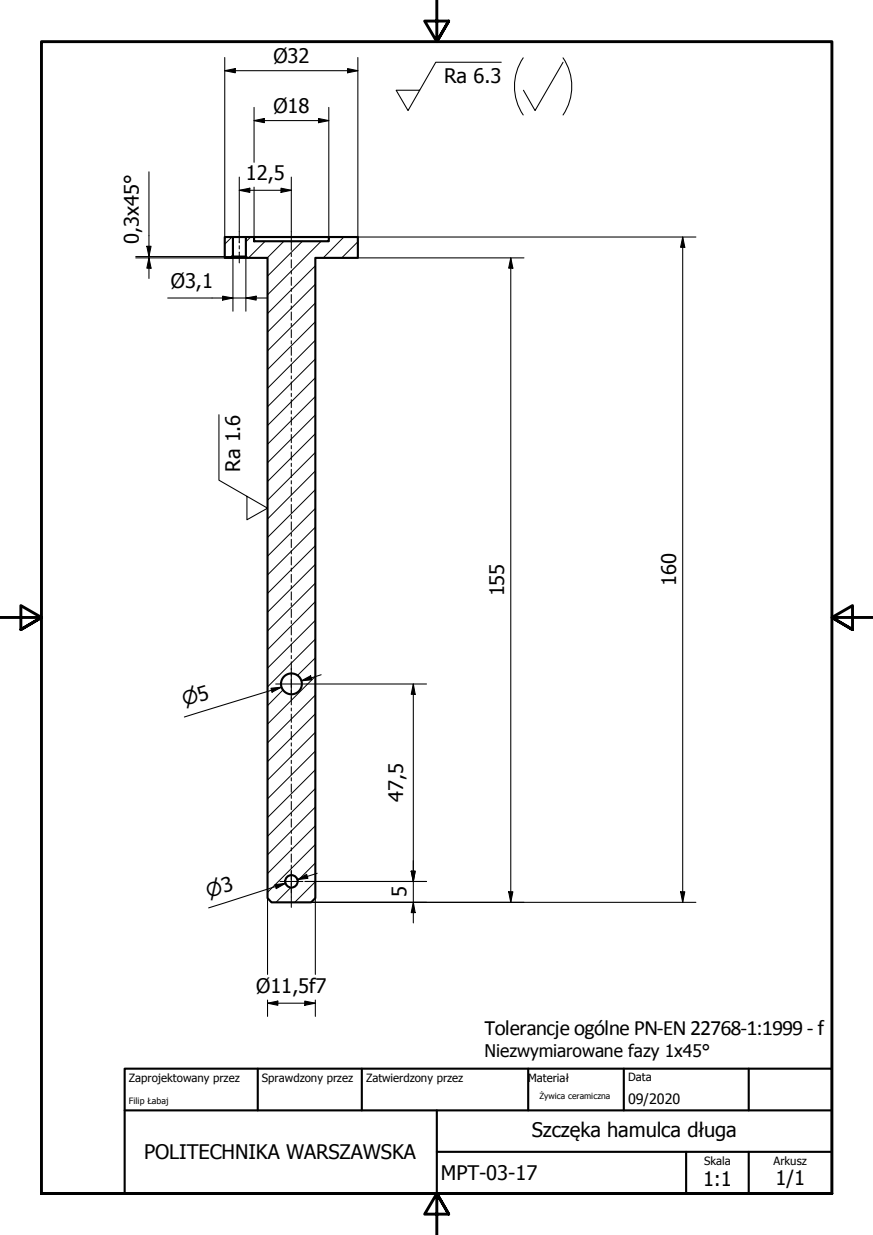
[picture p220: page 1]

Tolerancje oglne PN-EN22768-1:1999 - f
Niezwymiarowane fazy 1x45°

Zaprojektowany przez Filip àabaj | Sprawdzony przez | Zatwierdzony przez | Materiaá ywica ceramiczna | Data 09/2020

POLITECHNIKA WARSZAWSKA | Szczka hamulca dáuga

MPT-03-17 | Skala 1:1 | Arkusz 1/1
