f-labaj/Equatorial-Mount-MUM/Mechanika/Mechanizm elewacji i elektronika Filip/Rysunki/PDF/MPT-03-14_pokrywa_górna_krótka.pdf

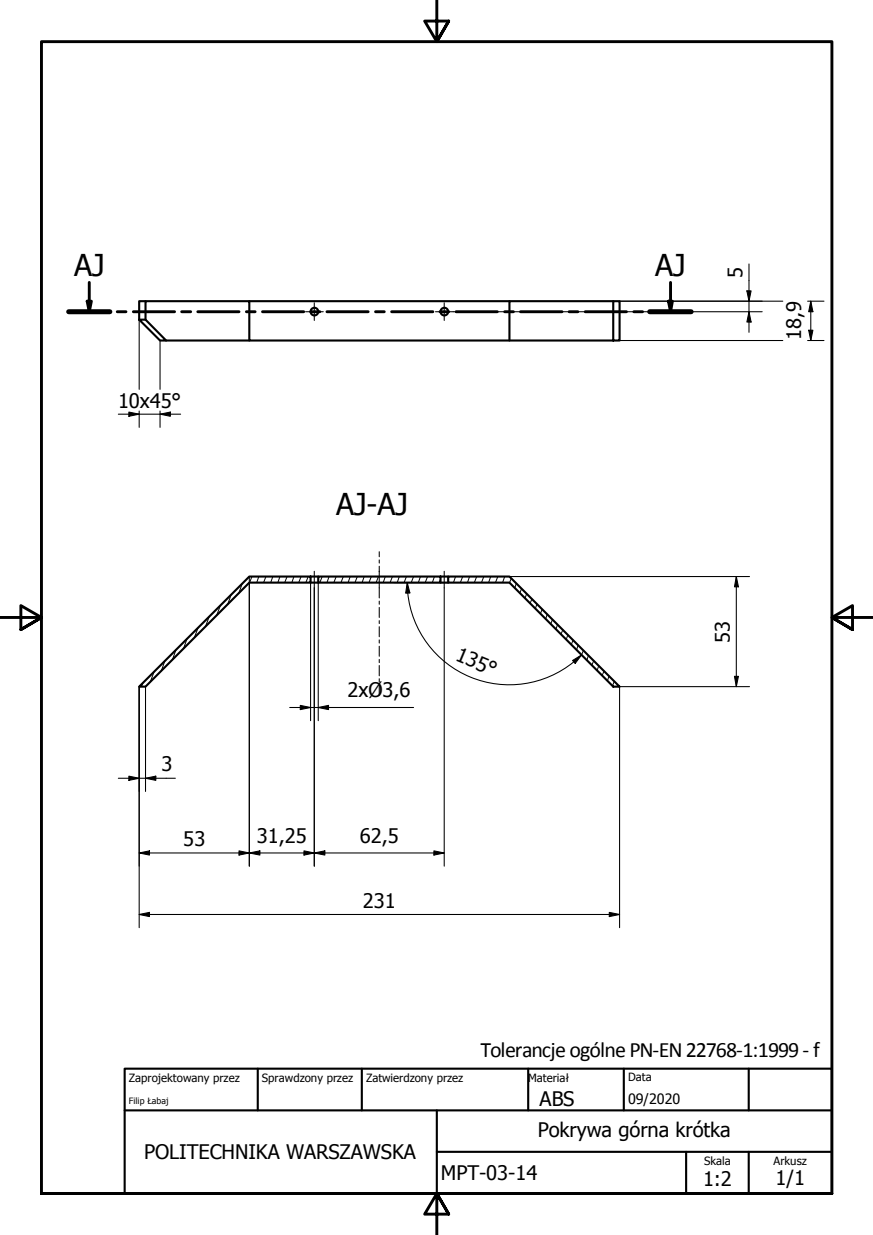
[picture p221: page 1]

Tolerancje oglne PN-EN22768-1:1999 - f

Zaprojektowany przez Filip àabaj | Sprawdzony przez | Zatwierdzony przez | Materiaá ABS | Data 09/2020

POLITECHNIKA WARSZAWSKA | Pokrywa gyrna krytka

MPT-03-14 | Skala 1:2 | Arkusz 1/1
