f-labaj/Equatorial-Mount-MUM/Mechanika/Mechanizm elewacji i elektronika Filip/Rysunki/PDF/MPT-03-15_pokrywa_górna_długa.pdf

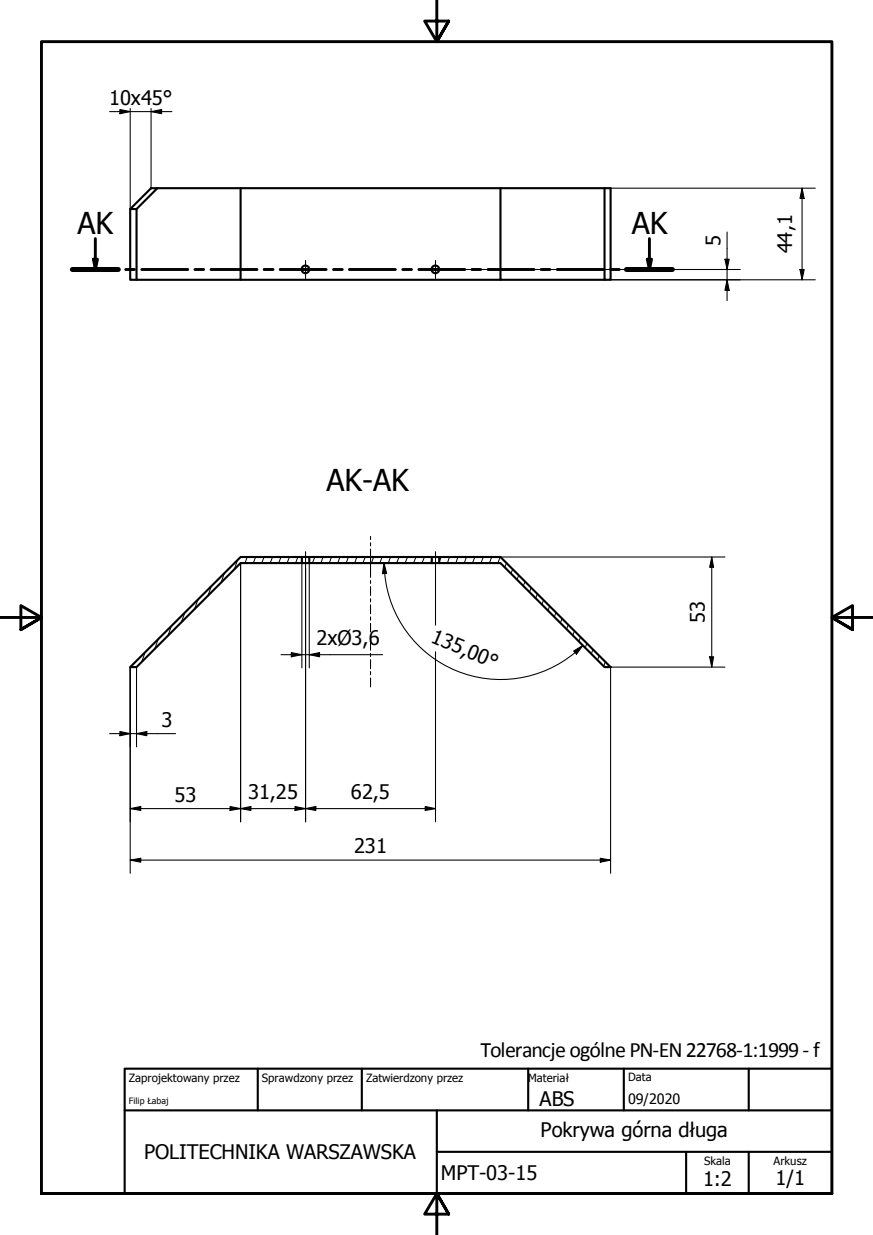
[picture p222: page 1]

Tolerancje oglne PN-EN22768-1:1999 - f

Zaprojektowany przez Filip àabaj | Sprawdzony przez | Zatwierdzony przez | Materiaá ABS | Data 09/2020

POLITECHNIKA WARSZAWSKA | Pokrywa gyrna dáuga

MPT-03-15 | Skala 1:2 | Arkusz 1/1
