f-labaj/Equatorial-Mount-MUM/Mechanika/Mechanizm elewacji i elektronika Filip/Rysunki/PDF/MPT-03-17_pokrywa_elektroniki.pdf

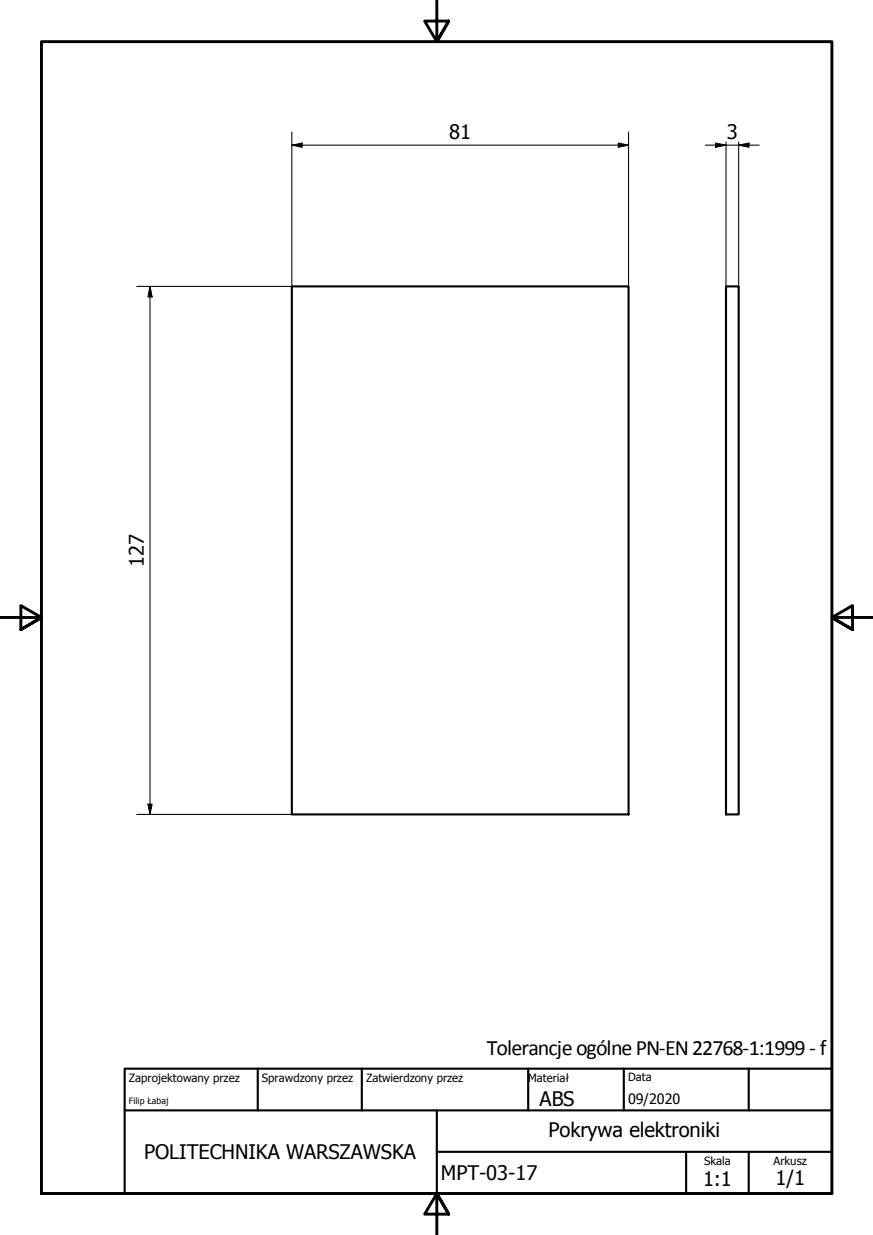
[picture p223: page 1]

Tolerancje oglne PN-EN22768-1:1999 - f

Zaprojektowany przez Filip àabaj | Sprawdzony przez | Zatwierdzony przez | Materiaá ABS | Data 09/2020

POLITECHNIKA WARSZAWSKA | Pokrywa elektroniki

MPT-03-17 | Skala 1:1 | Arkusz 1/1
