f-labaj/Equatorial-Mount-MUM/Mechanika/Mechanizm elewacji i elektronika Filip/Rysunki/PDF/MPT-03-19_wał_prowadzący_dlugi_hamulca.pdf

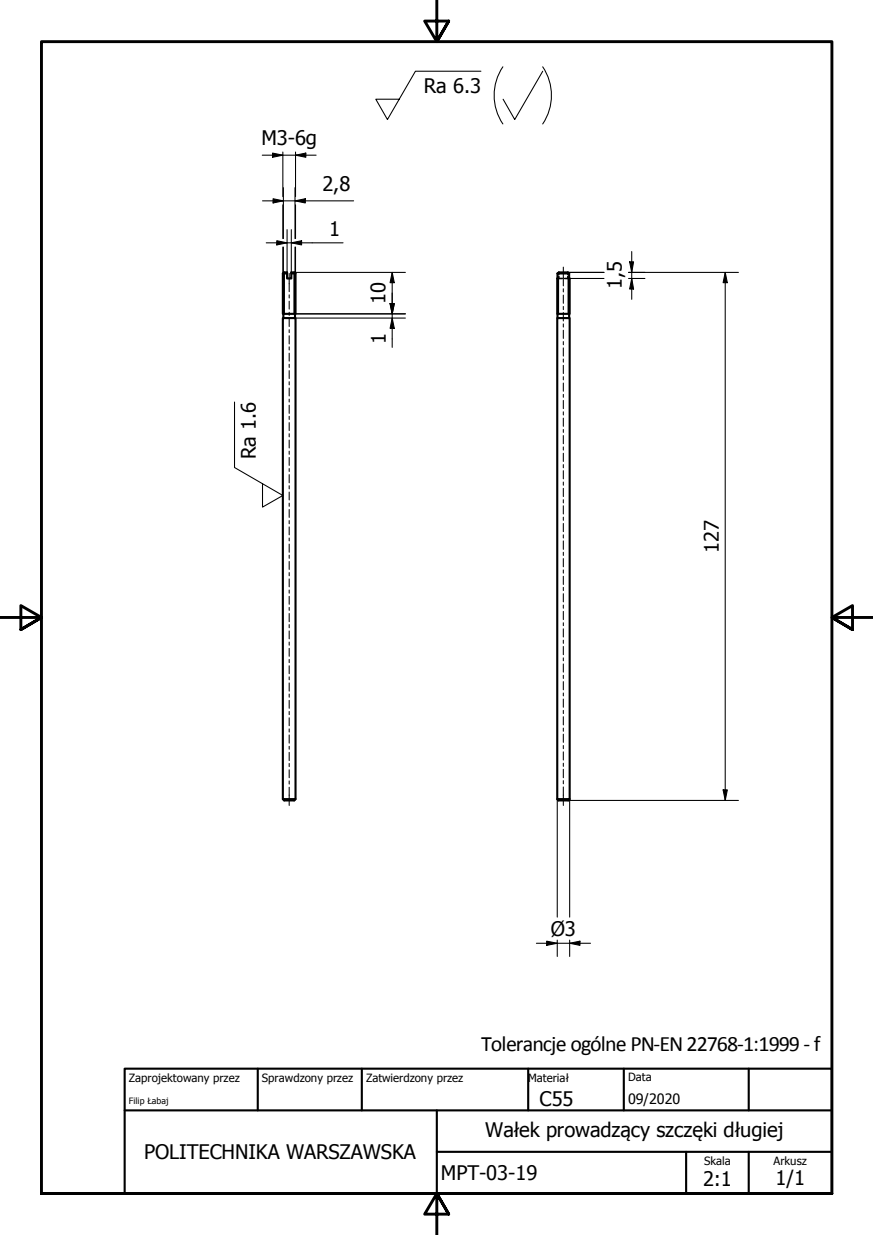
[picture p224: page 1]

Tolerancje oglne PN-EN22768-1:1999 - f

Zaprojektowany przez Filip àabaj | Sprawdzony przez | Zatwierdzony przez | Materiaá C55 | Data 09/2020

POLITECHNIKA WARSZAWSKA | Waáek prowadzcy szczki dáugiej

MPT-03-19 | Skala 2:1 | Arkusz 1/1
