f-labaj/Equatorial-Mount-MUM/Mechanika/Mechanizm elewacji i elektronika Filip/Rysunki/PDF/MPT-03-20_wał_prowadzący_krótki_hamulca.pdf

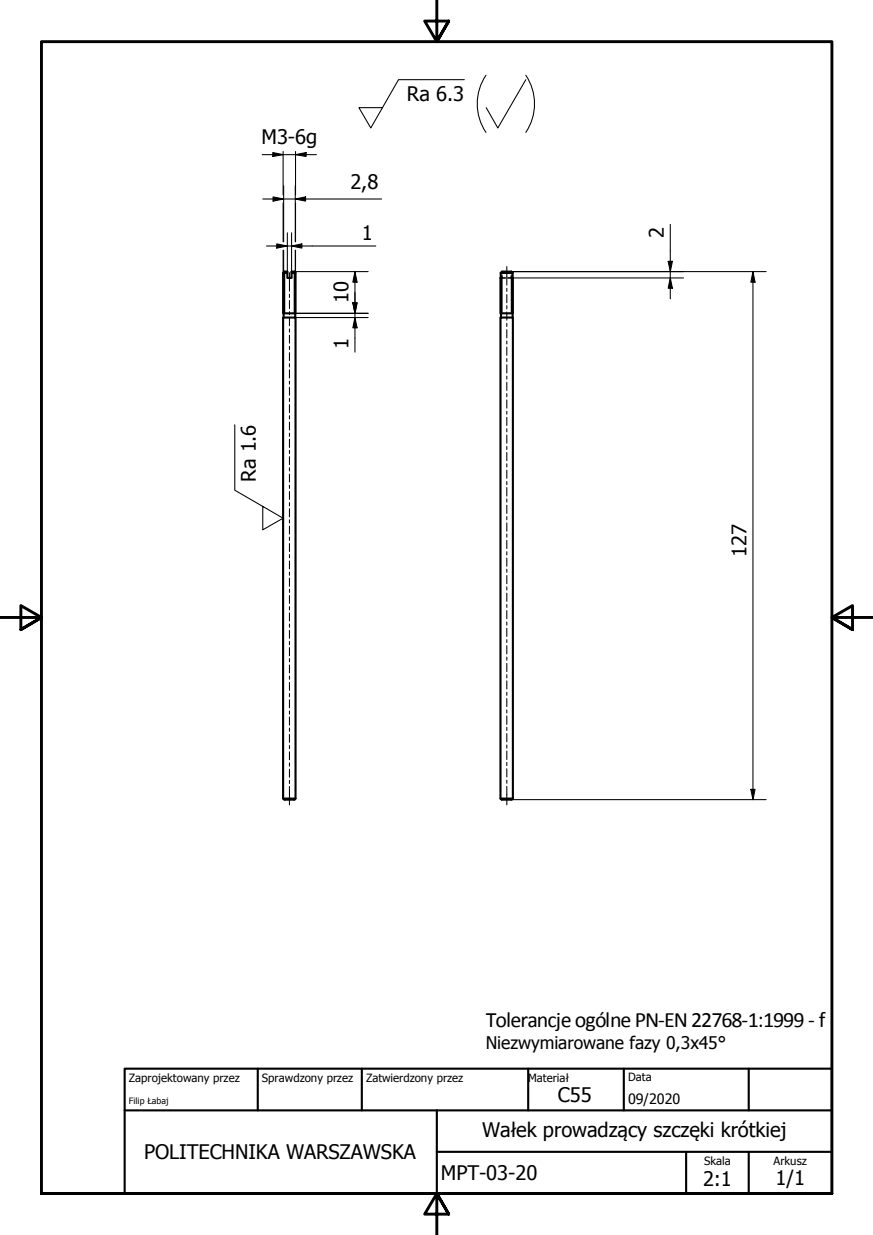
[picture p225: page 1]

Tolerancje oglne PN-EN22768-1:1999 - f
Niezwymiarowane fazy 0,3x45°

Zaprojektowany przez Filip àabaj | Sprawdzony przez | Zatwierdzony przez | Materiaá C55 | Data 09/2020

POLITECHNIKA WARSZAWSKA | Waáek prowadzcy szczki krytkiej

MPT-03-20 | Skala 2:1 | Arkusz 1/1
