f-labaj/Equatorial-Mount-MUM/Mechanika/Moduł obrotu RET Estera/prawieKoncowka/Dokumentacja_pdf/MPT-01-03-01_walekREK-1.pdf

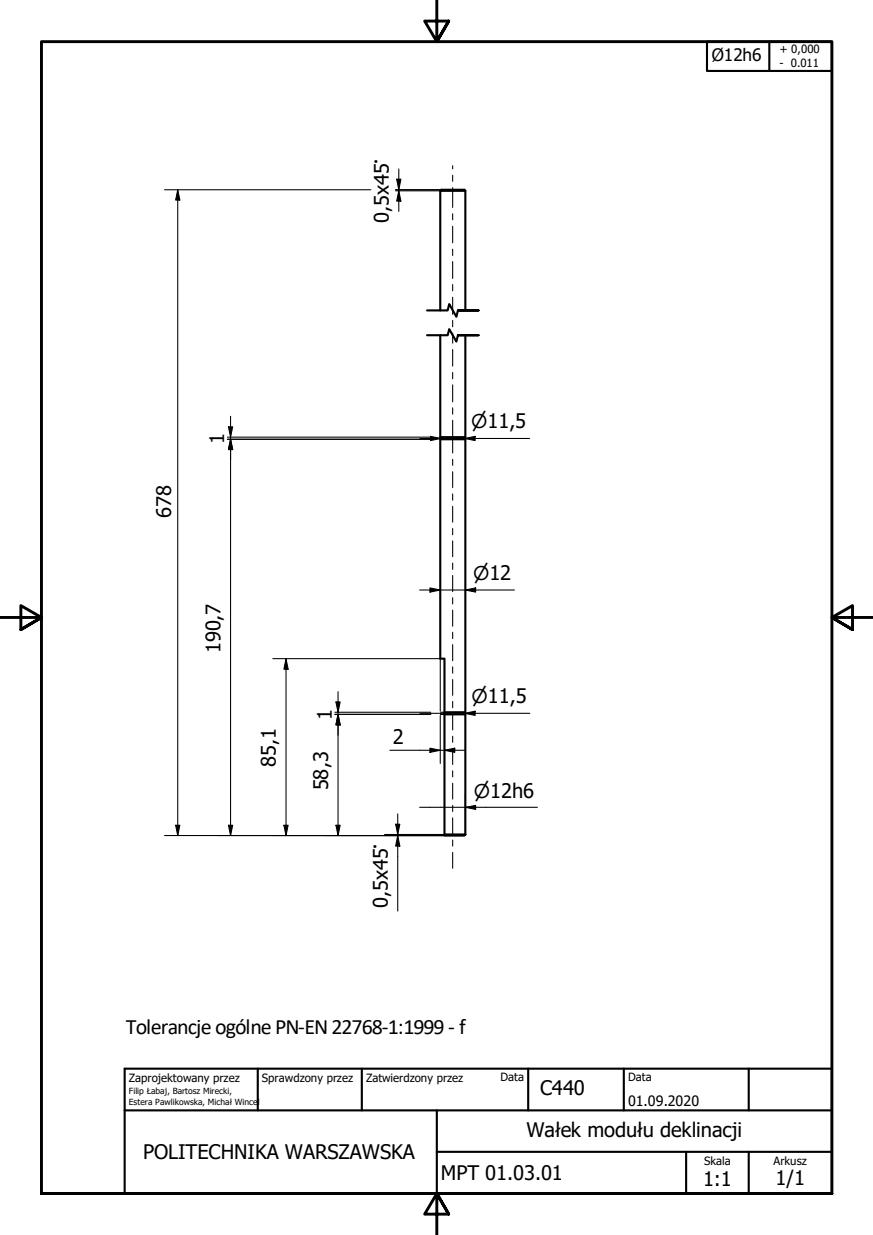
[picture p228: page 1]

Tolerancje oglne PN-EN22768-1:1999 - f

Zaprojektowany przez Filip àabaj, Bartosz Mirecki, Estera Pawlikowska, Michaá Wincel | Sprawdzony przez | Zatwierdzony przez Data | C440 | Data 01.09.2020

POLITECHNIKA WARSZAWSKA | Waáek moduáu deklinacji

MPT 01.03.01 | Skala 1:1 | Arkusz 1/1
