f-labaj/Equatorial-Mount-MUM/Mechanika/Moduł obrotu RET Estera/prawieKoncowka/Dokumentacja_pdf/MPT-01_Moduł deklinacji.pdf

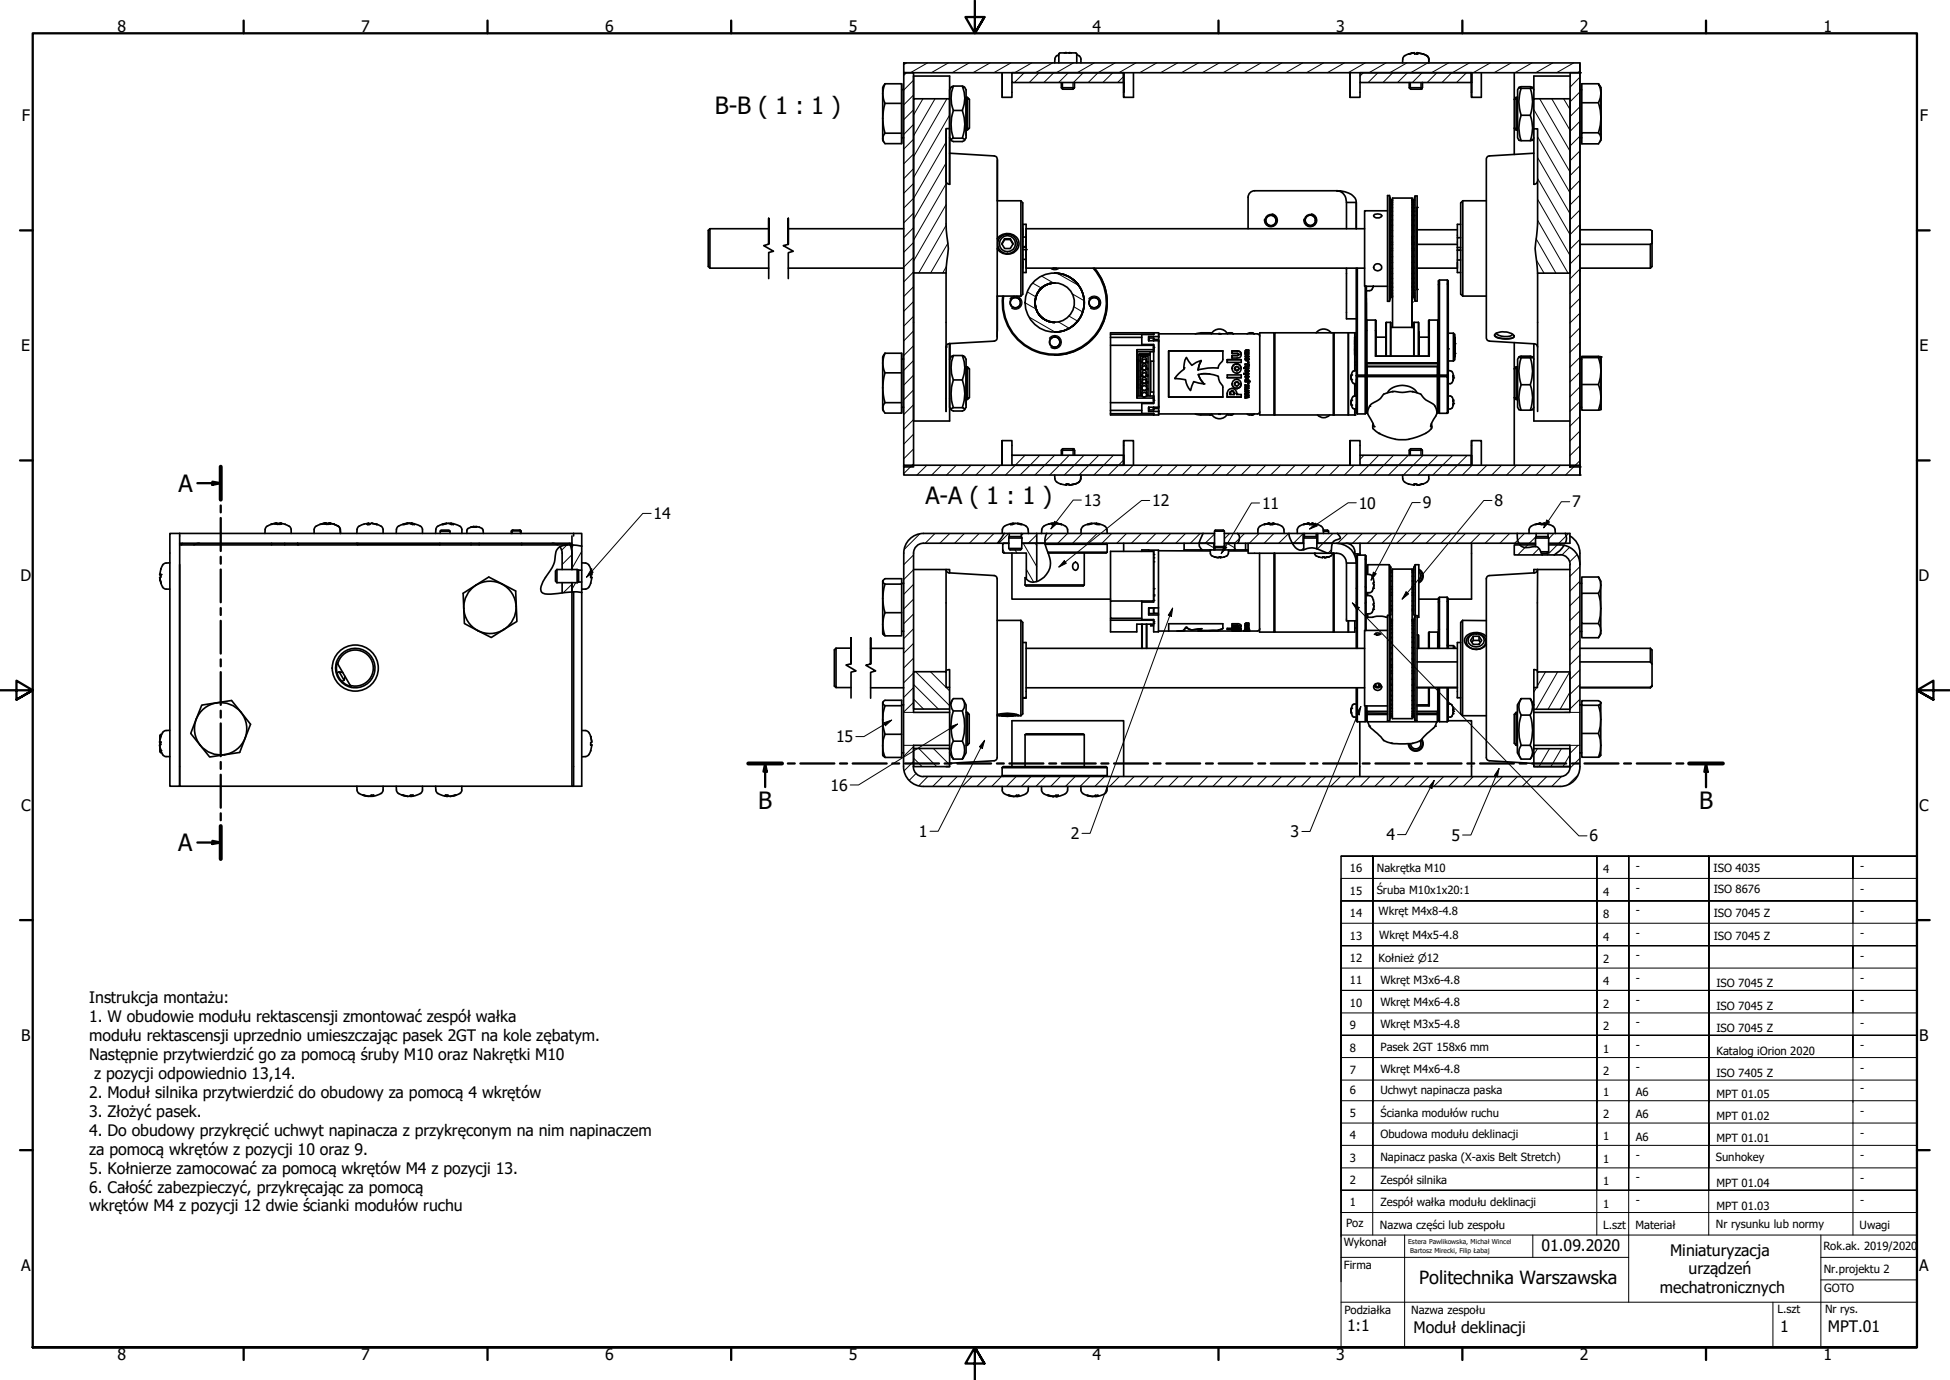
[picture p230: page 1]
Nr rys.; Moduá deklinacji; Nazwa zespoáu

16 | Nakrtka M10 | - - 4 | | ISO 4035

15 | ruba M10x1x20:1 | | - | ISO 8676 | - 4

14 | Wkrt M4x8-4.8 | 8 | - | ISO 7045 Z | -

13 | Wkrt M4x5-4.8 | 4 | - | ISO 7045 Z | -

12 | Koánie 12 | | - 2 | | -

11 | Wkrt M3x6-4.8 | 4 | - | ISO 7045 Z | -

Instrukcja montau:
1. W obudowie moduáu rektascensji zmontowaü zespyá waáka
moduáu rektascensji uprzednio umieszczajc pasek 2GT na kole zbatym.
Nastpnie przytwierdziü go za pomoc ruby M10 oraz Nakrtki M10
z pozycji odpowiednio 13,14.
2. Moduá silnika przytwierdziü do obudowy za pomoc 4 wkrtyw
3. Záoyü pasek.
4. Do obudowy przykrciü uchwyt napinacza z przykrconym na nim napinaczem
za pomoc wkrtyw z pozycji 10 oraz 9.
5. Koánierze zamocowaü za pomoc wkrtyw M4 z pozycji 13.
6. Caáoü zabezpieczyü, przykrcajc za pomoc
wkrtyw M4 z pozycji 12 dwie cianki moduáyw ruchu

10 | Wkrt M4x6-4.8 | 2 | - | ISO 7045 Z | -

9 | Wkrt M3x5-4.8 | 2 | - - | ISO 7045 Z

8 | Pasek 2GT 158x6 mm | 1 | - | Katalog iOrion 2020 | -

7 | Wkrt M4x6-4.8 | | - 2 | ISO 7405 Z | -
6 | Uchwyt napinacza paska | 1 | A6 | MPT 01.05 | -

5 | cianka moduáyw ruchu | 2 | A6 | MPT 01.02 | -

4 | Obudowa moduáu deklinacji | 1 | A6 | MPT 01.01 | -

3 | Napinacz paska (X-axis Belt Stretch) | 1 | - Sunhokey | | -

2 | Zespyá silnika | 1 | - | MPT 01.04 | -

1 | Zespyá waáka moduáu deklinacji | 1 | - | MPT 01.03 | -

Poz | Nazwa czci lub zespoáu | L.szt | Materiaá | Nr rysunku lub normy | Uwagi
Wykonaá | Estera Pawlikowska, Michaá Wincel Bartosz Mirecki, Filip àabaj | 01.09.2020 | Miniaturyzacja urzdze mechatronicznych | Rok.ak. 2019/2020
Firma | Politechnika Warszawska | | | Nr.projektu 2
