f-labaj/Equatorial-Mount-MUM/Mechanika/Moduł obrotu RET Estera/prawieKoncowka/Dokumentacja_pdf/MPT-02-03_walektymrazemkrotkiwzespole.pdf

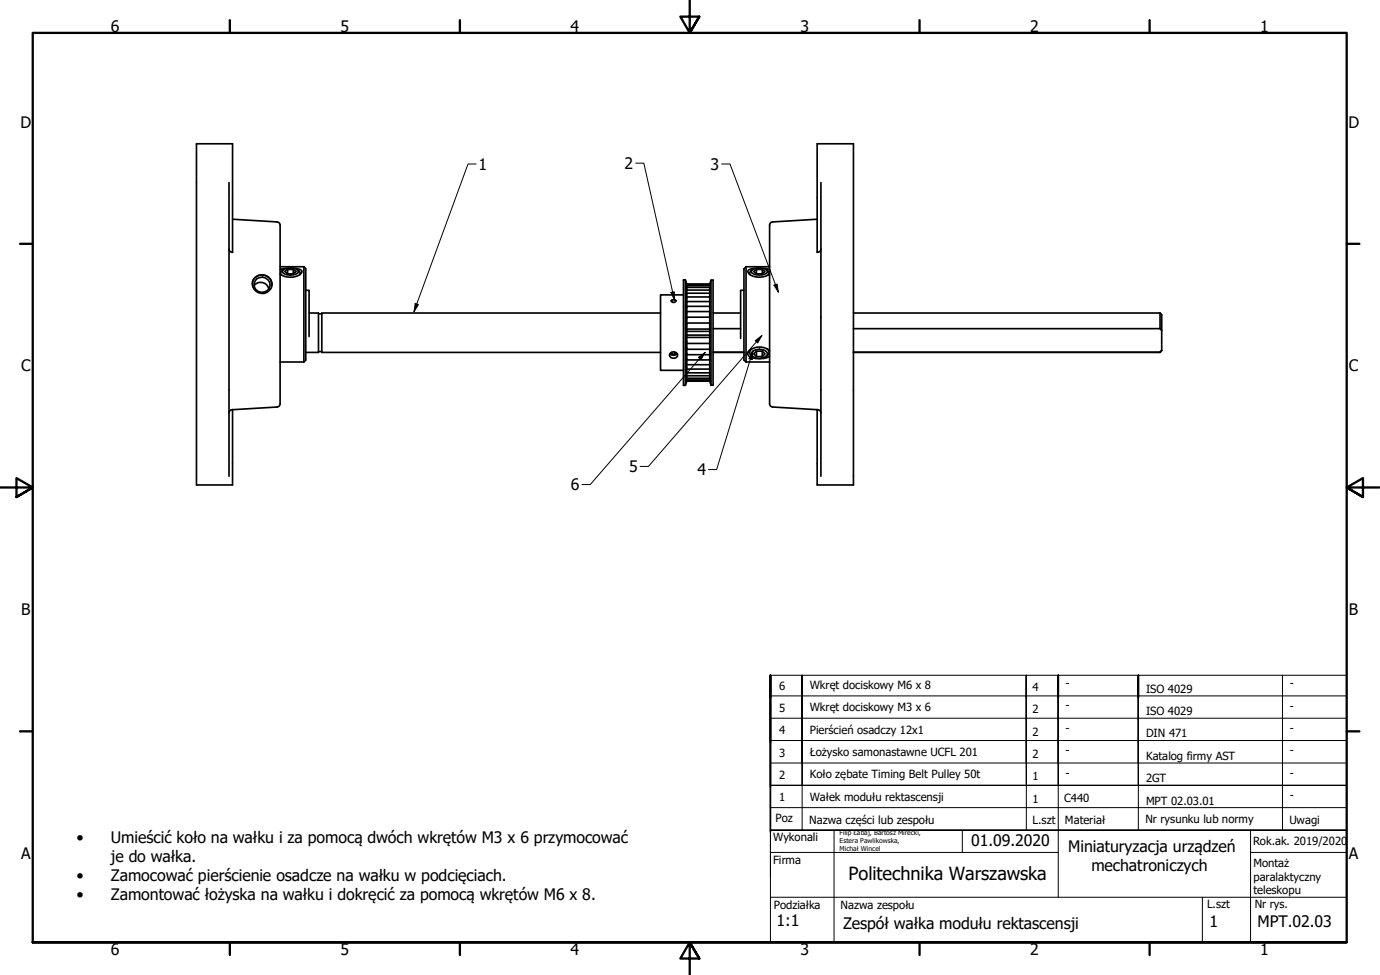
[picture p232: page 1]

6 | Wkrt dociskowy M6 x 8 | 4 | - | ISO 4029 | -

5 | Wkrt dociskowy M3 x 6 | 2 | - | ISO 4029 | -

4 | Piercie osadczy 12x1 | 2 | - | DIN 471 | -

3 | àoysko samonastawne UCFL 201 | 2 | - | Katalog firmy AST | -

2 | Koáo zbate Timing Belt Pulley 50t | 1 | - | 2GT | -

1 | Waáek moduáu rektascensji | 1 | C440 | MPT 02.03.01 | -

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

Podziaáka 1:1 | Nazwa zespoáu Zespyá waáka moduáu rektascensji | L.szt 1 | Nr rys. MPT.02.03
