f-labaj/Equatorial-Mount-MUM/Mechanika/Moduł obrotu RET Estera/prawieKoncowka/Dokumentacja_pdf/MPT-02_Moduł rektascencji.pdf

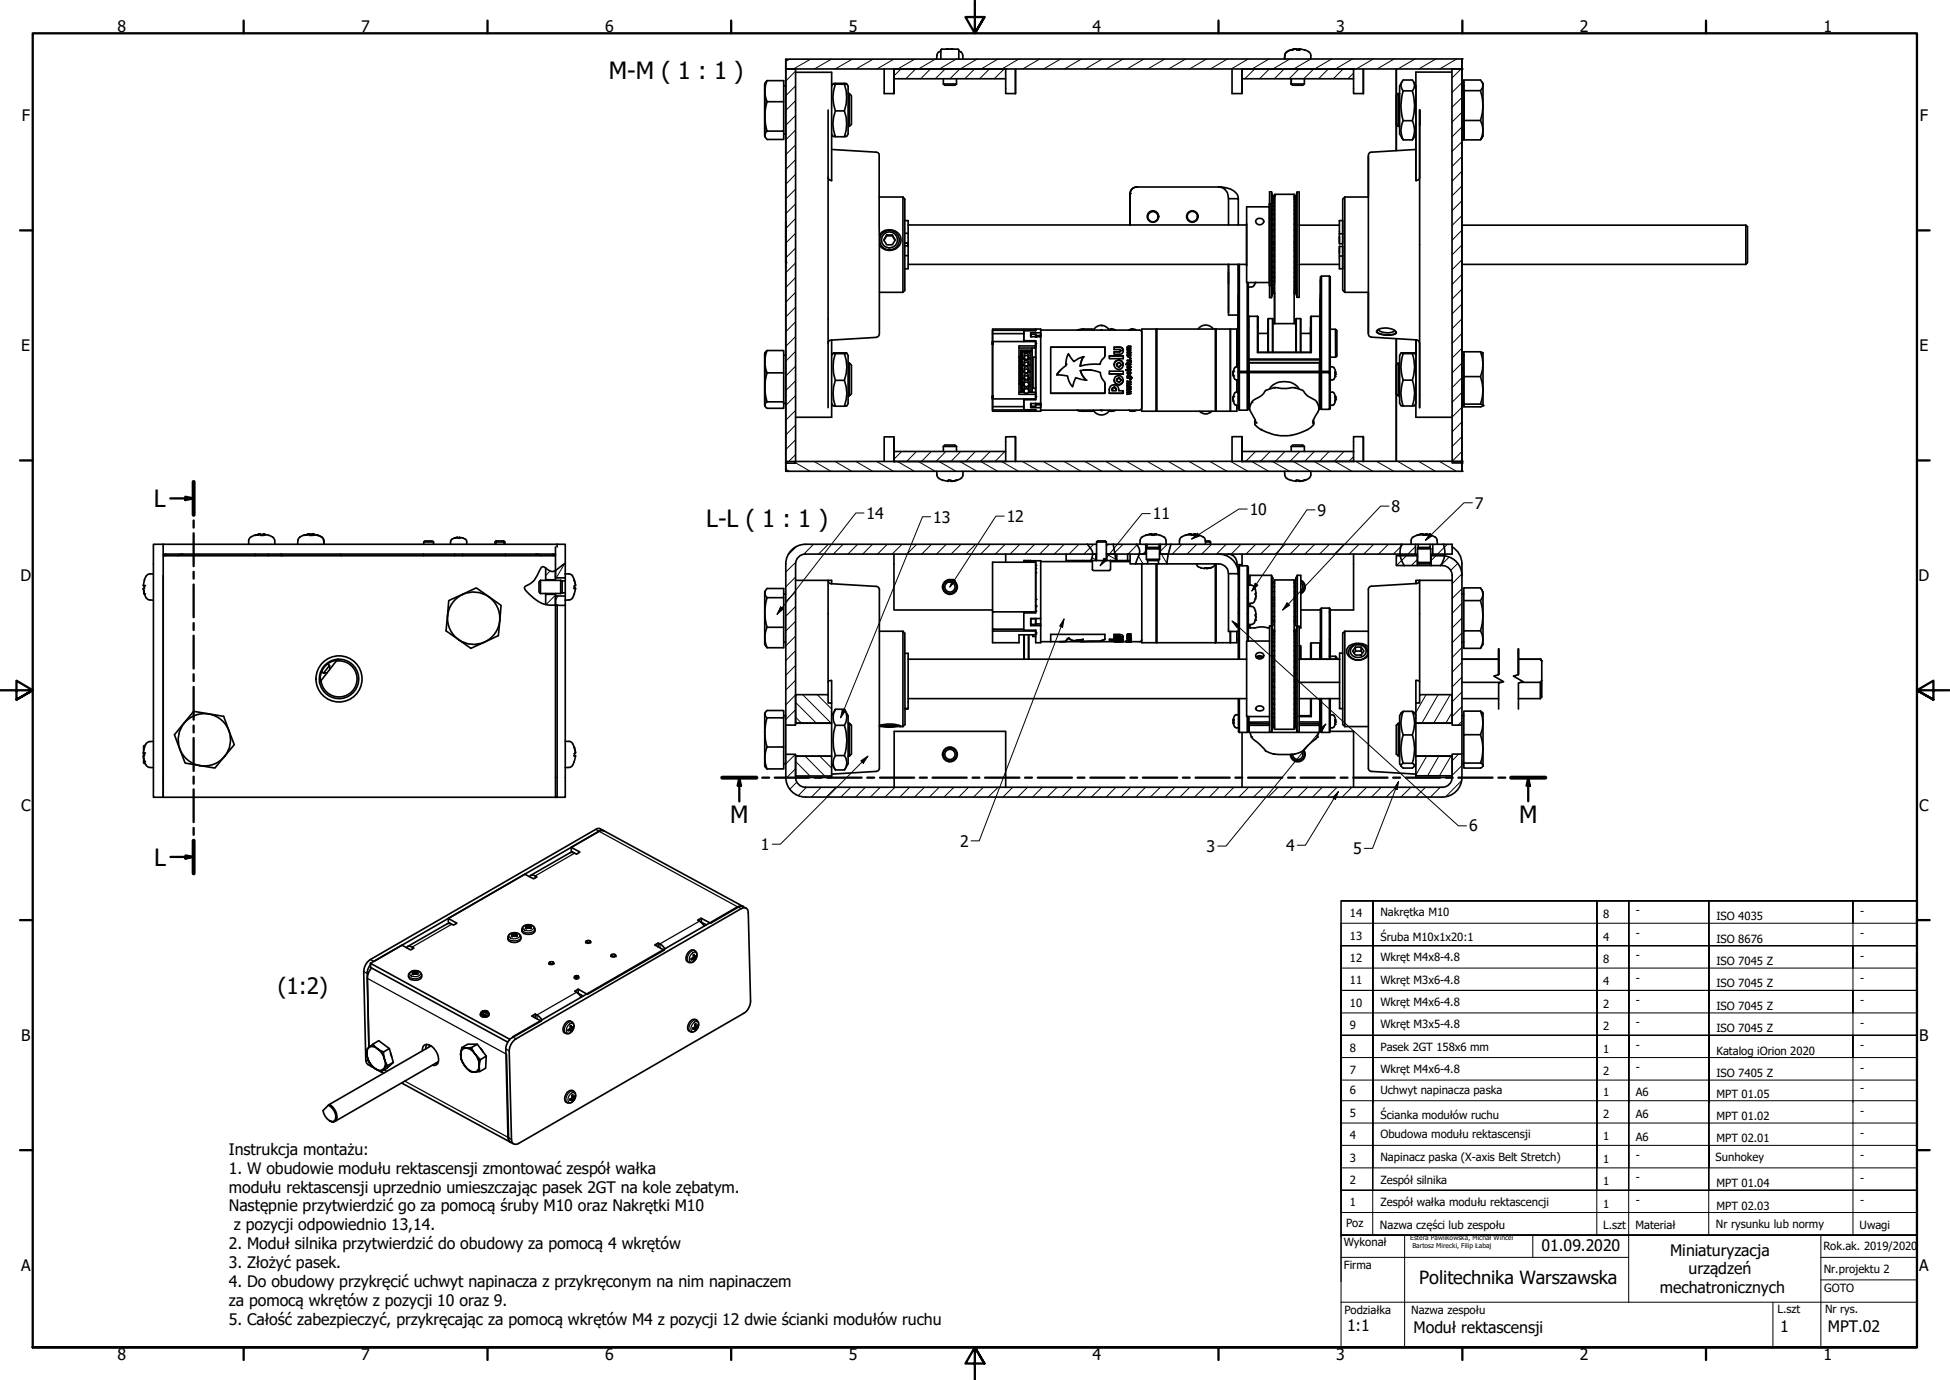
[picture p233: page 1]
Moduá rektascensji; Podziaáka; Nazwa zespoáu; Nr rys.

14 | | | - 8 | ISO 4035 Nakrtka M10 | -

ruba M10x1x20:1 | 4 | - 13 | ISO 8676 | -

12 | Wkrt M4x8-4.8 | 8 | - | ISO 7045 Z | -

11 | Wkrt M3x6-4.8 | 4 | - | ISO 7045 Z | -

10 | Wkrt M4x6-4.8 | 2 | - | ISO 7045 Z | -

9 | Wkrt M3x5-4.8 | 2 | - | ISO 7045 Z | -

8 | Pasek 2GT 158x6 mm | 1 | - | Katalog iOrion 2020 | -

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

5 | cianka moduáyw ruchu | 2 | A6 | MPT 01.02 | -

4 | Obudowa moduáu rektascensji | 1 | A6 | MPT 02.01 | -

Instrukcja montau:
1. W obudowie moduáu rektascensji zmontowaü zespyá waáka
moduáu rektascensji uprzednio umieszczajc pasek 2GT na kole zbatym.
Nastpnie przytwierdziü go za pomoc ruby M10 oraz Nakrtki M10
z pozycji odpowiednio 13,14.
2. Moduá silnika przytwierdziü do obudowy za pomoc 4 wkrtyw
3. Záoyü pasek.
4. Do obudowy przykrciü uchwyt napinacza z przykrconym na nim napinaczem
za pomoc wkrtyw z pozycji 10 oraz 9.
5. Caáoü zabezpieczyü, przykrcajc za pomoc wkrtyw M4 z pozycji 12 dwie cianki moduáyw ruchu

3 | Napinacz paska (X-axis Belt Stretch) | 1 | - | Sunhokey | -

2 | Zespyá silnika | 1 | - | MPT 01.04 | -

1 | Zespyá waáka moduáu rektascencji | 1 | - | MPT 02.03 | -

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

Firma | Politechnika Warszawska | | | Nr.projektu 2
