f-labaj/Equatorial-Mount-MUM/Mechanika/Moduł obrotu RET Estera/prawieKoncowka/Dokumentacja_pdf/MPT-04-00_trzymak.pdf

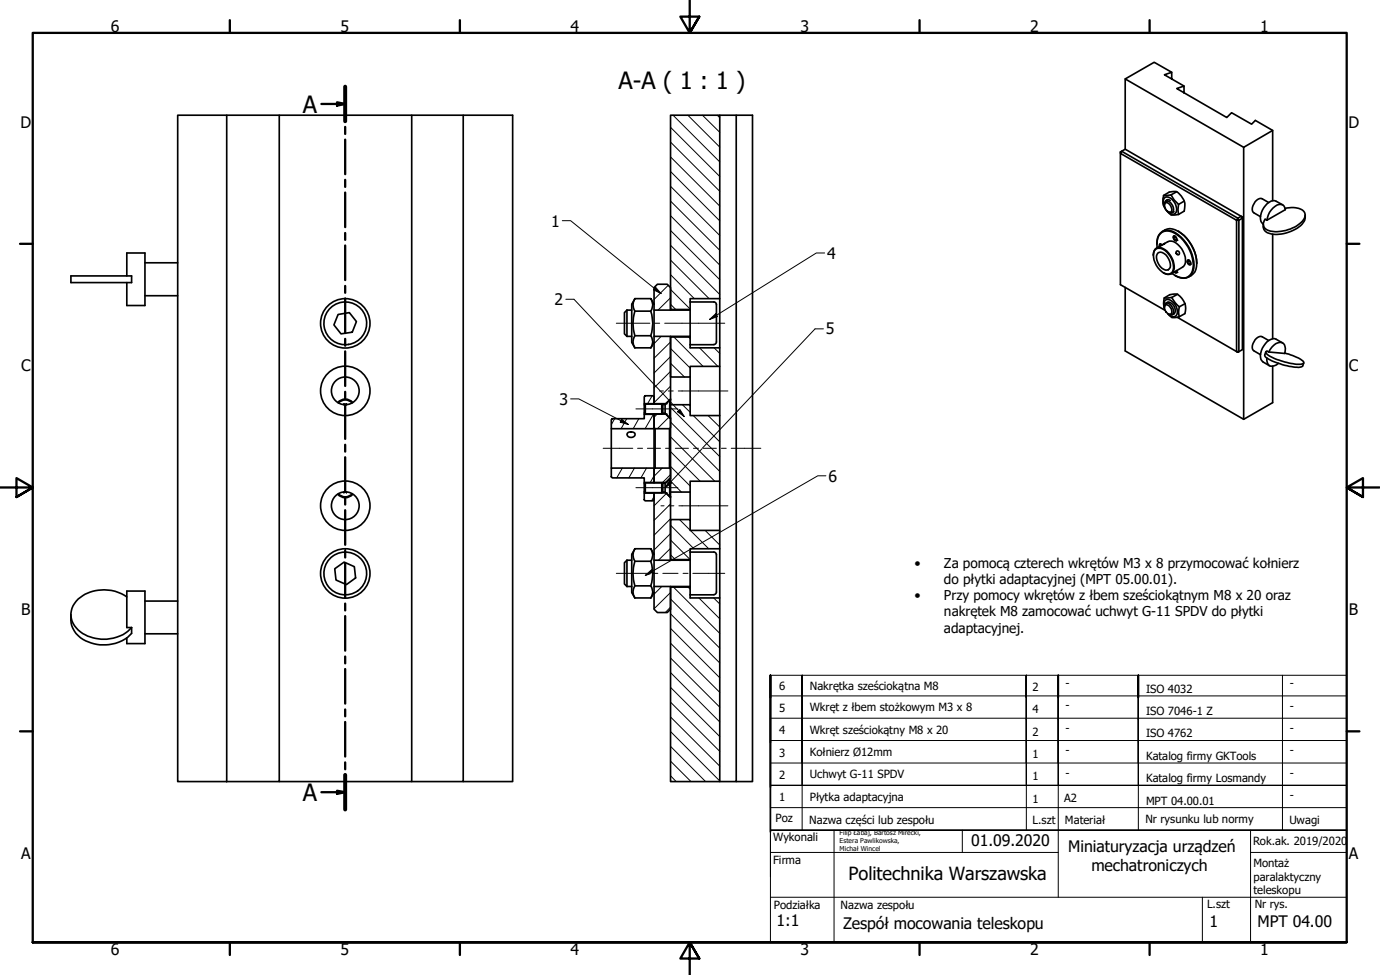
[picture p234: page 1]

• Za pomoc czterech wkrtyw M3 x 8 przymocowaü koánierz
do páytki adaptacyjnej (MPT 05.00.01).
• Przy pomocy wkrtyw z ábem szecioktnym M8 x 20 oraz
nakrtek M8 zamocowaü uchwyt G-11 SPDV do páytki
adaptacyjnej.

6 | Nakrtka szecioktna M8 | 2 | - | ISO 4032 | -

5 | Wkrt z ábem stokowym M3 x 8 | 4 | - | ISO 7046-1 Z | -

4 | Wkrt szecioktny M8 x 20 | 2 | - | ISO 4762 | -

3 | Koánierz Ø12mm | 1 | - | Katalog firmy GKTools | -

2 | Uchwyt G-11 SPDV | 1 | - | Katalog firmy Losmandy | -

1 | Páytka adaptacyjna | 1 | A2 | MPT 04.00.01 | -

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

Firma | Politechnika Warszawska | | | Monta paralaktyczny teleskopu

Podziaáka 1:1 | Nazwa zespoáu Zespyá mocowania teleskopu | L.szt 1 | Nr rys. MPT 04.00
