f-labaj/Equatorial-Mount-MUM/Mechanika/Moduł obrotu RET Estera/prawieKoncowka/Dokumentacja_pdf/MPT-05-00-01_plytkaadaptacyjna.pdf

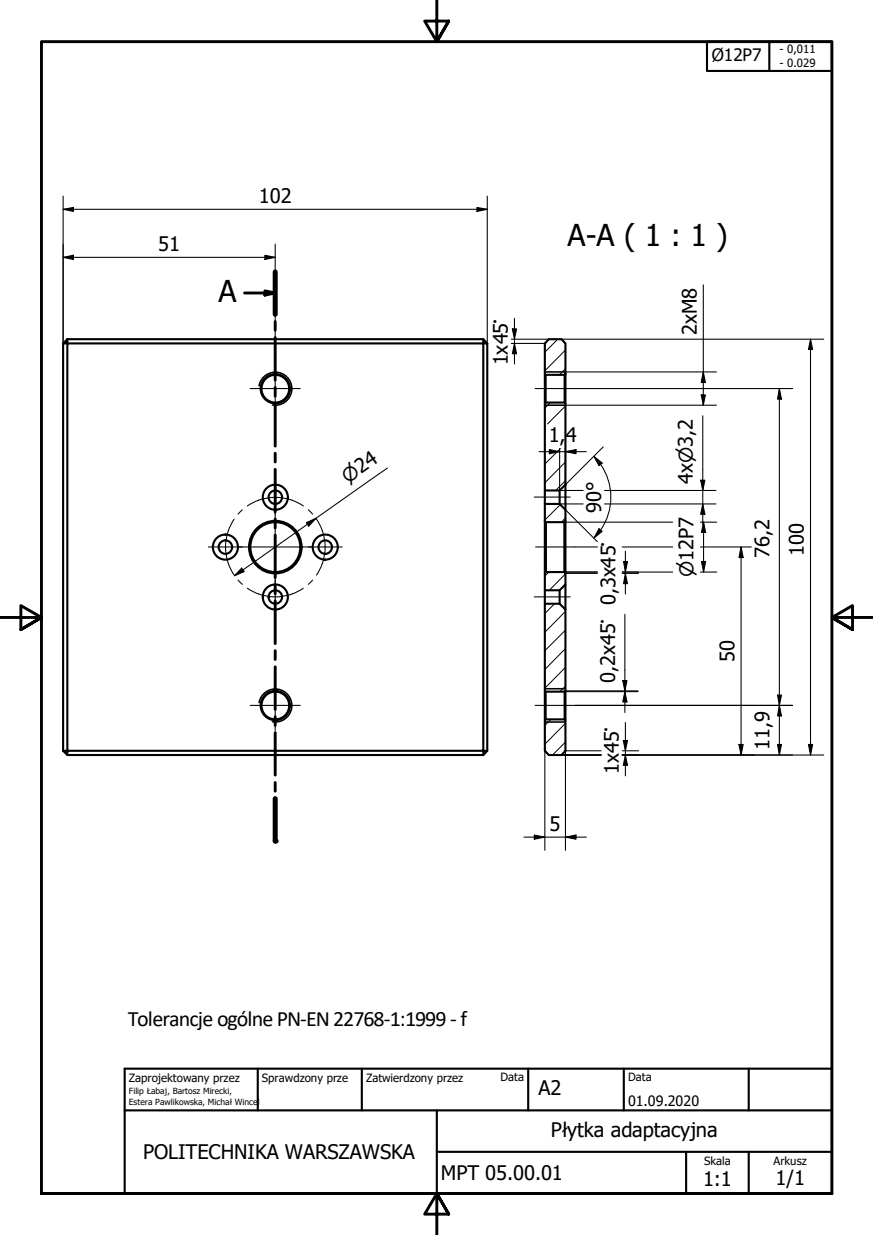
[picture p235: page 1]

Tolerancje oglne PN-EN22768-1:1999 - f

Zaprojektowany przez Filip àabaj, Bartosz Mirecki, Estera Pawlikowska, Michaá Wincel | Sprawdzony prze | Zatwierdzony przez Data | A2 | Data 01.09.2020

POLITECHNIKA WARSZAWSKA | Páytka adaptacyjna

MPT 05.00.01 | Skala 1:1 | Arkusz 1/1
