f-labaj/Equatorial-Mount-MUM/(list of files, drawings)

Other design files:
Elektronika/Schemat elektryczny.fzz
