f-labaj/Equatorial-Mount-MUM/(commit log)

2020-05-08 Add files via upload
    Initial commit of DC Motor files
    [25d-metal-gearmotor-20.4-encoder.ipt, silnik_full_assembly.iam, wal_silnika.ipt]
2020-05-08 Add files via upload
    Initial commit of gear files
    [mniejsze_kolo.ipt, wieksze_kolo.ipt]
2020-05-08 Add files via upload
    Initial old files commit
    [Assembly1.iam, main_assembly.iam, silnik_full_assembly.iam]
2020-05-08 Add files via upload
    Initial commit of mount files
    [szyna.ipt]
2020-05-08 Structure changes
    [25d-metal-gearmotor-20.4-encoder.ipt, Silnik.ipt, mniejsze_kolo.ipt, silnik_full_assembly.iam, szyna.ipt, wal_silnika.ipt, wieksze_kolo.ipt]
2020-05-09 Added drawing of mount structure schematic and tasks from 09.05.20
2020-05-15 Minimal changes to the documentation file, new links.
    [Projekt MUM 2020 - rozpiska.xlsx]
2020-05-16 Added elevation mechanism scheme and example worm gear CAD files.
    [Worm gear assly.0001.iam, Worm gear assly.iam, worm gear.ipt, worm.0001.ipt, worm.ipt]
2020-05-16 Worm gear and rack-and-pinion design links.
2020-05-16 Zmiany nazw, organizacja plik
    [25d-metal-gearmotor-20.4-encoder.ipt, Assembly1.iam, Projekt MUM 2020 - rozpiska.xlsx, Silnik.ipt, Worm gear assly.0001.iam, Worm gear assly.iam, main_assembly.iam, mniejsze_kolo.ipt]
2020-05-16 Zmiany nazw, organizacja plików
    [25d-metal-gearmotor-20.4-encoder.ipt, Assembly1.iam, Projekt MUM 2020 - rozpiska.xlsx, Silnik.ipt, Worm gear assly.0001.iam, Worm gear assly.iam, main_assembly.iam, mniejsze_kolo.ipt]
2020-05-17 Zmiany struktury folderu Mechanika, dodanie folderów części.
    [25d-metal-gearmotor-20.4-encoder.ipt, Silnik.ipt, Worm gear assly.0001.iam, Worm gear assly.iam, mniejsze_kolo.ipt, silnik_full_assembly.iam, szyna.ipt, wal_silnika.ipt]
2020-05-23 Dodanie przykładu rozwiązania mechanizmu elewacji w dziale D30 122mm
2020-08-09 Pierwsza wersja modelu CAD. Zmiany w dokumentacji 'Links.txt'.
    [Spur Gear11.0002.ipt, Spur Gear11.ipt, Spur Gear21.0001.ipt, Spur Gear21.ipt, Spur Gears1.0002.iam, Spur Gears1.iam, Worm Gear1.0001.ipt, Worm Gear1.ipt]
2020-08-09 Dodanie mechaniki korby regulującej elewację. Ogarnięcie systemu plików i .ipj-otów.
    [M10x30.0003.ipt, M10x30.ipt, Worm Gears1.0002.iam, Worm Gears1.0003.iam, Worm Gears1.iam, Worm1.0004.ipt, Worm1.0007.ipt, Worm1.ipt]
2020-08-10 Dalsze prace nad mechaniką elewacji.
    Dodanie folderu pod obudowę elektroniki.
    [Bearing1.iam, M6x6_DIN914.0001.ipt, M6x6_DIN914.ipt, Spur Gear11.0002.ipt, Spur Gear11.0004.ipt, Spur Gear11.ipt, Worm Gear1.0001.ipt, Worm Gear1.0004.ipt]
2020-08-11 Organizacja katalogowych modeli elektroniki.
    [EM406 GPS Module.IGS, EM406 GPS Module.SLDPRT, Konwerter step-down - D24V150FX.ipt, Spur Gears1.0002.iam, Spur Gears1.0003.iam, Spur Gears1.iam, Sterownik silnika - Dual TB9051FTG.ipt, Worm Gears1.0003.iam]
2020-08-15 To cały teleskop razem z plikiem Teleskop.stp
    [ANSI (cal).dwg, ANSI (cal).idw, ANSI (mm).dwg, ANSI (mm).idw, ANSI B18.6.2 - 1_4-20 UNC - 1(8).ipt, BSI.dwg, BSI.idw, BearingBall.ipt]
2020-08-16 Przesunięcie folderu Teleskop do mechaniki. Niewielkie zmiany w elewacji.
    [ANSI (cal).dwg, ANSI (cal).idw, ANSI (mm).dwg, ANSI (mm).idw, ANSI B18.6.2 - 1_4-20 UNC - 1(8).ipt, BSI.dwg, BSI.idw, BearingBall.ipt]
2020-08-16 POPRAWNY commit przesunięcia teleskopu :P
    [ANSI (cal).dwg, ANSI (cal).idw, ANSI (mm).dwg, ANSI (mm).idw, ANSI B18.6.2 - 1_4-20 UNC - 1(8).ipt, BSI.dwg, BSI.idw, BearingBall.ipt]
2020-08-21 Dalsze prace nad mechaniką modułu elewacji. Notatki i komentarze do opisu Michała.
    [16006.0001.iam, 16006.iam, 16006_PART1.0001.ipt, 16006_PART1.ipt, 16006_PART2.0001.ipt, 16006_PART2.ipt, 16006_PART3.0001.ipt, 16006_PART3.ipt]
2020-08-21 Stworzenie głównego pliku assembly do złożenia całości urządzenia. Drobne zmiany w mechanice elewacji.
    [ANSI B18.6.2 - 1_4-20 UNC - 1(8).0001.ipt, ANSI B18.6.2 - 1_4-20 UNC - 1(8).ipt, BearingBall.0005.ipt, BearingBall.ipt, Bolted Connection1.0001.iam, Bolted Connection1.0002.iam, Bolted Connection1.iam, Bolted Connection10.iam]
2020-08-21 wszystkie smieci estery
    [25d-metal-gearmotor-378-499-encoder.step, GT2 20T Pulley 5mm bore v3.step, GT2 Timing Idler Pulley, Configurable, 16T W6 B3 With T.STEP, GT2_20T-sh8.0001.ipt, GT2_20T-sh8.IGS, GT2_20T-sh8.SLDDRW, GT2_20T-sh8.SLDPRT, GT2_20T-sh8.STEP]
2020-08-27 Obudowa BM
    [25d-metal-gearmotor-378-499-encoder.ipt, GT2 pulley 60 teeth width 11mm 8mm bore.ipt, GlownaObudowa.0001.ipt, GlownaObudowa.0002.ipt, GlownaObudowa.ipt, Obudowa.iam, ZaslepkaObudowa.0001.ipt, ZaslepkaObudowa.ipt]
2020-08-27 Zmiany, zmiany, zmiany
    [15-40-19_1-12-ybrg2-124-6_747-28_5.0001.ipt, 15-40-19_1-12-ybrg2-124-6_747-28_5.ipt, 17-40-27_4-12-ybrg1-43-6_747-28_5.0001.ipt, 17-40-27_4-12-ybrg1-43-6_747-28_5.ipt, 1_4-28 SAE-LT.0001.ipt, 1_4-28 SAE-LT.ipt, 20-47-31-14-ybrg1-47-7_938-33_5.0001.ipt, 20-47-31-14-ybrg1-47-7_938-33_5.ipt]
2020-08-27 zmiany zmiany zmiany v2
    [25d-metal-gearmotor-378-499-encoder.step, GT2 20T Pulley 5mm bore v3.step, GT2 Timing Idler Pulley, Configurable, 16T W6 B3 With T.STEP, GT2_20T-sh8.0001.ipt, GT2_20T-sh8.IGS, GT2_20T-sh8.SLDDRW, GT2_20T-sh8.SLDPRT, GT2_20T-sh8.STEP]
2020-08-27 z nowym wkretem
    [ModulWalkaNapinajacego.0004.iam, ModulWalkaNapinajacego.0005.iam, ModulWalkaNapinajacego.iam, WkretDoNapinacza.0001.ipt, WkretDoNapinacza.ipt]
2020-08-27 Prawie gotowa wersja BM
    [ANSI (cal).dwg, ANSI (cal).idw, ANSI (mm).dwg, ANSI (mm).idw, BSI.dwg, BSI.idw, DIN 471 - 12 x 1(1).ipt, DIN EN ISO 7045 - M3 x 8 - 4.8 - Z.ipt]
2020-08-28 Prawie finalna wersja elewacji.
    [1_4-28 SAE-LT.0001.ipt, 1_4-28 SAE-LT.0002.ipt, 1_4-28 SAE-LT.ipt, 20-47-31-14-ybrg1-47-7_938-33_5.0001.ipt, 20-47-31-14-ybrg1-47-7_938-33_5.0002.ipt, 20-47-31-14-ybrg1-47-7_938-33_5.ipt, Base Casting.0005.ipt, Base Casting.0006.ipt]
2020-08-28 w obudowie
    [ANSI (cal).dwg, ANSI (cal).idw, ANSI (mm).dwg, ANSI (mm).idw, BSI.dwg, BSI.idw, DIN 471 - 12 x 1(1).ipt, DIN EN ISO 7045 - M3 x 8 - 4.8 - Z.ipt]
2020-08-29 Aktualizacja schematu, dokumentacji itd.
    [Schemat elektryczny.fzz]
2020-08-29 Dodano kod, dopisano dalszą część dokumentacji, poprawiono schemat eletryczny
    [Schemat elektryczny.fzz]
2020-08-29 z dokumentacja, do poprawy obudowa
    [ModulWalkaNapinajacego.0006.iam, ModulWalkaNapinajacego.iam, Moduł1.0002.iam, Moduł1.0003.iam, Moduł1.iam, Moduł3.0005.iam, Moduł3.0006.iam, Moduł3.iam]
2020-08-29 odwrotnie moduly
    [GlownaObudowa.0006.ipt, GlownaObudowa.ipt, GlownaObudowa2.0003.ipt, GlownaObudowa2.ipt, ModulDuzegoKola.0006.iam, ModulDuzegoKola.0007.iam, ModulDuzegoKola.iam, Moduł3.0006.iam]
2020-08-29 Poprawiony wałek
    [ModulDuzegoKola.0007.iam, ModulDuzegoKola.0008.iam, ModulDuzegoKola.iam, ObudowaNowa.0005.iam, ObudowaNowa.0006.iam, ObudowaNowa.iam, ObudowaNowa2.0004.iam, ObudowaNowa2.0005.iam]
2020-08-29 Obudowa elektroniki, poprawki do elewacji + hamulec, zmiana organizacji plików.
    [10 PORT HEADER.0001.ipt, 10 PORT HEADER.ipt, 102 RESISTOR PACK.0001.ipt, 102 RESISTOR PACK.ipt, 103 RESISTOR PACK.0001.ipt, 103 RESISTOR PACK.ipt, 15-40-19_1-12-ybrg2-124-6_747-28_5.0001.ipt, 15-40-19_1-12-ybrg2-124-6_747-28_5.ipt]
2020-08-30 Drobne poprawki. Dodanie indykatora poziomu.
    [Bolted Connection40.iam, Bolted Connection41.iam, Bolted Connection42.iam, Bolted Connection43.iam, Protractor Rev 01.0001.ipt, Protractor Rev 01.SLDPRT, Protractor Rev 01.ipt, obudowa_gps_bt.0005.ipt]
2020-08-30 dok 9/20
    [czescuchwytu.ipt, kolnierz.0004.ipt, kolnierz.0005.ipt, kolnierz.ipt, plytkaadaptacyjna.0001.ipt, plytkaadaptacyjna.ipt, trzymak.0003.iam, trzymak.iam]
2020-08-30 z uchwytem
    [ModulDuzegoKola.0008.iam, ModulDuzegoKola.0011.iam, ModulDuzegoKolaKrotki.0012.iam, ModulDuzegoKolaKrotki.iam, ObudowaNowa.0006.iam, ObudowaNowa.0008.iam, ObudowaNowa.iam, ObudowaNowa2.0005.iam]
2020-08-31 Obudowa zewnętrzna, przymiarki do zmian obudowy elektroniki
    [baza_blacha_gięta.0082.ipt, baza_blacha_gięta.ipt, obudowa_elektroniki_proper.0027.iam, obudowa_elektroniki_proper.iam, obudowa_zewnetrzna_przod.0004.ipt, obudowa_zewnetrzna_przod.ipt]
2020-08-31 Dodany dovetail.ipt
    [dovetail.ipt]
2020-08-31 wydłużenie pręta
    [walekREK.0009.ipt, walekREK.0010.ipt, walekREK.ipt]
2020-08-31 wszystko cacy
    [ModulDuzegoKolaKrotki.0015.iam, ModulDuzegoKolaKrotki.iam, ObudowaNowa2.0014.iam, ObudowaNowa2.iam, walekREK.0010.ipt, walekREK.ipt, zlozenieTymRazemOdwrotniezUchwytem.0020.iam, zlozenieTymRazemOdwrotniezUchwytem.iam]
2020-08-31 Finalizacja modułu elewacji. Pełna obudowa, do ostatecznej korekty z gabarytami DEK.
    [Bolted Connection44.iam, Bolted Connection45.iam, Bolted Connection46.iam, Bolted Connection47.iam, Bolted Connection48.iam, Bolted Connection49.iam, Bolted Connection50.iam, Bolted Connection51.iam]
2020-09-01 prawie koncowka
    [ANSI (in).dwg, ANSI (in).idw, ANSI (mm).dwg, ANSI (mm).idw, BSI.dwg, BSI.idw, DIN 471 - 12 x 1(1).ipt, DIN EN ISO 7045 - M3 x 8 - 4.8 - Z.ipt]
2020-09-01 Złożenie całego urządzenia. Rendery i inne bajery.
    [Bolted Connection60.iam, Bolted Connection61.iam, Bolted Connection62.iam, Bolted Connection63.iam, DIN 471 - 12 x 1(1).ipt, DIN EN ISO 7045 - M3 x 8 - 4.8 - Z.ipt, EN ISO 7045 - M2 x 6 - 4.8 - H(1).ipt, GT2_50teeth.ipt]
2020-09-01 Rysunek dokumentacji
    [GlownaObudowa.0003.dwg, GlownaObudowa.dwg]
2020-09-01 Szybkie poprawki w hamulcu.
    [Protractor Rev 01.0001.ipt, Protractor Rev 01.0002.ipt, Protractor Rev 01.ipt, dovetail.0001.ipt, dovetail.0002.ipt, dovetail.ipt, wał_hamulca.0022.ipt, wał_hamulca.0023.ipt]
2020-09-01 Symulacje, organizacja folderów itd.
    [Analiza naprężeń.stp, Bolted Connection35.0001.iam, Bolted Connection35.iam, Bolted Connection36.0001.iam, Bolted Connection36.iam, Bolted Connection37.0001.iam, Bolted Connection37.iam, Bolted Connection38.0001.iam]
2020-09-02 Rysunki techniczne
    [Moduł rektascencji.0002.dwg, Moduł rektascencji.dwg, ObudowaNowa.0016.iam, ObudowaNowa.0018.iam, ObudowaNowa.iam, zlozenieTymRazemOdwrotniezUchwytem.0025.iam, zlozenieTymRazemOdwrotniezUchwytem.0026.iam, zlozenieTymRazemOdwrotniezUchwytem.iam]
2020-09-02 wreszcie dobrze wkrety, ale polaczenie jebnelo
    [ModulSilnika.0004.idw, ModulSilnika.0005.idw, ModulSilnika.idw, ObudowaNowa.0018.iam, ObudowaNowa.0020.iam, ObudowaNowa.iam, ObudowaNowa2.0018.iam, ObudowaNowa2.0019.iam]
2020-09-03 Rysunki złożeniowe i wykonawcze. Przymiarki do symulacji w Ansysie
    [1.0047.dwg, 1.dwg, 2.0001.dwg, 2.dwg, Spur Gear21.0053.ipt, Spur Gear21.0054.ipt, Spur Gear21.ipt, Teleskop.0007.dwg]
2020-09-03 Złożeniówki modułów rektascensji i deklinacji
    [Moduł deklinacji.dwg, Moduł rektascencji.0002.dwg, Moduł rektascencji.0003.dwg, Moduł rektascencji.dwg, ObudowaNowa.0020.iam, ObudowaNowa.0021.iam, ObudowaNowa.iam, ObudowaNowa2.0019.iam]
2020-09-03 Główne złożenie, rysunki rysunki rysunki
    [1.0047.dwg, 1.0049.dwg, 1.dwg, Bolted Connection1.iam, Bolted Connection2.iam, Bolted Connection3.iam, Bolted Connection4.iam, DIN 471 - 12 x 1(1).0001.ipt]
2020-09-03 Gotowa dokumentacja
    [Moduł deklinacji.0005.dwg, Moduł deklinacji.dwg, Moduł rektascencji.0003.dwg, Moduł rektascencji.0007.dwg, Moduł rektascencji.dwg, ObudowaNowa2.0022.iam, ObudowaNowa2.iam]
2020-09-03 Symulacja wałka
    [MPT-03-01_obudowa_modulu_elewacji.0003.dwg, MPT-03-01_obudowa_modulu_elewacji.dwg, ModulDuzegoKolaKrotki.0002.iam, ModulDuzegoKolaKrotki.0003.iam, ModulDuzegoKolaKrotki.iam, ObudowaNowa2.0002.iam, ObudowaNowa2.0003.iam, ObudowaNowa2.iam]
2020-09-04 rysunki final
    [MPT-03-01_obudowa_modulu_elewacji.0003.dwg, MPT-03-01_obudowa_modulu_elewacji.0011.dwg, MPT-03-01_obudowa_modulu_elewacji.dwg, MPT-03-02_ślimak.0009.dwg, MPT-03-02_ślimak.dwg, MPT-03-03_ślimacznica.0008.dwg, MPT-03-03_ślimacznica.dwg, MPT-03-04_walek_posredni.0005.dwg]
2020-09-04 rzeczy losowe do symulacji, modele itd.
    [izolacja_pelny.iam, izolacja_pelny.igs, izolowany_wal.iam, izolowany_wal.igs]
2020-09-04 Dokumentacja, ostateczne rysunki i ich połączenie. Rendery w dużych ilościach.
    [Battery 18650.0001.ipt, Battery 18650.0002.ipt, Battery 18650.ipt, Bolted Connection35.0001.iam, Bolted Connection35.0002.iam, Bolted Connection35.iam, Bolted Connection36.0001.iam, Bolted Connection36.0002.iam]
2020-09-08 Ostateczny commit.
    [MPT_main_assembly.0018.dwg, MPT_main_assembly.dwg]
